Masterltb/pcb/docs/references/pololu-d24v25fx-pinout.jpg

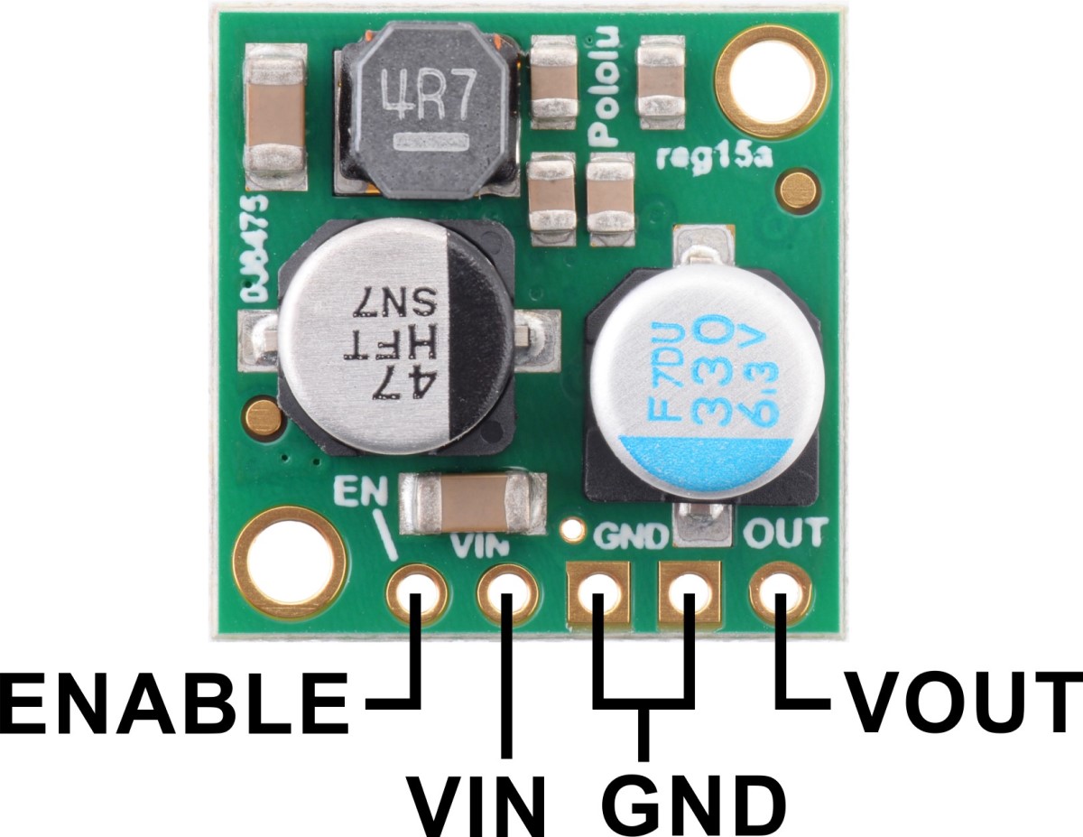
docs/references/pololu-d24v25fx-pinout.jpg
