Masterltb/pcb/FV-CTRL_RevA_Handover/02_Technical_Review/DRC_Report_Mainboard.txt

** Drc report for FV-CTRL_RevA.kicad_pcb **
** Created on 2026-10-18T18:54:26 **
** Report includes: Errors, Warnings, Exclusions **

** Found 539 DRC violations **
[shorting_items]: Items shorting two nets (nets GND and ESP_EN)
    Local override; error
    @(144.2900 mm, 189.5000 mm): Via [GND] on F.Cu - B.Cu
    @(139.0000 mm, 190.0000 mm): Track [ESP_EN] on F.Cu, length 6.5000 mm
[clearance]: Clearance violation ( clearance 0.2000 mm; actual 0.1325 mm)
    Local override; error
    @(137.0000 mm, 172.0000 mm): Via [GND] on F.Cu - B.Cu
    @(141.0000 mm, 172.2000 mm): Track [ESP_EN] on F.Cu, length 3.4000 mm
[shorting_items]: Items shorting two nets (nets GND and +3V3)
    Local override; error
    @(136.0000 mm, 142.5000 mm): Via [GND] on F.Cu - B.Cu
    @(137.2000 mm, 142.4000 mm): Track [+3V3] on F.Cu, length 5.8000 mm
[shorting_items]: Items shorting two nets (nets +12V and IR_RX1)
    Local override; error
    @(114.2000 mm, 140.2000 mm): Track [+12V] on F.Cu, length 3.8000 mm
    @(128.4000 mm, 139.6000 mm): Track [IR_RX1] on F.Cu, length 20.4002 mm
[tracks_crossing]: Tracks crossing
    Local override; error
    @(131.4000 mm, 157.0000 mm): Track [+3V3] on F.Cu, length 11.0000 mm
    @(139.0000 mm, 159.6000 mm): Track [ADC_VP] on F.Cu, length 9.0002 mm
[clearance]: Clearance violation ( clearance 0.2000 mm; actual 0.1250 mm)
    Local override; error
    @(144.2900 mm, 187.5100 mm): Track [GND] on F.Cu, length 1.9900 mm
    @(139.0000 mm, 190.0000 mm): Track [ESP_EN] on F.Cu, length 6.5000 mm
[shorting_items]: Items shorting two nets (nets ESP_EN and GND)
    Local override; error
    @(145.5000 mm, 190.0000 mm): PTH pad 1 [ESP_EN] of SW1
    @(144.2900 mm, 189.5000 mm): Via [GND] on F.Cu - B.Cu
[tracks_crossing]: Tracks crossing
    Local override; error
    @(139.0000 mm, 162.0000 mm): Track [ADC_VN] on B.Cu, length 9.0004 mm
    @(136.2000 mm, 169.4000 mm): Track [EXP_IO13] on B.Cu, length 10.4000 mm
[shorting_items]: Items shorting two nets (nets EXP_IO13 and GND)
    Local override; error
    @(137.4000 mm, 173.0000 mm): Track [EXP_IO13] on B.Cu, length 3.6000 mm
    @(137.0000 mm, 172.0000 mm): Via [GND] on F.Cu - B.Cu
[clearance]: Clearance violation ( clearance 0.2000 mm; actual 0.1850 mm)
    Local override; error
    @(145.6000 mm, 186.4000 mm): Track [EXP_IO13] on F.Cu, length 3.0000 mm
    @(144.2900 mm, 187.5100 mm): Pad 15 [GND] of U2 on F.Cu
[tracks_crossing]: Tracks crossing
    Local override; error
    @(115.0000 mm, 136.0000 mm): Track [+12V] on F.Cu, length 4.2000 mm
    @(128.4000 mm, 139.6000 mm): Track [IR_RX1] on F.Cu, length 20.4002 mm
[clearance]: Clearance violation ( clearance 0.2000 mm; actual 0.1674 mm)
    Local override; error
    @(141.0000 mm, 176.1000 mm): Pad 6 [IR_RX1] of U2 on F.Cu
    @(139.8000 mm, 177.0000 mm): Via [IR_RX2] on F.Cu - B.Cu
[clearance]: Clearance violation ( clearance 0.2000 mm; actual 0.1766 mm)
    Local override; error
    @(141.0000 mm, 179.9100 mm): Pad 9 [SPARE_GPIO33] of U2 on F.Cu
    @(139.8000 mm, 179.0000 mm): Via [LS4] on F.Cu - B.Cu
[clearance]: Clearance violation ( clearance 0.2000 mm; actual 0.1500 mm)
    Local override; error
    @(139.8000 mm, 180.0000 mm): Via [SPARE_GPIO33] on F.Cu - B.Cu
    @(139.8000 mm, 180.8000 mm): Via [LS1] on F.Cu - B.Cu
[tracks_crossing]: Tracks crossing
    Local override; error
    @(161.4000 mm, 170.8000 mm): Track [ESP_IR_TX] on F.Cu, length 13.4000 mm
    @(159.0000 mm, 169.7500 mm): Track [GND] on F.Cu, length 2.5000 mm
[clearance]: Clearance violation ( clearance 0.2000 mm; actual 0.1500 mm)
    Local override; error
    @(139.8000 mm, 180.0000 mm): Via [SPARE_GPIO33] on F.Cu - B.Cu
    @(139.8000 mm, 180.8000 mm): Via [LS1] on F.Cu - B.Cu
[clearance]: Clearance violation ( clearance 0.2000 mm; actual 0.1583 mm)
    Local override; error
    @(141.0000 mm, 179.9100 mm): Pad 9 [SPARE_GPIO33] of U2 on F.Cu
    @(139.8000 mm, 180.8000 mm): Via [LS1] on F.Cu - B.Cu
[clearance]: Clearance violation ( clearance 0.2000 mm; actual 0.1746 mm)
    Local override; error
    @(160.6000 mm, 184.6000 mm): Via [EXP_IO4] on F.Cu - B.Cu
    @(161.4000 mm, 184.8000 mm): Via [ESP_TXD0] on F.Cu - B.Cu
[clearance]: Clearance violation ( clearance 0.2000 mm; actual 0.1746 mm)
    Local override; error
    @(160.6000 mm, 184.6000 mm): Via [EXP_IO4] on F.Cu - B.Cu
    @(161.4000 mm, 184.8000 mm): Via [ESP_TXD0] on F.Cu - B.Cu
[clearance]: Clearance violation ( clearance 0.2000 mm; actual 0.1009 mm)
    Local override; error
    @(137.6000 mm, 172.2000 mm): Track [ESP_EN] on F.Cu, length 4.2000 mm
    @(137.0000 mm, 172.0000 mm): Via [GND] on F.Cu - B.Cu
[tracks_crossing]: Tracks crossing
    Local override; error
    @(137.2000 mm, 142.4000 mm): Track [+3V3] on F.Cu, length 5.8000 mm
    @(136.0000 mm, 140.0000 mm): Track [GND] on F.Cu, length 2.5000 mm
[tracks_crossing]: Tracks crossing
    Local override; error
    @(133.4000 mm, 156.6000 mm): Track [+3V3] on F.Cu, length 13.2000 mm
    @(139.0000 mm, 159.6000 mm): Track [ADC_VP] on F.Cu, length 9.0002 mm
[tracks_crossing]: Tracks crossing
    Local override; error
    @(150.6000 mm, 154.6000 mm): Track [+3V3] on F.Cu, length 15.6000 mm
    @(164.7800 mm, 156.0000 mm): Track [GND] on F.Cu, length 2.5000 mm
[tracks_crossing]: Tracks crossing
    Local override; error
    @(117.4000 mm, 138.6000 mm): Track [+5V] on F.Cu, length 19.2000 mm
    @(128.4000 mm, 139.6000 mm): Track [IR_RX1] on F.Cu, length 20.4002 mm
[shorting_items]: Items shorting two nets (nets +12V and IR_RX1)
    Local override; error
    @(115.0000 mm, 140.2000 mm): Track [+12V] on F.Cu, length 0.8000 mm
    @(128.4000 mm, 139.6000 mm): Track [IR_RX1] on F.Cu, length 20.4002 mm
[shorting_items]: Items shorting two nets (nets GND and ADC_VN)
    Local override; error
    @(138.5000 mm, 169.7500 mm): Via [GND] on F.Cu - B.Cu
    @(139.0000 mm, 174.6000 mm): Track [ADC_VN] on B.Cu, length 12.6000 mm
[shorting_items]: Items shorting two nets (nets GND and +5V)
    Local override; error
    @(132.0000 mm, 141.0000 mm): PTH pad 2 [GND] of C11
    @(131.0000 mm, 140.0000 mm): PTH pad 1 [+5V] of C5
[shorting_items]: Items shorting two nets (nets GND and +5V)
    Local override; error
    @(132.0000 mm, 141.0000 mm): PTH pad 2 [GND] of C11
    @(131.0000 mm, 140.0000 mm): PTH pad 1 [+5V] of C5
[hole_clearance]: Hole clearance violation (board setup constraints hole clearance 0.2500 mm; actual 0.1342 mm)
    Rule: board setup constraints hole; error
    @(145.5000 mm, 190.0000 mm): PTH pad 1 [ESP_EN] of SW1
    @(144.2900 mm, 189.5000 mm): Via [GND] on F.Cu - B.Cu
[hole_clearance]: Hole clearance violation (board setup constraints hole clearance 0.2500 mm; actual 0.1342 mm)
    Rule: board setup constraints hole; error
    @(145.5000 mm, 190.0000 mm): PTH pad 1 [ESP_EN] of SW1
    @(144.2900 mm, 189.5000 mm): Via [GND] on F.Cu - B.Cu
[pth_inside_courtyard]: PTH inside courtyard
    Local override; error
    @(114.7300 mm, 143.9200 mm): PTH pad 1 [+12V] of J4
    @(116.0000 mm, 142.0000 mm): Footprint C6
[courtyards_overlap]: Courtyards overlap
    Rule: board setup constraints courtyard; error
    @(115.0000 mm, 107.0000 mm): Footprint J1
    @(124.0000 mm, 114.0000 mm): Footprint F1
[courtyards_overlap]: Courtyards overlap
    Rule: board setup constraints courtyard; error
    @(147.0000 mm, 156.0000 mm): Footprint J22
    @(150.0000 mm, 178.0000 mm): Footprint U2
[pth_inside_courtyard]: PTH inside courtyard
    Local override; error
    @(147.0000 mm, 156.0000 mm): PTH pad 1 [+5V] of J22
    @(150.0000 mm, 178.0000 mm): Footprint U2
[pth_inside_courtyard]: PTH inside courtyard
    Local override; error
    @(149.5400 mm, 156.0000 mm): PTH pad 2 [+3V3] of J22
    @(150.0000 mm, 178.0000 mm): Footprint U2
[pth_inside_courtyard]: PTH inside courtyard
    Local override; error
    @(152.0800 mm, 156.0000 mm): PTH pad 3 [EXP_IO4] of J22
    @(150.0000 mm, 178.0000 mm): Footprint U2
[pth_inside_courtyard]: PTH inside courtyard
    Local override; error
    @(154.6200 mm, 156.0000 mm): PTH pad 4 [EXP_IO5] of J22
    @(150.0000 mm, 178.0000 mm): Footprint U2
[pth_inside_courtyard]: PTH inside courtyard
    Local override; error
    @(157.1600 mm, 156.0000 mm): PTH pad 5 [EXP_IO13] of J22
    @(150.0000 mm, 178.0000 mm): Footprint U2
[pth_inside_courtyard]: PTH inside courtyard
    Local override; error
    @(159.7000 mm, 156.0000 mm): PTH pad 6 [EXP_IO14] of J22
    @(150.0000 mm, 178.0000 mm): Footprint U2
[pth_inside_courtyard]: PTH inside courtyard
    Local override; error
    @(162.2400 mm, 156.0000 mm): PTH pad 7 [EXP_IO2] of J22
    @(150.0000 mm, 178.0000 mm): Footprint U2
[pth_inside_courtyard]: PTH inside courtyard
    Local override; error
    @(164.7800 mm, 156.0000 mm): PTH pad 8 [GND] of J22
    @(150.0000 mm, 178.0000 mm): Footprint U2
[courtyards_overlap]: Courtyards overlap
    Rule: board setup constraints courtyard; error
    @(166.0000 mm, 190.0000 mm): Footprint R11
    @(171.0000 mm, 189.0000 mm): Footprint R1
[pth_inside_courtyard]: PTH inside courtyard
    Local override; error
    @(171.0000 mm, 189.0000 mm): PTH pad 1 [ESP_S1_TOP_PWM] of R1
    @(166.0000 mm, 190.0000 mm): Footprint R11
[pth_inside_courtyard]: PTH inside courtyard
    Local override; error
    @(173.6200 mm, 190.0000 mm): PTH pad 2 [ESP_IO0] of R11
    @(171.0000 mm, 189.0000 mm): Footprint R1
[courtyards_overlap]: Courtyards overlap
    Rule: board setup constraints courtyard; error
    @(194.0000 mm, 182.0000 mm): Footprint J6
    @(194.0000 mm, 175.0000 mm): Footprint J7
[pth_inside_courtyard]: PTH inside courtyard
    Local override; error
    @(194.0000 mm, 180.0800 mm): PTH pad 3 [S2_TOP_PWM] of J7
    @(194.0000 mm, 182.0000 mm): Footprint J6
[pth_inside_courtyard]: PTH inside courtyard
    Local override; error
    @(194.0000 mm, 182.0000 mm): PTH pad 1 [GND] of J6
    @(194.0000 mm, 175.0000 mm): Footprint J7
[courtyards_overlap]: Courtyards overlap
    Rule: board setup constraints courtyard; error
    @(194.0000 mm, 182.0000 mm): Footprint J6
    @(194.0000 mm, 189.0000 mm): Footprint J5
[pth_inside_courtyard]: PTH inside courtyard
    Local override; error
    @(194.0000 mm, 189.0000 mm): PTH pad 1 [GND] of J5
    @(194.0000 mm, 182.0000 mm): Footprint J6
[pth_inside_courtyard]: PTH inside courtyard
    Local override; error
    @(194.0000 mm, 187.0800 mm): PTH pad 3 [S1_BOT_PWM] of J6
    @(194.0000 mm, 189.0000 mm): Footprint J5
[courtyards_overlap]: Courtyards overlap
    Rule: board setup constraints courtyard; error
    @(194.0000 mm, 168.0000 mm): Footprint J8
    @(194.0000 mm, 175.0000 mm): Footprint J7
[pth_inside_courtyard]: PTH inside courtyard
    Local override; error
    @(194.0000 mm, 175.0000 mm): PTH pad 1 [GND] of J7
    @(194.0000 mm, 168.0000 mm): Footprint J8
[pth_inside_courtyard]: PTH inside courtyard
    Local override; error
    @(194.0000 mm, 173.0800 mm): PTH pad 3 [S2_BOT_PWM] of J8
    @(194.0000 mm, 175.0000 mm): Footprint J7
[courtyards_overlap]: Courtyards overlap
    Rule: board setup constraints courtyard; error
    @(171.0000 mm, 168.0000 mm): Footprint R4
    @(150.0000 mm, 178.0000 mm): Footprint U2
[pth_inside_courtyard]: PTH inside courtyard
    Local override; error
    @(171.0000 mm, 168.0000 mm): PTH pad 1 [ESP_S2_BOT_PWM] of R4
    @(150.0000 mm, 178.0000 mm): Footprint U2
[courtyards_overlap]: Courtyards overlap
    Rule: board setup constraints courtyard; error
    @(186.0000 mm, 148.0000 mm): Footprint F3
    @(186.0000 mm, 156.0000 mm): Footprint C2
[courtyards_overlap]: Courtyards overlap
    Rule: board setup constraints courtyard; error
    @(124.0000 mm, 134.0000 mm): Footprint R23
    @(115.0000 mm, 136.0000 mm): Footprint D1
[pth_inside_courtyard]: PTH inside courtyard
    Local override; error
    @(127.7000 mm, 136.0000 mm): PTH pad 2 [GND] of D1
    @(124.0000 mm, 134.0000 mm): Footprint R23
[pth_inside_courtyard]: PTH inside courtyard
    Local override; error
    @(124.0000 mm, 134.0000 mm): PTH pad 1 [+5V] of R23
    @(115.0000 mm, 136.0000 mm): Footprint D1
[courtyards_overlap]: Courtyards overlap
    Rule: board setup constraints courtyard; error
    @(127.0000 mm, 166.0000 mm): Footprint Q2
    @(130.0000 mm, 157.0000 mm): Footprint J21
[courtyards_overlap]: Courtyards overlap
    Rule: board setup constraints courtyard; error
    @(127.0000 mm, 166.0000 mm): Footprint Q2
    @(150.0000 mm, 178.0000 mm): Footprint U2
[pth_inside_courtyard]: PTH inside courtyard
    Local override; error
    @(127.0000 mm, 166.0000 mm): PTH pad 1 [GND] of Q2
    @(150.0000 mm, 178.0000 mm): Footprint U2
[pth_inside_courtyard]: PTH inside courtyard
    Local override; error
    @(127.0000 mm, 164.7300 mm): PTH pad 2 [NET_Q2_BASE] of Q2
    @(150.0000 mm, 178.0000 mm): Footprint U2
[pth_inside_courtyard]: PTH inside courtyard
    Local override; error
    @(127.0000 mm, 163.4600 mm): PTH pad 3 [IR_TX_RET] of Q2
    @(150.0000 mm, 178.0000 mm): Footprint U2
[courtyards_overlap]: Courtyards overlap
    Rule: board setup constraints courtyard; error
    @(127.0000 mm, 166.0000 mm): Footprint Q2
    @(130.0000 mm, 168.0000 mm): Footprint R10
[courtyards_overlap]: Courtyards overlap
    Rule: board setup constraints courtyard; error
    @(196.0000 mm, 196.0000 mm): Footprint H4
    @(194.0000 mm, 189.0000 mm): Footprint J5
[pth_inside_courtyard]: PTH inside courtyard
    Local override; error
    @(194.0000 mm, 194.0800 mm): PTH pad 3 [S1_TOP_PWM] of J5
    @(196.0000 mm, 196.0000 mm): Footprint H4
[npth_inside_courtyard]: NPTH inside courtyard
    Local override; error
    @(196.0000 mm, 196.0000 mm): NPTH pad of H4
    @(194.0000 mm, 189.0000 mm): Footprint J5
[courtyards_overlap]: Courtyards overlap
    Rule: board setup constraints courtyard; error
    @(108.0000 mm, 195.0000 mm): Footprint TP6
    @(104.0000 mm, 196.0000 mm): Footprint H3
[courtyards_overlap]: Courtyards overlap
    Rule: board setup constraints courtyard; error
    @(130.0000 mm, 157.0000 mm): Footprint J21
    @(127.0000 mm, 158.0000 mm): Footprint R13
[courtyards_overlap]: Courtyards overlap
    Rule: board setup constraints courtyard; error
    @(130.0000 mm, 157.0000 mm): Footprint J21
    @(150.0000 mm, 178.0000 mm): Footprint U2
[pth_inside_courtyard]: PTH inside courtyard
    Local override; error
    @(130.0000 mm, 157.0000 mm): PTH pad 1 [+3V3] of J21
    @(150.0000 mm, 178.0000 mm): Footprint U2
[pth_inside_courtyard]: PTH inside courtyard
    Local override; error
    @(130.0000 mm, 159.5400 mm): PTH pad 2 [ADC_VP] of J21
    @(150.0000 mm, 178.0000 mm): Footprint U2
[pth_inside_courtyard]: PTH inside courtyard
    Local override; error
    @(130.0000 mm, 162.0800 mm): PTH pad 3 [ADC_VN] of J21
    @(150.0000 mm, 178.0000 mm): Footprint U2
[pth_inside_courtyard]: PTH inside courtyard
    Local override; error
    @(130.0000 mm, 164.6200 mm): PTH pad 4 [GND] of J21
    @(150.0000 mm, 178.0000 mm): Footprint U2
[courtyards_overlap]: Courtyards overlap
    Rule: board setup constraints courtyard; error
    @(127.0000 mm, 158.0000 mm): Footprint R13
    @(150.0000 mm, 178.0000 mm): Footprint U2
[pth_inside_courtyard]: PTH inside courtyard
    Local override; error
    @(127.0000 mm, 158.0000 mm): PTH pad 1 [ESP_IR_TX] of R13
    @(150.0000 mm, 178.0000 mm): Footprint U2
[pth_inside_courtyard]: PTH inside courtyard
    Local override; error
    @(127.0000 mm, 150.3800 mm): PTH pad 2 [NET_Q2_BASE] of R13
    @(150.0000 mm, 178.0000 mm): Footprint U2
[courtyards_overlap]: Courtyards overlap
    Rule: board setup constraints courtyard; error
    @(114.0000 mm, 195.0000 mm): Footprint J15
    @(122.0000 mm, 195.0000 mm): Footprint J16
[courtyards_overlap]: Courtyards overlap
    Rule: board setup constraints courtyard; error
    @(138.0000 mm, 148.0000 mm): Footprint U3
    @(150.0000 mm, 178.0000 mm): Footprint U2
[courtyards_overlap]: Courtyards overlap
    Rule: board setup constraints courtyard; error
    @(146.0000 mm, 142.0000 mm): Footprint R24
    @(154.0000 mm, 140.0000 mm): Footprint TP2
[courtyards_overlap]: Courtyards overlap
    Rule: board setup constraints courtyard; error
    @(139.0000 mm, 190.0000 mm): Footprint SW1
    @(129.0000 mm, 195.0000 mm): Footprint J3
[courtyards_overlap]: Courtyards overlap
    Rule: board setup constraints courtyard; error
    @(139.0000 mm, 190.0000 mm): Footprint SW1
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
    @(131.0000 mm, 140.0000 mm): Footprint C5
[pth_inside_courtyard]: PTH inside courtyard
    Local override; error
    @(131.0000 mm, 140.0000 mm): PTH pad 1 [+5V] of C5
    @(130.0000 mm, 141.0000 mm): Footprint C11
[courtyards_overlap]: Courtyards overlap
    Rule: board setup constraints courtyard; error
    @(154.0000 mm, 146.0000 mm): Footprint R21
    @(149.0000 mm, 148.0000 mm): Footprint C13
[courtyards_overlap]: Courtyards overlap
    Rule: board setup constraints courtyard; error
    @(164.0000 mm, 152.0000 mm): Footprint D4
    @(166.0000 mm, 150.0000 mm): Footprint TP7
[courtyards_overlap]: Courtyards overlap
    Rule: board setup constraints courtyard; error
    @(146.0000 mm, 146.0000 mm): Footprint D6
    @(149.0000 mm, 148.0000 mm): Footprint C13
[pth_inside_courtyard]: PTH inside courtyard
    Local override; error
    @(149.0000 mm, 148.0000 mm): PTH pad 1 [+3V3] of C13
    @(146.0000 mm, 146.0000 mm): Footprint D6
[courtyards_overlap]: Courtyards overlap
    Rule: board setup constraints courtyard; error
    @(146.0000 mm, 146.0000 mm): Footprint D6
    @(144.0000 mm, 148.0000 mm): Footprint C12
[pth_inside_courtyard]: PTH inside courtyard
    Local override; error
    @(146.0000 mm, 148.0000 mm): PTH pad 2 [GND] of C12
    @(146.0000 mm, 146.0000 mm): Footprint D6
[pth_inside_courtyard]: PTH inside courtyard
    Local override; error
    @(146.0000 mm, 146.0000 mm): PTH pad 1 [NET_D6_ANODE] of D6
    @(144.0000 mm, 148.0000 mm): Footprint C12
[courtyards_overlap]: Courtyards overlap
    Rule: board setup constraints courtyard; error
    @(144.0000 mm, 148.0000 mm): Footprint C12
    @(146.0000 mm, 150.0000 mm): Footprint TP5
[solder_mask_bridge]: Front solder mask aperture bridges items with different nets
    Rule: board setup solder mask min width; error
    @(144.2900 mm, 189.5000 mm): Via [GND] on F.Cu - B.Cu
    @(145.5000 mm, 190.0000 mm): PTH pad 1 [ESP_EN] of SW1
[solder_mask_bridge]: Rear solder mask aperture bridges items with different nets
    Rule: board setup solder mask min width; error
    @(144.2900 mm, 189.5000 mm): Via [GND] on F.Cu - B.Cu
    @(145.5000 mm, 190.0000 mm): PTH pad 1 [ESP_EN] of SW1
[solder_mask_bridge]: Front solder mask aperture bridges items with different nets
    Rule: board setup solder mask min width; error
    @(132.0000 mm, 141.0000 mm): PTH pad 2 [GND] of C11
    @(131.0000 mm, 140.0000 mm): PTH pad 1 [+5V] of C5
[solder_mask_bridge]: Rear solder mask aperture bridges items with different nets
    Rule: board setup solder mask min width; error
    @(132.0000 mm, 141.0000 mm): PTH pad 2 [GND] of C11
    @(131.0000 mm, 140.0000 mm): PTH pad 1 [+5V] of C5
[silk_edge_clearance]: Silkscreen clipped by board edge
    Rule: board setup constraints silk; warning
    @(100.0000 mm, 100.0000 mm): Segment on Edge.Cuts
    @(104.0000 mm, 99.8500 mm): Reference field of H1
[silk_edge_clearance]: Silkscreen clipped by board edge
    Rule: board setup constraints silk; warning
    @(100.0000 mm, 100.0000 mm): Segment on Edge.Cuts
    @(196.0000 mm, 99.8500 mm): Reference field of H2
[silk_edge_clearance]: Silkscreen clipped by board edge
    Rule: board setup constraints silk; warning
    @(100.0000 mm, 100.0000 mm): Segment on Edge.Cuts
    @(166.0000 mm, 100.5000 mm): Reference field of J2
[holes_co_located]: Drilled holes co-located
    Local override; warning
    @(119.6000 mm, 162.6000 mm): Via [+3V3] on F.Cu - B.Cu
    @(119.6000 mm, 162.6000 mm): Via [+3V3] on F.Cu - B.Cu
[hole_to_hole]: Drilled hole too close to other hole (board setup constraints min 0.2500 mm; actual 0.0972 mm)
    Rule: board setup constraints; warning
    @(136.4000 mm, 154.6000 mm): Via [+3V3] on F.Cu - B.Cu
    @(136.6000 mm, 155.0000 mm): Via [+3V3] on F.Cu - B.Cu
[silk_overlap]: Silkscreen clearance
    Rule: board setup constraints silk; warning
    @(136.1200 mm, 141.3700 mm): Segment of C5 on F.Silkscreen
    @(133.3600 mm, 139.9020 mm): Segment of C11 on F.Silkscreen
[silk_overlap]: Silkscreen clearance
    Rule: board setup constraints silk; warning
    @(136.1200 mm, 141.3700 mm): Segment of C5 on F.Silkscreen
    @(133.4000 mm, 139.9890 mm): Segment of C11 on F.Silkscreen
[silk_overlap]: Silkscreen clearance
    Rule: board setup constraints silk; warning
    @(136.1200 mm, 141.3700 mm): Segment of C5 on F.Silkscreen
    @(133.4400 mm, 140.0860 mm): Segment of C11 on F.Silkscreen
[silk_overlap]: Silkscreen clearance
    Rule: board setup constraints silk; warning
    @(136.1200 mm, 141.3700 mm): Segment of C5 on F.Silkscreen
    @(133.4800 mm, 140.1950 mm): Segment of C11 on F.Silkscreen
[silk_overlap]: Silkscreen clearance
    Rule: board setup constraints silk; warning
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
[silk_over_copper]: Silkscreen clipped by solder mask
    Local override; warning
    @(188.5000 mm, 156.0000 mm): Circle of C2 on F.Silkscreen
    @(191.1000 mm, 149.2000 mm): PTH pad 2 [+6V_B] of F3
[silk_over_copper]: Silkscreen clipped by solder mask
    Local override; warning
    @(191.1400 mm, 150.2430 mm): Segment of C2 on F.Silkscreen
    @(191.1000 mm, 149.2000 mm): PTH pad 2 [+6V_B] of F3
[silk_over_copper]: Silkscreen clipped by solder mask
    Local override; warning
    @(191.1800 mm, 150.2610 mm): Segment of C2 on F.Silkscreen
    @(191.1000 mm, 149.2000 mm): PTH pad 2 [+6V_B] of F3
[silk_over_copper]: Silkscreen clipped by solder mask
    Local override; warning
    @(166.5400 mm, 188.6300 mm): Segment of R11 on F.Silkscreen
    @(171.0000 mm, 189.0000 mm): PTH pad 1 [ESP_S1_TOP_PWM] of R1
[silk_over_copper]: Silkscreen clipped by solder mask
    Local override; warning
    @(171.5400 mm, 190.3700 mm): Segment of R1 on F.Silkscreen
    @(173.6200 mm, 190.0000 mm): PTH pad 2 [ESP_IO0] of R11
[silk_over_copper]: Silkscreen clipped by solder mask
    Local override; warning
    @(155.6200 mm, 195.0000 mm): Reference field of J20
    @(154.5000 mm, 194.5000 mm): PTH pad 2 [GND] of SW2
[silk_over_copper]: Silkscreen clipped by solder mask
    Local override; warning
    @(192.6200 mm, 180.6200 mm): Segment of J6 on F.Silkscreen
    @(194.0000 mm, 180.0800 mm): PTH pad 3 [S2_TOP_PWM] of J7
[silk_over_copper]: Silkscreen clipped by solder mask
    Local override; warning
    @(194.0000 mm, 186.6200 mm): Reference field of J5
    @(194.0000 mm, 187.0800 mm): PTH pad 3 [S1_BOT_PWM] of J6
[silk_over_copper]: Silkscreen clipped by solder mask
    Local override; warning
    @(192.6200 mm, 188.4600 mm): Segment of J6 on F.Silkscreen
    @(194.0000 mm, 189.0000 mm): PTH pad 1 [GND] of J5
[silk_over_copper]: Silkscreen clipped by solder mask
    Local override; warning
    @(192.6200 mm, 195.4600 mm): Segment of J5 on F.Silkscreen
    @(196.0000 mm, 196.0000 mm): NPTH pad of H4
[silk_over_copper]: Silkscreen clipped by solder mask
    Local override; warning
    @(195.3800 mm, 190.2700 mm): Segment of J5 on F.Silkscreen
    @(196.0000 mm, 196.0000 mm): NPTH pad of H4
[silk_over_copper]: Silkscreen clipped by solder mask
    Local override; warning
    @(192.6200 mm, 187.6200 mm): Segment of J5 on F.Silkscreen
    @(194.0000 mm, 187.0800 mm): PTH pad 3 [S1_BOT_PWM] of J6
[silk_over_copper]: Silkscreen clipped by solder mask
    Local override; warning
    @(165.2700 mm, 149.0400 mm): Reference field of D4
    @(166.0000 mm, 150.0000 mm): Pad 1 [GND] of TP7 on F.Cu
[silk_over_copper]: Silkscreen clipped by solder mask
    Local override; warning
    @(165.2700 mm, 152.0000 mm): Arc of D4 on F.Silkscreen
    @(166.0000 mm, 150.0000 mm): Pad 1 [GND] of TP7 on F.Cu
[silk_over_copper]: Silkscreen clipped by solder mask
    Local override; warning
    @(166.0000 mm, 150.0000 mm): Circle of TP7 on F.Silkscreen
    @(166.5400 mm, 152.0000 mm): PTH pad 2 [GND] of D4
[silk_over_copper]: Silkscreen clipped by solder mask
    Local override; warning
    @(165.2700 mm, 152.0000 mm): Arc of D4 on F.Silkscreen
    @(166.0000 mm, 150.0000 mm): Pad 1 [GND] of TP7 on F.Cu
[silk_over_copper]: Silkscreen clipped by solder mask
    Local override; warning
    @(151.2500 mm, 188.0000 mm): Reference field of SW2
    @(150.6400 mm, 187.5100 mm): Pad 20 [<no net>] of U2 on F.Cu
[silk_over_copper]: Silkscreen clipped by solder mask
    Local override; warning
    @(151.2500 mm, 188.0000 mm): Reference field of SW2
    @(151.9100 mm, 187.5100 mm): Pad 21 [<no net>] of U2 on F.Cu
[silk_over_copper]: Silkscreen clipped by solder mask
    Local override; warning
    @(145.7600 mm, 149.0400 mm): Segment of C12 on F.Silkscreen
    @(146.0000 mm, 150.0000 mm): Pad 1 [+3V3] of TP5 on F.Cu
[silk_over_copper]: Silkscreen clipped by solder mask
    Local override; warning
    @(145.8000 mm, 149.0400 mm): Segment of C12 on F.Silkscreen
    @(146.0000 mm, 150.0000 mm): Pad 1 [+3V3] of TP5 on F.Cu
[silk_over_copper]: Silkscreen clipped by solder mask
    Local override; warning
    @(146.0000 mm, 150.0000 mm): Circle of TP5 on F.Silkscreen
    @(146.0000 mm, 148.0000 mm): PTH pad 2 [GND] of C12
[silk_over_copper]: Silkscreen clipped by solder mask
    Local override; warning
    @(147.2700 mm, 146.0000 mm): Arc of D6 on F.Silkscreen
    @(149.0000 mm, 148.0000 mm): PTH pad 1 [+3V3] of C13
[silk_over_copper]: Silkscreen clipped by solder mask
    Local override; warning
    @(147.2700 mm, 146.0000 mm): Arc of D6 on F.Silkscreen
    @(146.0000 mm, 148.0000 mm): PTH pad 2 [GND] of C12
[silk_over_copper]: Silkscreen clipped by solder mask
    Local override; warning
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
    @(146.0000 mm, 146.0000 mm): PTH pad 1 [NET_D6_ANODE] of D6
[silk_over_copper]: Silkscreen clipped by solder mask
    Local override; warning
    @(146.4400 mm, 145.8510 mm): Segment of C12 on F.Silkscreen
    @(146.0000 mm, 146.0000 mm): PTH pad 1 [NET_D6_ANODE] of D6

** Found 4 unconnected pads **
[unconnected_items]: Missing connection between items
    Local override; error
    @(100.5000 mm, 100.5000 mm): Zone [GND] on F.Cu, priority 0
    @(100.5000 mm, 100.5000 mm): Zone [GND] on B.Cu, priority 0
[unconnected_items]: Missing connection between items
    Local override; error
    @(100.5000 mm, 100.5000 mm): Zone [GND] on B.Cu, priority 0
    @(100.5000 mm, 100.5000 mm): Zone [GND] on F.Cu, priority 0
[unconnected_items]: Missing connection between items
    Local override; error
    @(159.0000 mm, 169.7500 mm): Track [GND] on F.Cu, length 2.5000 mm
    @(150.8450 mm, 175.5650 mm): Pad 39 [GND] of U2 on F.Cu
[unconnected_items]: Missing connection between items
    Local override; error
    @(166.5400 mm, 152.0000 mm): PTH pad 2 [GND] of D4
    @(100.5000 mm, 100.5000 mm): Zone [GND] on F.Cu, priority 0

** Found 0 Footprint errors **

** Ignored checks **
    - Footprint has no courtyard defined
    - Track endpoint not centered on via
    - Tuning profile track geometries
    - Footprint doesn't match symbol's footprint filters
    - Footprint component type doesn't match footprint pads

** End of Report **
