Masterltb/pcb/FV-CTRL_RevA_Handover/02_Technical_Review/DRC_Report_Satellite_IR.txt

** Drc report for FV-IR-RX_RevA.kicad_pcb **
** Created on 2026-10-18T13:38:04 **
** Report includes: Errors, Warnings, Exclusions **

** Found 0 DRC violations **

** Found 0 unconnected pads **

** Found 0 Footprint errors **

** Ignored checks **
    - Footprint has no courtyard defined
    - Track endpoint not centered on via
    - Tuning profile track geometries
    - Footprint doesn't match symbol's footprint filters
    - Footprint component type doesn't match footprint pads

** End of Report **
