Masterltb/pcb/FV-CTRL_RevA_Handover/02_Technical_Review/ERC_Report_Mainboard.txt

ERC report (2026-10-18T18:56:08, Encoding UTF8)
Report includes: Errors, Warnings

***** Sheet /

 ** ERC messages: 0  Errors 0  Warnings 0

 ** Ignored checks:
    - Global label only appears once in the schematic
    - Four connection points are joined together
    - SPICE model issue
    - Assigned footprint doesn't match footprint filters
