Masterltb/pcb/docs/project/rev-notes.md

# RevA2 physical qualification log

No physical boards tested as of 2026-10-20.

Record: serial, BOM/PCB revision, supply, harness lengths, ambient temperature, rail voltages and ripple, load currents, component temperatures, IR bowl tests, cycle count, injected fault and recovery result. Attach measurements and corrective actions.
