Masterltb/pcb/releases/archive/README.md

# Gói lịch sử — không phải bản phát hành RevB

Các Gerber, ZIP và handover trong khu archive thuộc RevA/RevA2. Chúng được di chuyển nguyên trạng để bảo toàn lịch sử, chưa được phê duyệt lại. Không dùng để đặt PCB RevB.
