Masterltb/pcb/hardware/archive/reva/README.md

# RevA lịch sử

Nguồn trong thư mục này được giữ để tra cứu và bảo toàn công việc cũ. Không dùng thay cho RevB. Một số file có sửa đổi cục bộ chưa commit từ trước đợt sắp xếp; các thay đổi đó được giữ nguyên nội dung, chưa được kiểm định hoặc đưa vào commit tái cấu trúc.

Project hiện hành: `../../revb/FV-CTRL_RevB.kicad_pro`. Đọc README ở gốc repository trước khi chọn file chế tạo.
