Masterltb/pcb/docs/reva2/RevA2-bottom.png

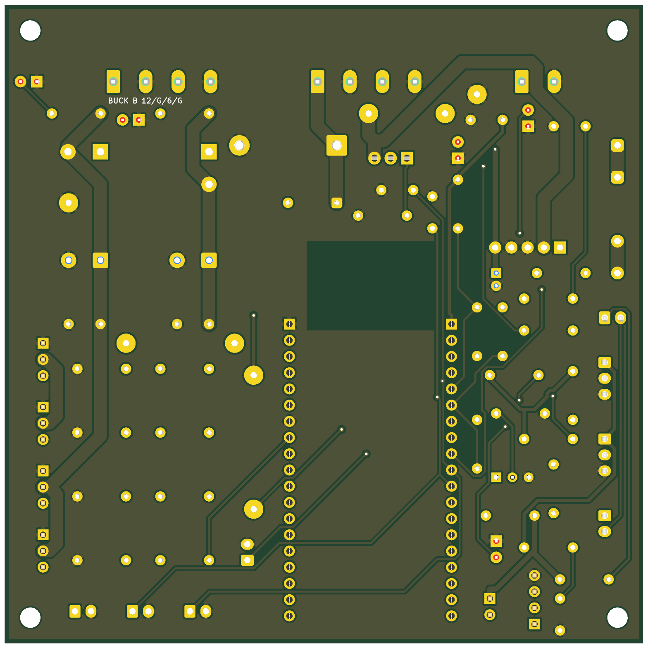
docs/reva2/RevA2-bottom.png
