Masterltb/pcb/docs/reva2/RevA2-top.png

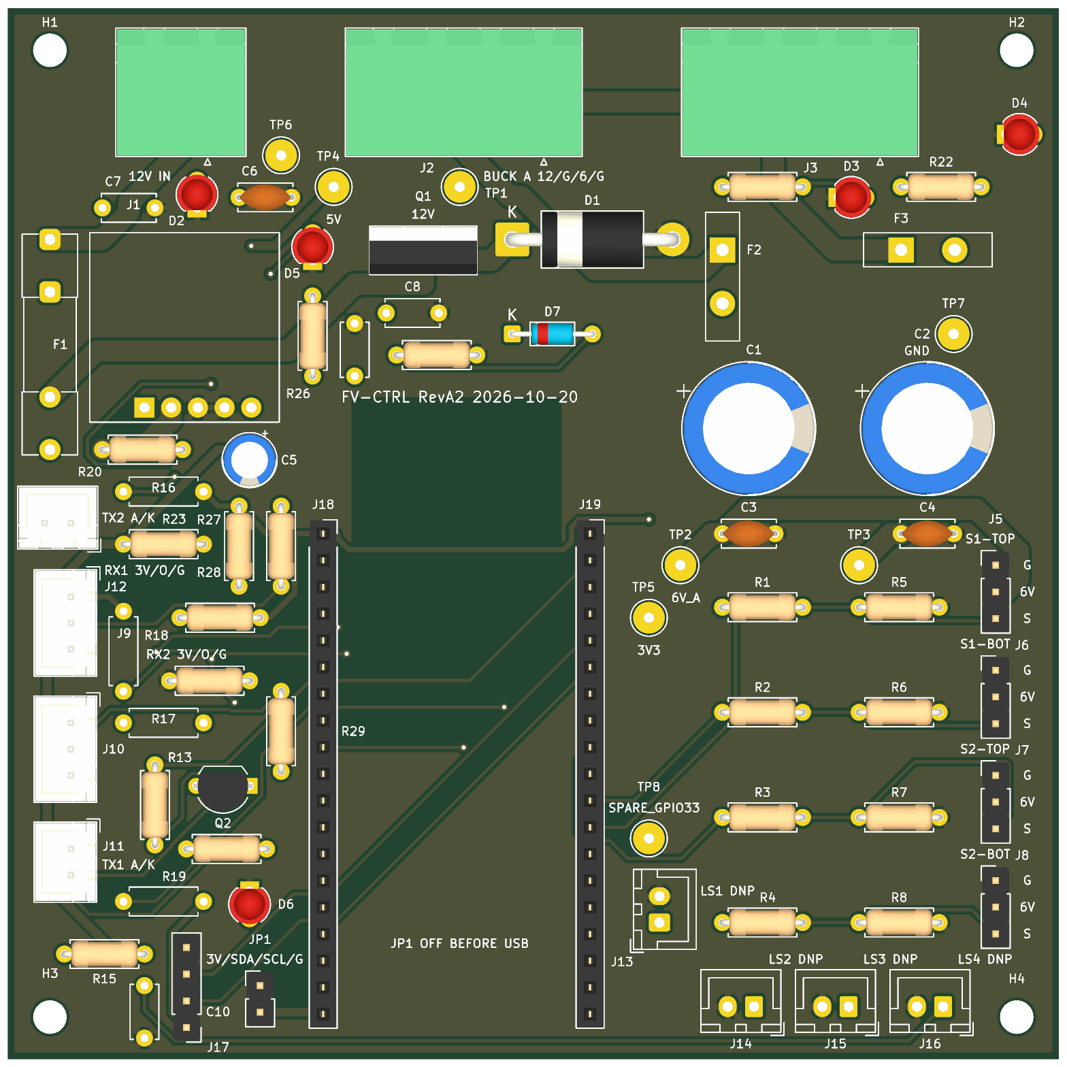
docs/reva2/RevA2-top.png
