Masterltb/pcb/docs/revb/schematic/FV-CTRL_RevB-1. Power.png

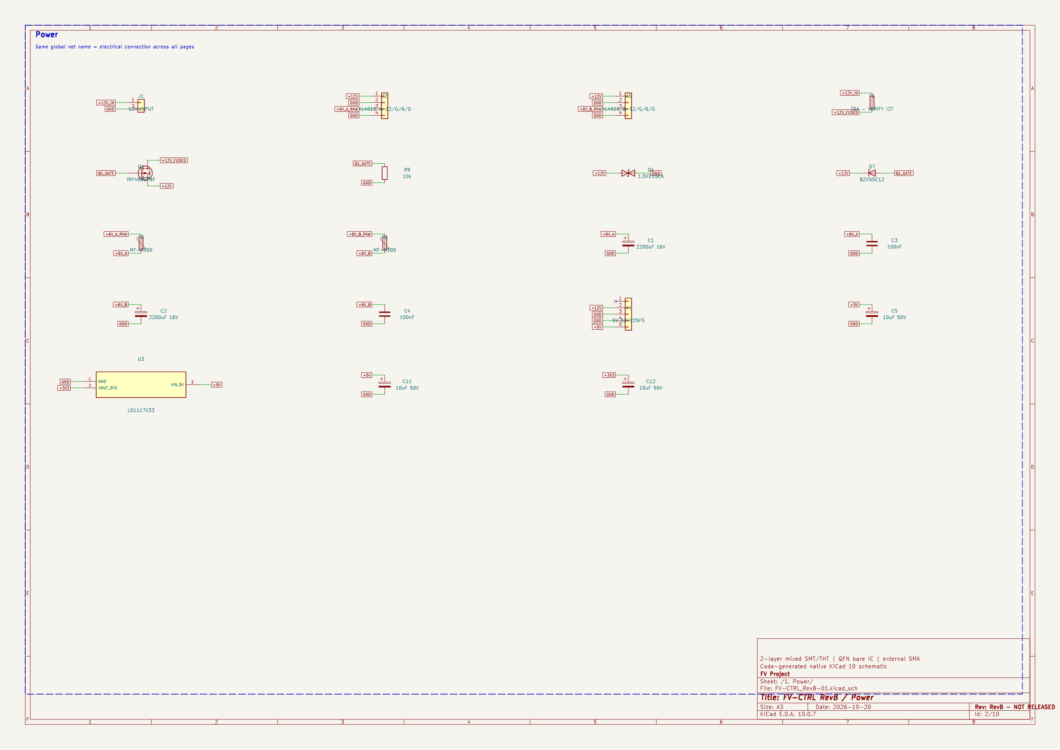
docs/revb/schematic/FV-CTRL_RevB-1. Power.png
