Masterltb/pcb/docs/revb/schematic/FV-CTRL_RevB-2. ESP32 core.png

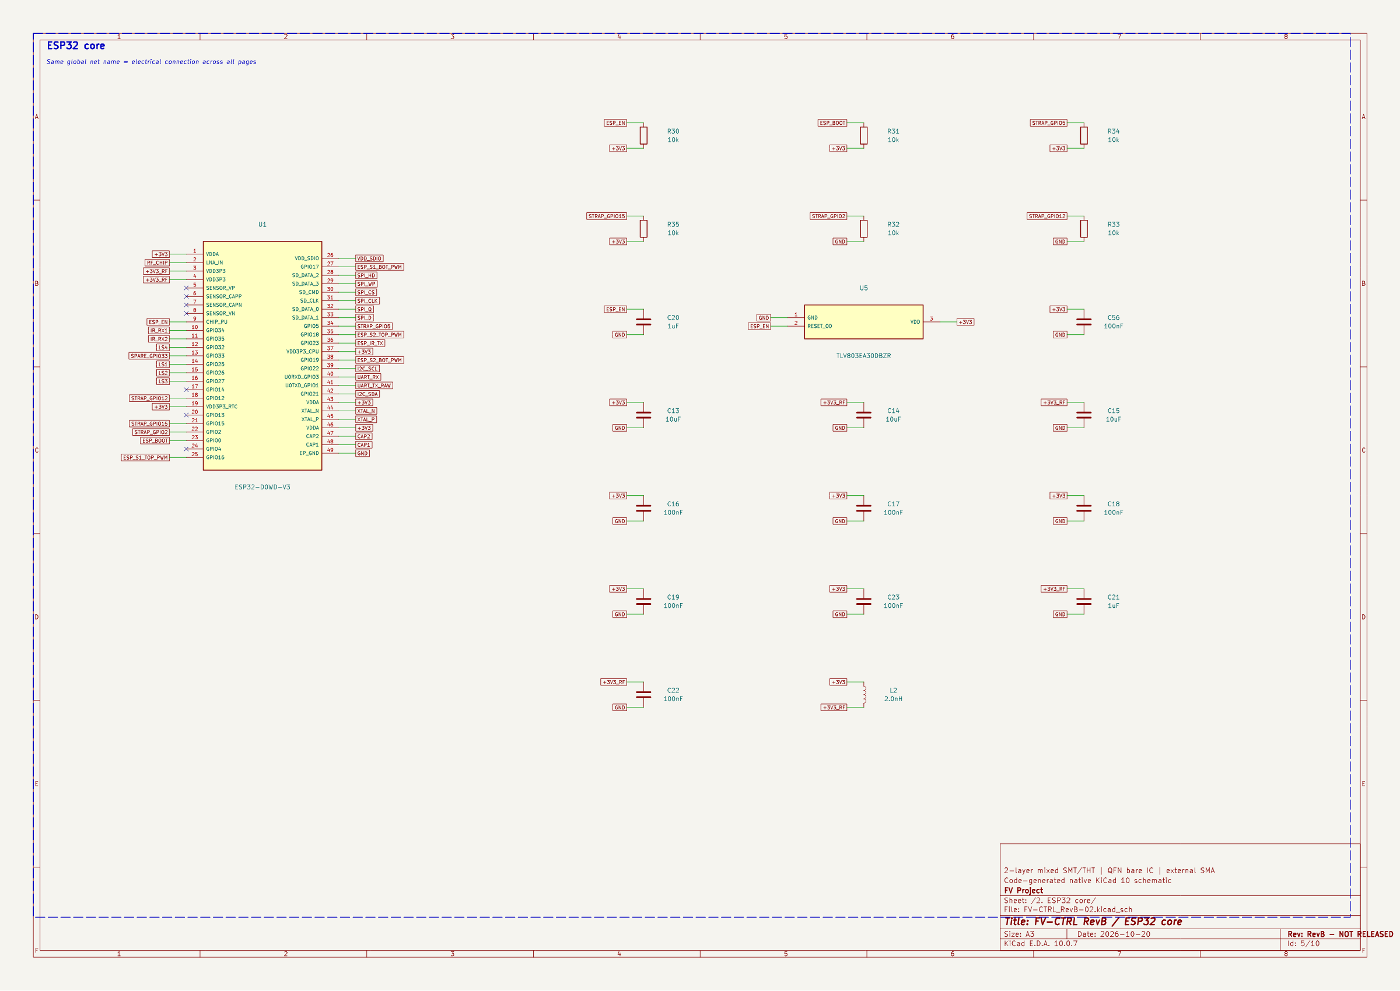
docs/revb/schematic/FV-CTRL_RevB-2. ESP32 core.png
