Masterltb/pcb/docs/revb/schematic/FV-CTRL_RevB-3. Clock _ RF.png

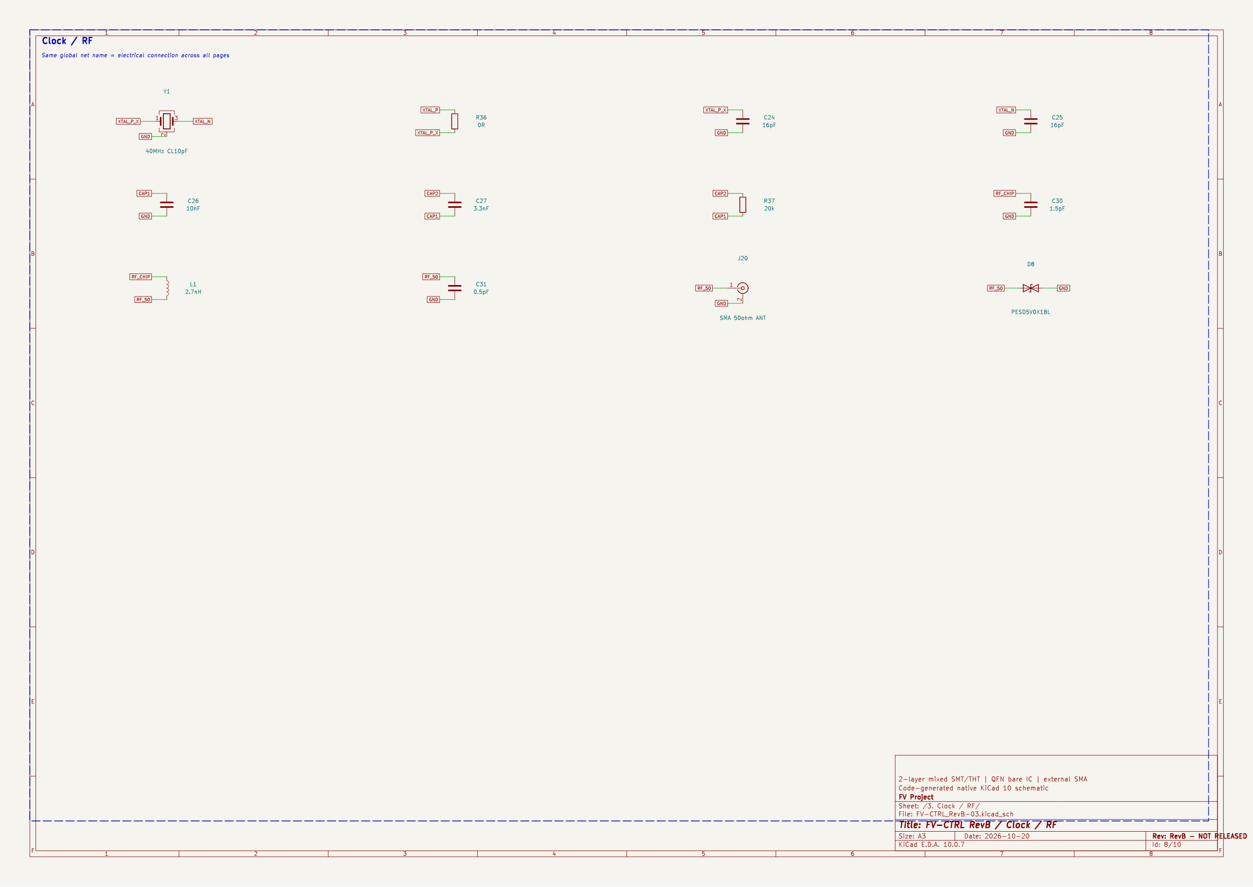
docs/revb/schematic/FV-CTRL_RevB-3. Clock _ RF.png
