Masterltb/pcb/docs/revb/schematic/FV-CTRL_RevB-6. IR.png

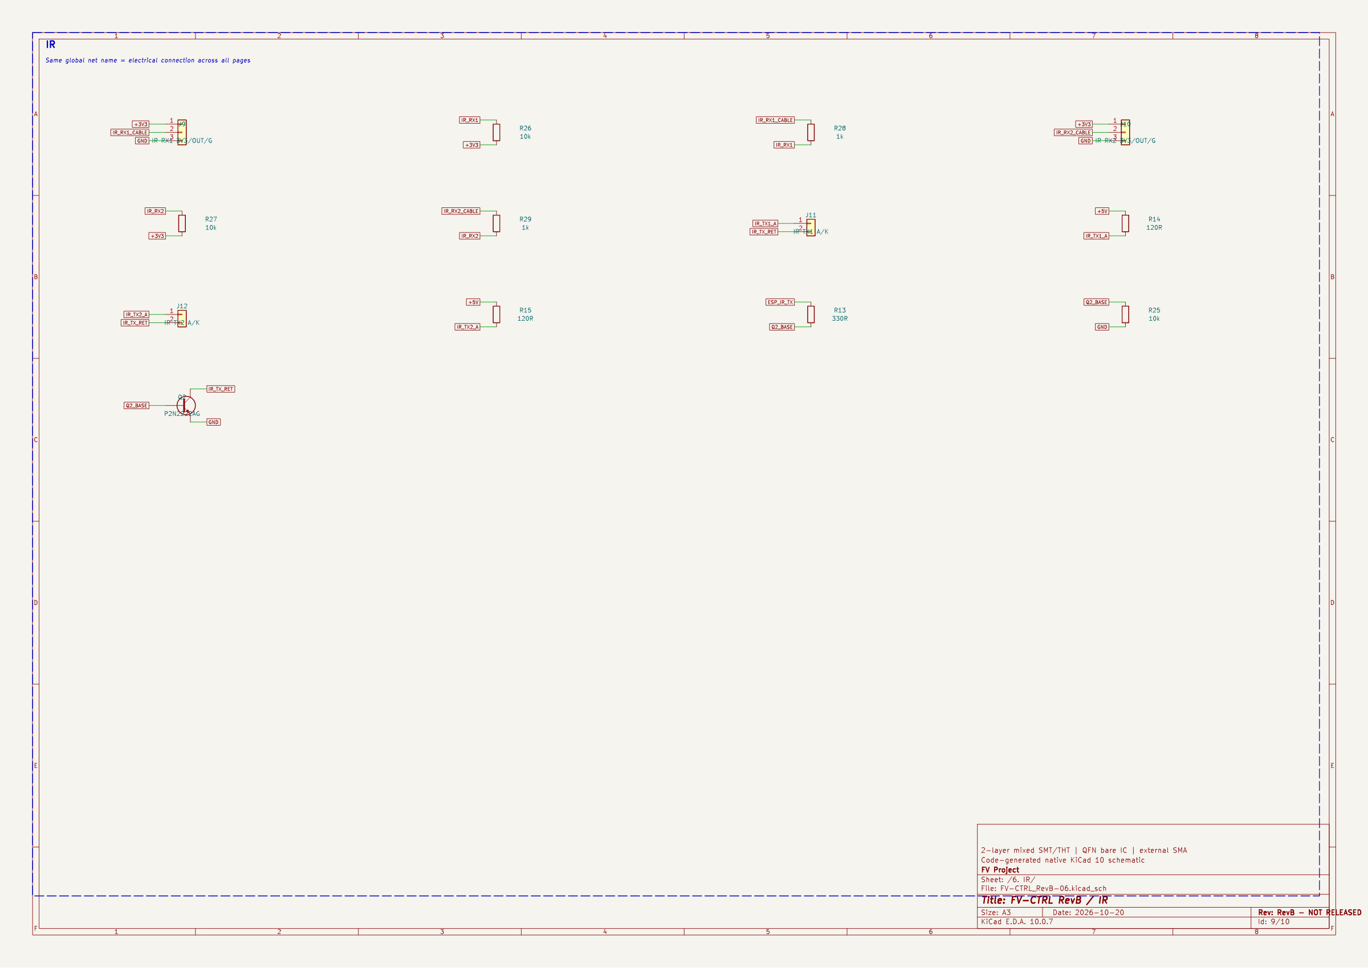
docs/revb/schematic/FV-CTRL_RevB-6. IR.png
