Masterltb/pcb/docs/revb/schematic/FV-CTRL_RevB-8. Diagnostics.png

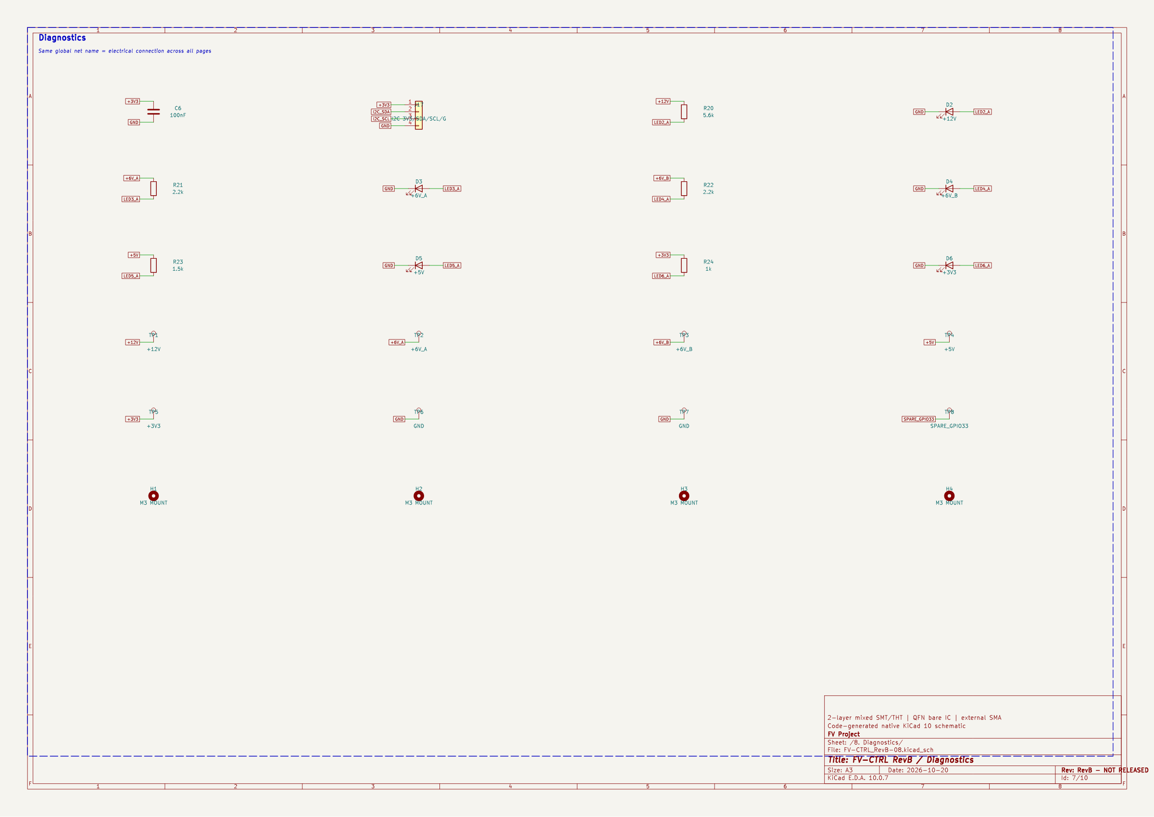
docs/revb/schematic/FV-CTRL_RevB-8. Diagnostics.png
