Masterltb/pcb/docs/revb/schematic/FV-CTRL_RevB-9. USB _ programming.png

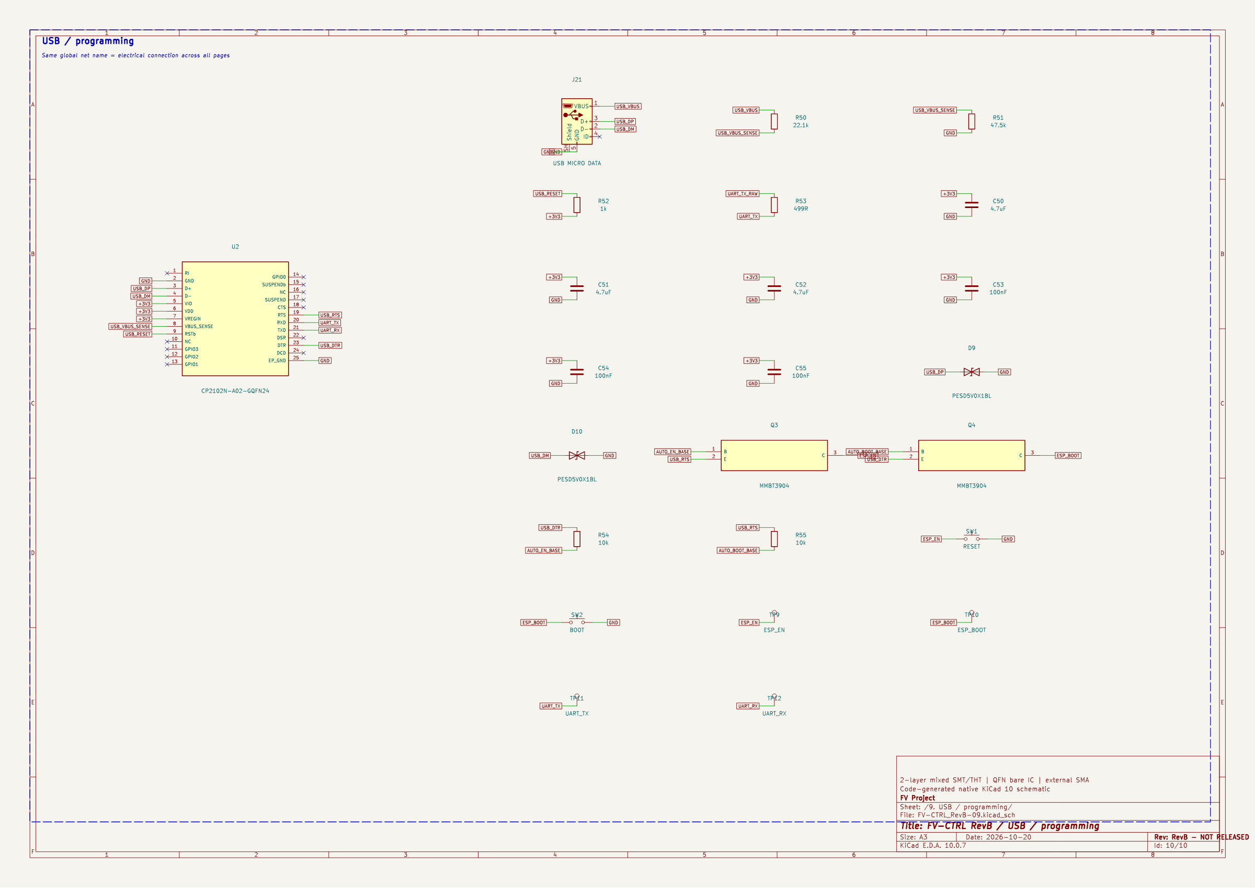
docs/revb/schematic/FV-CTRL_RevB-9. USB _ programming.png
