Masterltb/pcb/docs/revb/schematic/FV-CTRL_RevB.png

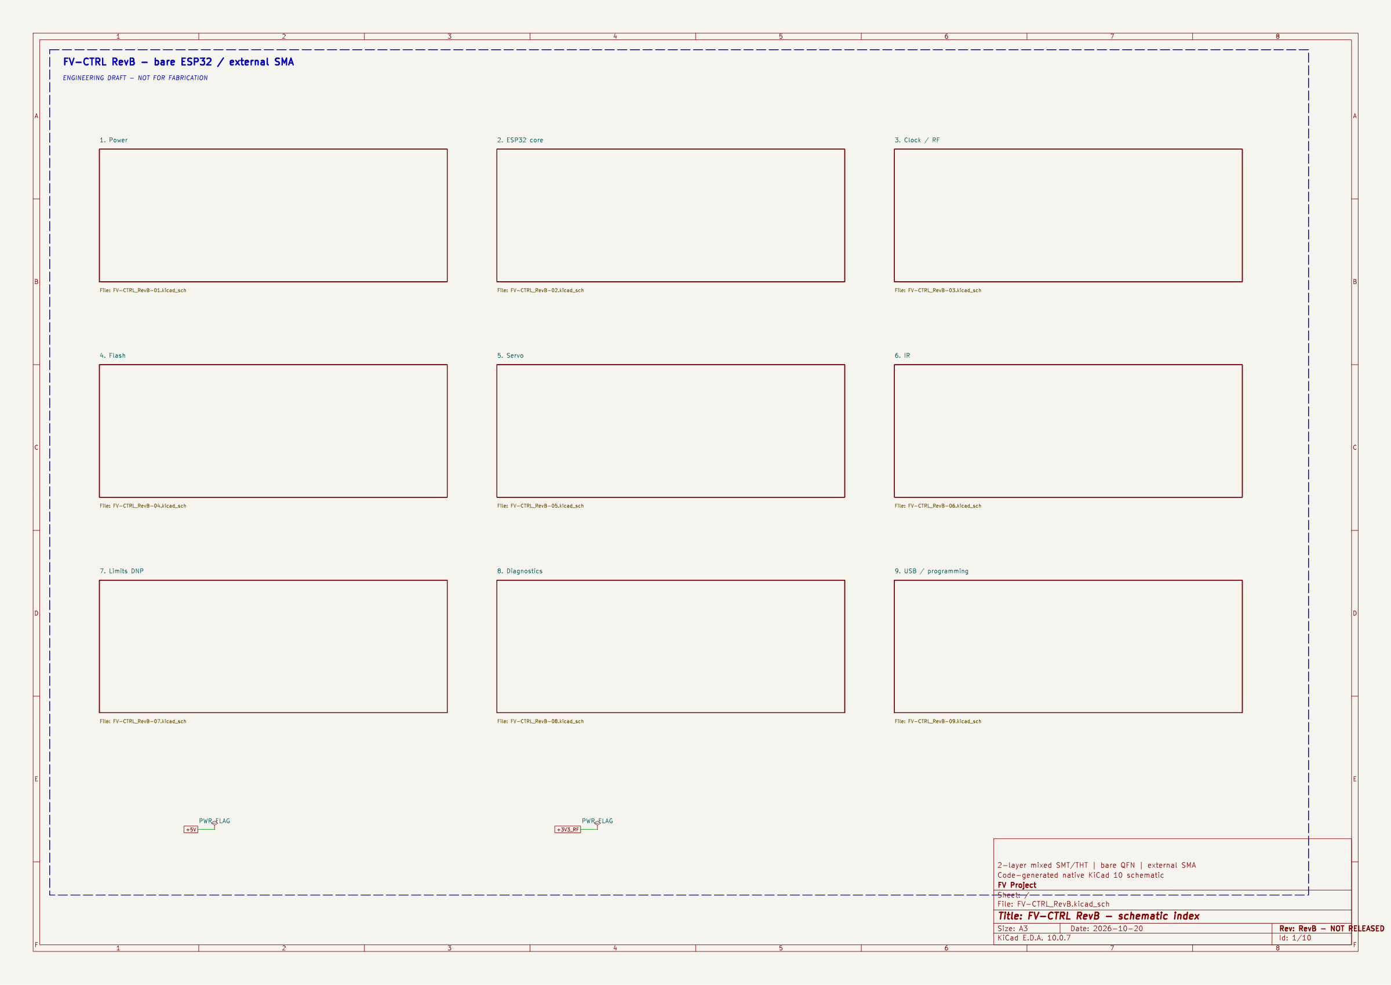
docs/revb/schematic/FV-CTRL_RevB.png
