Masterltb/pcb/docs/reva2/FV-CTRL_RevA2-bom.csv

Ref | Value | Primary MPN | Alternative / qualification | Footprint | Population | Source / purchase | Status
J1 | 12V INPUT | 1757242 + mating 1757019 | 1923869 HC variant (candidate; verify mating coding/drawing) | Connector_Phoenix_MSTB:PhoenixContact_MSTBA_2,5_2-G-5,08_1x02_P5.08mm_Horizontal | FIT | https://www.phoenixcontact.com/en-us/products/pcb-header-mstba-25-2-g-508-1757242 | Selected; incoming inspection and first article required
J2 | XL4015 A: 12/G/6/G | 1757268 + mating 1757035 | 1923885 HC variant (candidate; verify same footprint/mate) | Connector_Phoenix_MSTB:PhoenixContact_MSTBA_2,5_4-G-5,08_1x04_P5.08mm_Horizontal | FIT | https://www.phoenixcontact.com/en-us/products/pcb-header-mstba-25-4-g-508-1757268 | Selected; incoming inspection and first article required
J3 | XL4015 B: 12/G/6/G | 1757268 + mating 1757035 | 1923885 HC variant (candidate; verify same footprint/mate) | Connector_Phoenix_MSTB:PhoenixContact_MSTBA_2,5_4-G-5,08_1x04_P5.08mm_Horizontal | FIT | https://www.phoenixcontact.com/en-us/products/pcb-header-mstba-25-4-g-508-1757268 | Selected; incoming inspection and first article required
F1 | T5A - VERIFY I2T | SCHURTER 0001.2511 + 2x Littelfuse 01110001L | 0477005.MXP cartridge; compare I2t/inrush and verify holder separately | Fuse:Fuseholder_Clip-5x20mm_Littelfuse_111_Inline_P20.00x5.00mm_D1.05mm_Horizontal | FIT | https://www.schurter.com/en/part/0001.2511 | 5A time-lag DC-rated choice; coordination with PSU/harness must be tested
Q1 | IRF4905PBF | IRF4905PBF | SiHF4905-GE3 (candidate; verify G/D/S, SOA and thermal) | fv_reva2:PMOS_GDS | FIT | https://www.infineon.com/part/IRF4905 | Selected; incoming inspection and first article required
R9 | 10k | CFR-25JR-52-10K | MFR-25FBF52-10K (candidate; confirm body/lead dimensions) | Resistor_THT:R_Axial_DIN0207_L6.3mm_D2.5mm_P7.62mm_Horizontal | FIT | https://yageogroup.com/content/datasheet/asset/file/YAGEO-CFR_DATASHEET | Selected; incoming inspection and first article required
D1 | 1.5KE15CA | Littelfuse 1.5KE15CA | Vishay 1.5KE15CA-E3/54 (candidate; verify lead/package dimensions) | Diode_THT:D_DO-201AD_P15.24mm_Horizontal | FIT | https://www.littelfuse.com/~/media/electronics/datasheets/tvs_diodes/littelfuse_tvs_diode_1_5ke_datasheet.pdf.pdf | Selected; incoming inspection and first article required
D7 | BZX55C12 | BZX55C12 | BZX55C12-TR packaging variant; verify order suffix | Diode_THT:D_DO-35_SOD27_P7.62mm_Horizontal | FIT | https://www.vishay.com/docs/85604/bzx55.pdf | Selected; incoming inspection and first article required
F2 | MF-R300 | MF-R300 | RUEF300 (candidate; verify pitch, trip curve, temperature derating) | fv_reva2:MF_R300 | FIT | https://bourns.com/docs/product-datasheets/mf-r.pdf | Selected; hot-enclosure hold current and stall coordination untested
F3 | MF-R300 | MF-R300 | RUEF300 (candidate; verify pitch, trip curve, temperature derating) | fv_reva2:MF_R300 | FIT | https://bourns.com/docs/product-datasheets/mf-r.pdf | Selected; hot-enclosure hold current and stall coordination untested
C1 | 2200uF 16V | EEUFR1C222 | UPW1C222MHD (candidate; verify height, impedance and ripple) | Capacitor_THT:CP_Radial_D12.5mm_P5.00mm | FIT | https://industrial.panasonic.com/kr/products/pt/aluminum-cap-lead/models/EEUFR1C222 | Selected; incoming inspection and first article required
C3 | 100nF | K104K15X7RF53H5 | K104K10X7RF53H5 (same 100nF/50V/X7R/5mm; verify envelope) | Capacitor_THT:C_Disc_D5.0mm_W2.5mm_P5.00mm | FIT | https://www.vishay.com/doc/?45171= | Selected; incoming inspection and first article required
C2 | 2200uF 16V | EEUFR1C222 | UPW1C222MHD (candidate; verify height, impedance and ripple) | Capacitor_THT:CP_Radial_D12.5mm_P5.00mm | FIT | https://industrial.panasonic.com/kr/products/pt/aluminum-cap-lead/models/EEUFR1C222 | Selected; incoming inspection and first article required
C4 | 100nF | K104K15X7RF53H5 | K104K10X7RF53H5 (same 100nF/50V/X7R/5mm; verify envelope) | Capacitor_THT:C_Disc_D5.0mm_W2.5mm_P5.00mm | FIT | https://www.vishay.com/doc/?45171= | Selected; incoming inspection and first article required
J4 | 5V D24V25F5 | Pololu 2850 D24V25F5 + 1x05 female socket | D24V50F5 (electrically pin-compatible; larger body requires layout review) | fv_reva2:Pololu_D24V25F5 | FIT | https://www.pololu.com/product/2850 | Selected; incoming inspection and first article required
JP1 | REMOVE BEFORE USB | M20-9990246 + M7567-05 shunt | TSW-102-07-G-S (candidate; verify lead length/body/current) | Connector_PinHeader_2.54mm:PinHeader_1x02_P2.54mm_Vertical | FIT | https://www.harwin.com/products/M20-9990346 | Selected; incoming inspection and first article required
J18 | DEVKITC V4 LEFT | SSQ-119-03-G-S | SSQ-119-03-T-S (same geometry, tin plating) | Connector_PinSocket_2.54mm:PinSocket_1x19_P2.54mm_Vertical | FIT | https://www.samtec.com/products/ssq-119-03-g-s | Selected; incoming inspection and first article required
J19 | DEVKITC V4 RIGHT | SSQ-119-03-G-S | SSQ-119-03-T-S (same geometry, tin plating) | Connector_PinSocket_2.54mm:PinSocket_1x19_P2.54mm_Vertical | FIT | https://www.samtec.com/products/ssq-119-03-g-s | Selected; incoming inspection and first article required
C5 | 10uF 50V | EEUFR1H100 | 50YXJ10M5X11 (candidate; confirm availability/dimensions) | Capacitor_THT:CP_Radial_D5.0mm_P2.00mm | FIT | https://industrial.panasonic.com/kr/products/pt/aluminum-cap-lead/models/EEUFR1H100 | Selected; incoming inspection and first article required
C6 | 100nF | K104K15X7RF53H5 | K104K10X7RF53H5 (same 100nF/50V/X7R/5mm; verify envelope) | Capacitor_THT:C_Disc_D5.0mm_W2.5mm_P5.00mm | FIT | https://www.vishay.com/doc/?45171= | Selected; incoming inspection and first article required
J5 | S1_TOP | M20-9990346 | TSW-103-07-G-S (candidate; verify lead length/body/current) | Connector_PinHeader_2.54mm:PinHeader_1x03_P2.54mm_Vertical | FIT | https://www.harwin.com/products/M20-9990346 | Selected; incoming inspection and first article required
R1 | 330R | CFR-25JR-52-330R | MFR-25FBF52-330R (candidate; confirm body/lead dimensions) | Resistor_THT:R_Axial_DIN0207_L6.3mm_D2.5mm_P7.62mm_Horizontal | FIT | https://yageogroup.com/content/datasheet/asset/file/YAGEO-CFR_DATASHEET | Selected; incoming inspection and first article required
R5 | 10k | CFR-25JR-52-10K | MFR-25FBF52-10K (candidate; confirm body/lead dimensions) | Resistor_THT:R_Axial_DIN0207_L6.3mm_D2.5mm_P7.62mm_Horizontal | FIT | https://yageogroup.com/content/datasheet/asset/file/YAGEO-CFR_DATASHEET | Selected; incoming inspection and first article required
J6 | S1_BOT | M20-9990346 | TSW-103-07-G-S (candidate; verify lead length/body/current) | Connector_PinHeader_2.54mm:PinHeader_1x03_P2.54mm_Vertical | FIT | https://www.harwin.com/products/M20-9990346 | Selected; incoming inspection and first article required
R2 | 330R | CFR-25JR-52-330R | MFR-25FBF52-330R (candidate; confirm body/lead dimensions) | Resistor_THT:R_Axial_DIN0207_L6.3mm_D2.5mm_P7.62mm_Horizontal | FIT | https://yageogroup.com/content/datasheet/asset/file/YAGEO-CFR_DATASHEET | Selected; incoming inspection and first article required
R6 | 10k | CFR-25JR-52-10K | MFR-25FBF52-10K (candidate; confirm body/lead dimensions) | Resistor_THT:R_Axial_DIN0207_L6.3mm_D2.5mm_P7.62mm_Horizontal | FIT | https://yageogroup.com/content/datasheet/asset/file/YAGEO-CFR_DATASHEET | Selected; incoming inspection and first article required
J7 | S2_TOP | M20-9990346 | TSW-103-07-G-S (candidate; verify lead length/body/current) | Connector_PinHeader_2.54mm:PinHeader_1x03_P2.54mm_Vertical | FIT | https://www.harwin.com/products/M20-9990346 | Selected; incoming inspection and first article required
R3 | 330R | CFR-25JR-52-330R | MFR-25FBF52-330R (candidate; confirm body/lead dimensions) | Resistor_THT:R_Axial_DIN0207_L6.3mm_D2.5mm_P7.62mm_Horizontal | FIT | https://yageogroup.com/content/datasheet/asset/file/YAGEO-CFR_DATASHEET | Selected; incoming inspection and first article required
R7 | 10k | CFR-25JR-52-10K | MFR-25FBF52-10K (candidate; confirm body/lead dimensions) | Resistor_THT:R_Axial_DIN0207_L6.3mm_D2.5mm_P7.62mm_Horizontal | FIT | https://yageogroup.com/content/datasheet/asset/file/YAGEO-CFR_DATASHEET | Selected; incoming inspection and first article required
J8 | S2_BOT | M20-9990346 | TSW-103-07-G-S (candidate; verify lead length/body/current) | Connector_PinHeader_2.54mm:PinHeader_1x03_P2.54mm_Vertical | FIT | https://www.harwin.com/products/M20-9990346 | Selected; incoming inspection and first article required
R4 | 330R | CFR-25JR-52-330R | MFR-25FBF52-330R (candidate; confirm body/lead dimensions) | Resistor_THT:R_Axial_DIN0207_L6.3mm_D2.5mm_P7.62mm_Horizontal | FIT | https://yageogroup.com/content/datasheet/asset/file/YAGEO-CFR_DATASHEET | Selected; incoming inspection and first article required
R8 | 10k | CFR-25JR-52-10K | MFR-25FBF52-10K (candidate; confirm body/lead dimensions) | Resistor_THT:R_Axial_DIN0207_L6.3mm_D2.5mm_P7.62mm_Horizontal | FIT | https://yageogroup.com/content/datasheet/asset/file/YAGEO-CFR_DATASHEET | Selected; incoming inspection and first article required
J9 | IR RX1 3V3/OUT/G | B3B-XH-A + XHP-3 + SXH-001T-P0.6 | B3B-XH-A(LF)(SN) ordering variant; check exact housing/terminal | Connector_JST:JST_XH_B3B-XH-A_1x03_P2.50mm_Vertical | FIT | https://www.jst-mfg.com/product/pdf/eng/eXH.pdf | Selected; incoming inspection and first article required
R26 | 10k | CFR-25JR-52-10K | MFR-25FBF52-10K (candidate; confirm body/lead dimensions) | Resistor_THT:R_Axial_DIN0207_L6.3mm_D2.5mm_P7.62mm_Horizontal | FIT | https://yageogroup.com/content/datasheet/asset/file/YAGEO-CFR_DATASHEET | Selected; incoming inspection and first article required
R28 | 1k | CFR-25JR-52-1K | MFR-25FBF52-1K (candidate; confirm body/lead dimensions) | Resistor_THT:R_Axial_DIN0207_L6.3mm_D2.5mm_P7.62mm_Horizontal | FIT | https://yageogroup.com/content/datasheet/asset/file/YAGEO-CFR_DATASHEET | Selected; incoming inspection and first article required
J10 | IR RX2 3V3/OUT/G | B3B-XH-A + XHP-3 + SXH-001T-P0.6 | B3B-XH-A(LF)(SN) ordering variant; check exact housing/terminal | Connector_JST:JST_XH_B3B-XH-A_1x03_P2.50mm_Vertical | FIT | https://www.jst-mfg.com/product/pdf/eng/eXH.pdf | Selected; incoming inspection and first article required
R27 | 10k | CFR-25JR-52-10K | MFR-25FBF52-10K (candidate; confirm body/lead dimensions) | Resistor_THT:R_Axial_DIN0207_L6.3mm_D2.5mm_P7.62mm_Horizontal | FIT | https://yageogroup.com/content/datasheet/asset/file/YAGEO-CFR_DATASHEET | Selected; incoming inspection and first article required
R29 | 1k | CFR-25JR-52-1K | MFR-25FBF52-1K (candidate; confirm body/lead dimensions) | Resistor_THT:R_Axial_DIN0207_L6.3mm_D2.5mm_P7.62mm_Horizontal | FIT | https://yageogroup.com/content/datasheet/asset/file/YAGEO-CFR_DATASHEET | Selected; incoming inspection and first article required
J11 | IR TX1 A/K | B2B-XH-A + XHP-2 + SXH-001T-P0.6 | B2B-XH-A(LF)(SN) ordering variant; check exact housing/terminal | Connector_JST:JST_XH_B2B-XH-A_1x02_P2.50mm_Vertical | FIT | https://www.jst-mfg.com/product/pdf/eng/eXH.pdf | Selected; incoming inspection and first article required
R14 | 120R | CFR-25JR-52-120R | MFR-25FBF52-120R (candidate; confirm body/lead dimensions) | Resistor_THT:R_Axial_DIN0207_L6.3mm_D2.5mm_P7.62mm_Horizontal | FIT | https://yageogroup.com/content/datasheet/asset/file/YAGEO-CFR_DATASHEET | Selected; incoming inspection and first article required
J12 | IR TX2 A/K | B2B-XH-A + XHP-2 + SXH-001T-P0.6 | B2B-XH-A(LF)(SN) ordering variant; check exact housing/terminal | Connector_JST:JST_XH_B2B-XH-A_1x02_P2.50mm_Vertical | FIT | https://www.jst-mfg.com/product/pdf/eng/eXH.pdf | Selected; incoming inspection and first article required
R15 | 120R | CFR-25JR-52-120R | MFR-25FBF52-120R (candidate; confirm body/lead dimensions) | Resistor_THT:R_Axial_DIN0207_L6.3mm_D2.5mm_P7.62mm_Horizontal | FIT | https://yageogroup.com/content/datasheet/asset/file/YAGEO-CFR_DATASHEET | Selected; incoming inspection and first article required
R13 | 330R | CFR-25JR-52-330R | MFR-25FBF52-330R (candidate; confirm body/lead dimensions) | Resistor_THT:R_Axial_DIN0207_L6.3mm_D2.5mm_P7.62mm_Horizontal | FIT | https://yageogroup.com/content/datasheet/asset/file/YAGEO-CFR_DATASHEET | Selected; incoming inspection and first article required
R25 | 10k | CFR-25JR-52-10K | MFR-25FBF52-10K (candidate; confirm body/lead dimensions) | Resistor_THT:R_Axial_DIN0207_L6.3mm_D2.5mm_P7.62mm_Horizontal | FIT | https://yageogroup.com/content/datasheet/asset/file/YAGEO-CFR_DATASHEET | Selected; incoming inspection and first article required
Q2 | P2N2222AG | P2N2222AG | P2N2222ARL1G (same device, formed/taped leads; check lead forming) | fv_reva2:NPN_CBE | FIT | https://www.onsemi.com/pdf/datasheet/p2n2222a-d.pdf | Selected; incoming inspection and first article required
J13 | LS1 DNP | B2B-XH-A + XHP-2 + SXH-001T-P0.6 | B2B-XH-A(LF)(SN) ordering variant; check exact housing/terminal | Connector_JST:JST_XH_B2B-XH-A_1x02_P2.50mm_Vertical | DNP | https://www.jst-mfg.com/product/pdf/eng/eXH.pdf | Selected; incoming inspection and first article required
R16 | 10k | CFR-25JR-52-10K | MFR-25FBF52-10K (candidate; confirm body/lead dimensions) | Resistor_THT:R_Axial_DIN0207_L6.3mm_D2.5mm_P7.62mm_Horizontal | DNP | https://yageogroup.com/content/datasheet/asset/file/YAGEO-CFR_DATASHEET | Selected; incoming inspection and first article required
C7 | 100nF | K104K15X7RF53H5 | K104K10X7RF53H5 (same 100nF/50V/X7R/5mm; verify envelope) | Capacitor_THT:C_Disc_D5.0mm_W2.5mm_P5.00mm | DNP | https://www.vishay.com/doc/?45171= | Selected; incoming inspection and first article required
J14 | LS2 DNP | B2B-XH-A + XHP-2 + SXH-001T-P0.6 | B2B-XH-A(LF)(SN) ordering variant; check exact housing/terminal | Connector_JST:JST_XH_B2B-XH-A_1x02_P2.50mm_Vertical | DNP | https://www.jst-mfg.com/product/pdf/eng/eXH.pdf | Selected; incoming inspection and first article required
R17 | 10k | CFR-25JR-52-10K | MFR-25FBF52-10K (candidate; confirm body/lead dimensions) | Resistor_THT:R_Axial_DIN0207_L6.3mm_D2.5mm_P7.62mm_Horizontal | DNP | https://yageogroup.com/content/datasheet/asset/file/YAGEO-CFR_DATASHEET | Selected; incoming inspection and first article required
C8 | 100nF | K104K15X7RF53H5 | K104K10X7RF53H5 (same 100nF/50V/X7R/5mm; verify envelope) | Capacitor_THT:C_Disc_D5.0mm_W2.5mm_P5.00mm | DNP | https://www.vishay.com/doc/?45171= | Selected; incoming inspection and first article required
J15 | LS3 DNP | B2B-XH-A + XHP-2 + SXH-001T-P0.6 | B2B-XH-A(LF)(SN) ordering variant; check exact housing/terminal | Connector_JST:JST_XH_B2B-XH-A_1x02_P2.50mm_Vertical | DNP | https://www.jst-mfg.com/product/pdf/eng/eXH.pdf | Selected; incoming inspection and first article required
R18 | 10k | CFR-25JR-52-10K | MFR-25FBF52-10K (candidate; confirm body/lead dimensions) | Resistor_THT:R_Axial_DIN0207_L6.3mm_D2.5mm_P7.62mm_Horizontal | DNP | https://yageogroup.com/content/datasheet/asset/file/YAGEO-CFR_DATASHEET | Selected; incoming inspection and first article required
C9 | 100nF | K104K15X7RF53H5 | K104K10X7RF53H5 (same 100nF/50V/X7R/5mm; verify envelope) | Capacitor_THT:C_Disc_D5.0mm_W2.5mm_P5.00mm | DNP | https://www.vishay.com/doc/?45171= | Selected; incoming inspection and first article required
J16 | LS4 DNP | B2B-XH-A + XHP-2 + SXH-001T-P0.6 | B2B-XH-A(LF)(SN) ordering variant; check exact housing/terminal | Connector_JST:JST_XH_B2B-XH-A_1x02_P2.50mm_Vertical | DNP | https://www.jst-mfg.com/product/pdf/eng/eXH.pdf | Selected; incoming inspection and first article required
R19 | 10k | CFR-25JR-52-10K | MFR-25FBF52-10K (candidate; confirm body/lead dimensions) | Resistor_THT:R_Axial_DIN0207_L6.3mm_D2.5mm_P7.62mm_Horizontal | DNP | https://yageogroup.com/content/datasheet/asset/file/YAGEO-CFR_DATASHEET | Selected; incoming inspection and first article required
C10 | 100nF | K104K15X7RF53H5 | K104K10X7RF53H5 (same 100nF/50V/X7R/5mm; verify envelope) | Capacitor_THT:C_Disc_D5.0mm_W2.5mm_P5.00mm | DNP | https://www.vishay.com/doc/?45171= | Selected; incoming inspection and first article required
J17 | I2C 3V3/SDA/SCL/G | M20-9990446 | TSW-104-07-G-S (candidate; verify lead length/body/current) | Connector_PinHeader_2.54mm:PinHeader_1x04_P2.54mm_Vertical | FIT | https://www.harwin.com/products/M20-9990346 | Selected; incoming inspection and first article required
R20 | 5.6k | CFR-25JR-52-5K6 | MFR-25FBF52-5K6 (candidate; confirm body/lead dimensions) | Resistor_THT:R_Axial_DIN0207_L6.3mm_D2.5mm_P7.62mm_Horizontal | FIT | https://yageogroup.com/content/datasheet/asset/file/YAGEO-CFR_DATASHEET | Selected; incoming inspection and first article required
D2 | +12V | WP710A10GD | WP710A10GT (clear lens variant; verify visibility) | LED_THT:LED_D3.0mm | FIT | https://www.kingbrightusa.com/images/catalog/spec/wp710a10gd.pdf | Selected; incoming inspection and first article required
R21 | 2.2k | CFR-25JR-52-2K2 | MFR-25FBF52-2K2 (candidate; confirm body/lead dimensions) | Resistor_THT:R_Axial_DIN0207_L6.3mm_D2.5mm_P7.62mm_Horizontal | FIT | https://yageogroup.com/content/datasheet/asset/file/YAGEO-CFR_DATASHEET | Selected; incoming inspection and first article required
D3 | +6V_A | WP710A10GD | WP710A10GT (clear lens variant; verify visibility) | LED_THT:LED_D3.0mm | FIT | https://www.kingbrightusa.com/images/catalog/spec/wp710a10gd.pdf | Selected; incoming inspection and first article required
R22 | 2.2k | CFR-25JR-52-2K2 | MFR-25FBF52-2K2 (candidate; confirm body/lead dimensions) | Resistor_THT:R_Axial_DIN0207_L6.3mm_D2.5mm_P7.62mm_Horizontal | FIT | https://yageogroup.com/content/datasheet/asset/file/YAGEO-CFR_DATASHEET | Selected; incoming inspection and first article required
D4 | +6V_B | WP710A10GD | WP710A10GT (clear lens variant; verify visibility) | LED_THT:LED_D3.0mm | FIT | https://www.kingbrightusa.com/images/catalog/spec/wp710a10gd.pdf | Selected; incoming inspection and first article required
R23 | 1.5k | CFR-25JR-52-1K5 | MFR-25FBF52-1K5 (candidate; confirm body/lead dimensions) | Resistor_THT:R_Axial_DIN0207_L6.3mm_D2.5mm_P7.62mm_Horizontal | FIT | https://yageogroup.com/content/datasheet/asset/file/YAGEO-CFR_DATASHEET | Selected; incoming inspection and first article required
D5 | +5V | WP710A10GD | WP710A10GT (clear lens variant; verify visibility) | LED_THT:LED_D3.0mm | FIT | https://www.kingbrightusa.com/images/catalog/spec/wp710a10gd.pdf | Selected; incoming inspection and first article required
R24 | 1k | CFR-25JR-52-1K | MFR-25FBF52-1K (candidate; confirm body/lead dimensions) | Resistor_THT:R_Axial_DIN0207_L6.3mm_D2.5mm_P7.62mm_Horizontal | FIT | https://yageogroup.com/content/datasheet/asset/file/YAGEO-CFR_DATASHEET | Selected; incoming inspection and first article required
D6 | +3V3 | WP710A10GD | WP710A10GT (clear lens variant; verify visibility) | LED_THT:LED_D3.0mm | FIT | https://www.kingbrightusa.com/images/catalog/spec/wp710a10gd.pdf | Selected; incoming inspection and first article required
TP1 | +12V | 5000 | 5260 | fv_reva2:Keystone_5000_Carrier_D3 | FIT | https://www.keyelco.com/category.cfm/Test-Points-color-keyed-Thru-Hole-Mount/Miniature-Style/id/747 | Selected; incoming inspection and first article required
TP2 | +6V_A | 5000 | 5260 | fv_reva2:Keystone_5000_Carrier_D3 | FIT | https://www.keyelco.com/category.cfm/Test-Points-color-keyed-Thru-Hole-Mount/Miniature-Style/id/747 | Selected; incoming inspection and first article required
TP3 | +6V_B | 5000 | 5260 | fv_reva2:Keystone_5000_Carrier_D3 | FIT | https://www.keyelco.com/category.cfm/Test-Points-color-keyed-Thru-Hole-Mount/Miniature-Style/id/747 | Selected; incoming inspection and first article required
TP4 | +5V | 5000 | 5260 | fv_reva2:Keystone_5000_Carrier_D3 | FIT | https://www.keyelco.com/category.cfm/Test-Points-color-keyed-Thru-Hole-Mount/Miniature-Style/id/747 | Selected; incoming inspection and first article required
TP5 | +3V3 | 5000 | 5260 | fv_reva2:Keystone_5000_Carrier_D3 | FIT | https://www.keyelco.com/category.cfm/Test-Points-color-keyed-Thru-Hole-Mount/Miniature-Style/id/747 | Selected; incoming inspection and first article required
TP6 | GND | 5001 | 5261 | fv_reva2:Keystone_5000_Carrier_D3 | FIT | https://www.keyelco.com/category.cfm/Test-Points-color-keyed-Thru-Hole-Mount/Miniature-Style/id/747 | Selected; incoming inspection and first article required
TP7 | GND | 5001 | 5261 | fv_reva2:Keystone_5000_Carrier_D3 | FIT | https://www.keyelco.com/category.cfm/Test-Points-color-keyed-Thru-Hole-Mount/Miniature-Style/id/747 | Selected; incoming inspection and first article required
TP8 | SPARE_GPIO33 | 5000 | 5260 | fv_reva2:Keystone_5000_Carrier_D3 | FIT | https://www.keyelco.com/category.cfm/Test-Points-color-keyed-Thru-Hole-Mount/Miniature-Style/id/747 | Selected; incoming inspection and first article required
H1 | M3 MOUNT | M3 nylon spacer/screw set, enclosure dependent | M3 metal hardware with insulating washers, verify copper keepout | MountingHole:MountingHole_3.2mm_M3 | FIT | PROJECT.md section 12 | Mechanical procurement pending enclosure
H2 | M3 MOUNT | M3 nylon spacer/screw set, enclosure dependent | M3 metal hardware with insulating washers, verify copper keepout | MountingHole:MountingHole_3.2mm_M3 | FIT | PROJECT.md section 12 | Mechanical procurement pending enclosure
H3 | M3 MOUNT | M3 nylon spacer/screw set, enclosure dependent | M3 metal hardware with insulating washers, verify copper keepout | MountingHole:MountingHole_3.2mm_M3 | FIT | PROJECT.md section 12 | Mechanical procurement pending enclosure
H4 | M3 MOUNT | M3 nylon spacer/screw set, enclosure dependent | M3 metal hardware with insulating washers, verify copper keepout | MountingHole:MountingHole_3.2mm_M3 | FIT | PROJECT.md section 12 | Mechanical procurement pending enclosure
