Masterltb/pcb/cad/FreshVend_Machine_Assembly.step

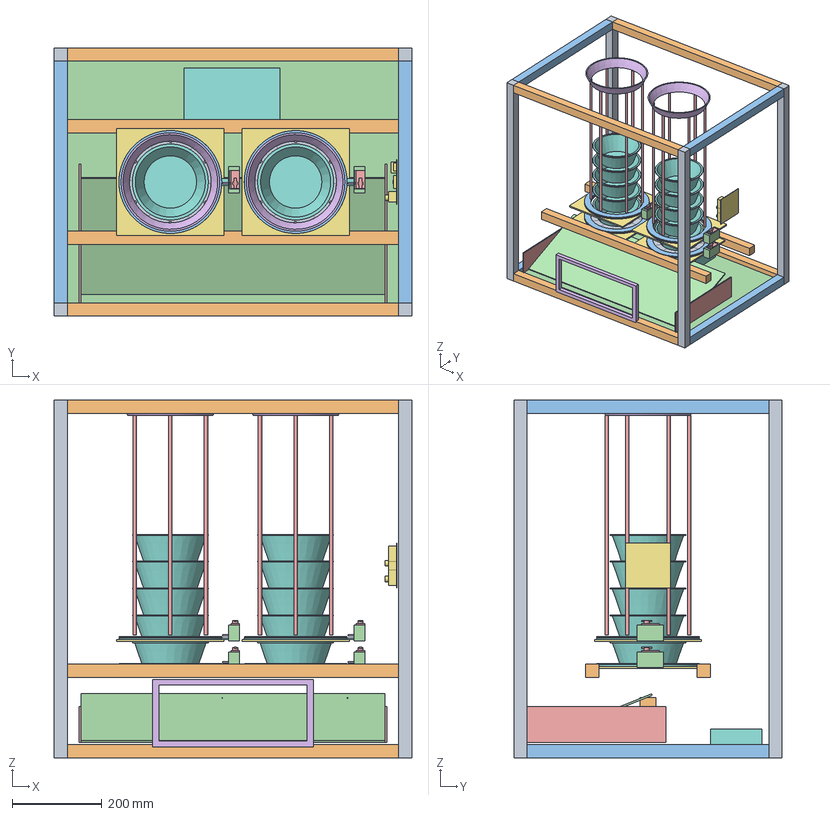
[picture p11: CAD file, 2026-10-18]
cad/FreshVend_Machine_Assembly.step
800.0 x 600.0 x 800.0 mm
