Masterltb/pcb/cad/stl/Top_Restock_Funnel.stl

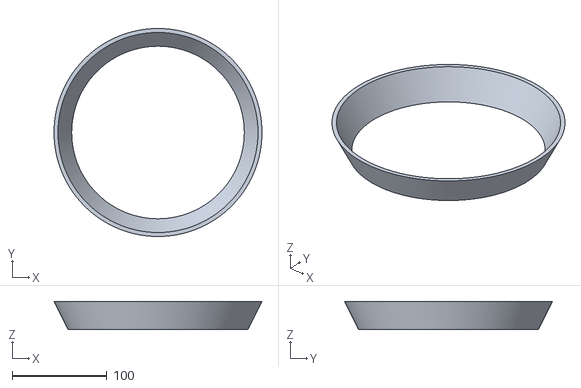
[picture p12: CAD file, 2026-10-18]
cad/stl/Top_Restock_Funnel.stl
220.0 x 220.0 x 30.0
