Masterltb/pcb/docs/FV-CTRL_RevA_3D.step

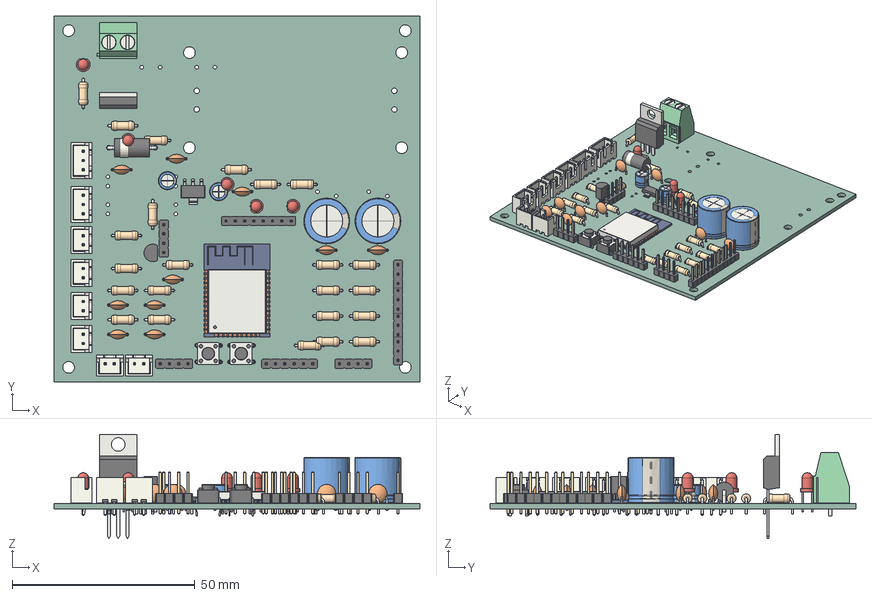
[picture p13: CAD file, 2026-10-18]
docs/FV-CTRL_RevA_3D.step
100.0 x 100.0 x 28.5 mm
PinHeader_1x04_P254mm_Vertical x 3
R_Axial_DIN0207_L63mm_D25mm_P762mm_Horizontal x 23
LED_D3.0mm x 5
CP_Radial_D50mm_P200mm x 2
SW_PUSH_6mm_h5mm x 2
JST_B3B_XH_A x 2
C_Disc_D50mm_W25mm_P500mm x 10
JST_B2B_XH_A x 6
ESP32-WROOM-32
PinHeader_1x03_P254mm_Vertical x 4
CP_Radial_D125mm_P500mm x 2
TerminalBlock_Phoenix_MKDS-1,5-2-5.08_1x02_P5.08mm_Horizontal
PinHeader_1x06_P254mm_Vertical
D_DO-201_P12.70mm_Horizontal
PinHeader_1x08_P254mm_Vertical
SOT-223
TO-92_Inline_Narrow
TO-220-3_Vertical
FV-CTRL_RevA_PCB
