Masterltb/pcb/cad/stl/Iris_Stator_Base.stl

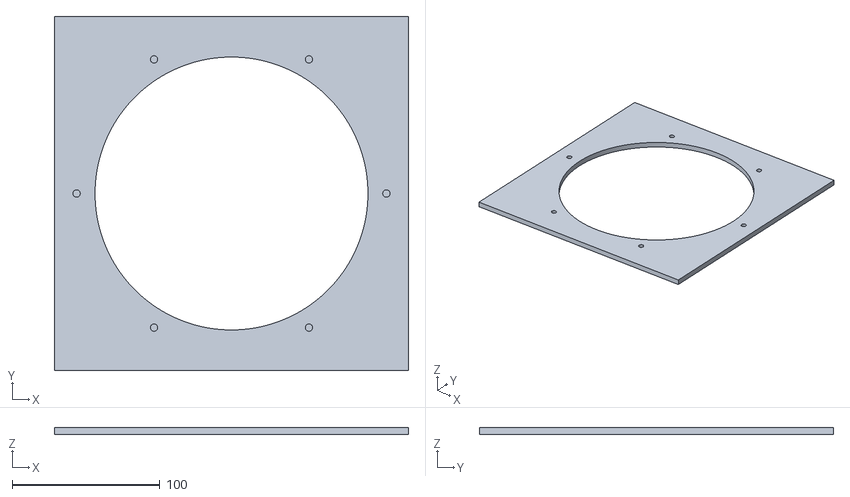
[picture p14: CAD file, 2026-10-18]
cad/stl/Iris_Stator_Base.stl
240.0 x 240.0 x 5.00
