Masterltb/pcb/docs/FV-IR-RX_RevA_3D.step

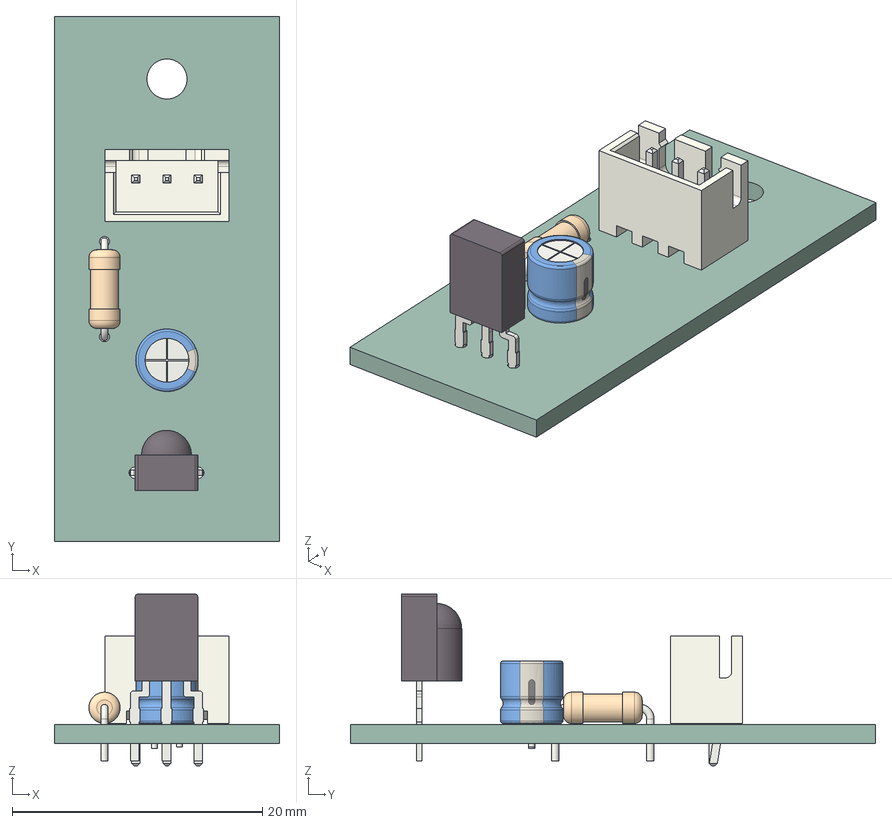
[picture p15: CAD file, 2026-10-18]
docs/FV-IR-RX_RevA_3D.step
18.0 x 42.0 x 13.8 mm
CP_Radial_D50mm_P200mm
R_Axial_DIN0207_L63mm_D25mm_P762mm_Horizontal
Vishay_MINICAST-3pin
JST_B3B_XH_A
FV-IR-RX_RevA_PCB
