Masterltb/pcb/cad/stl/Iris_Blades_x6_Closed.stl

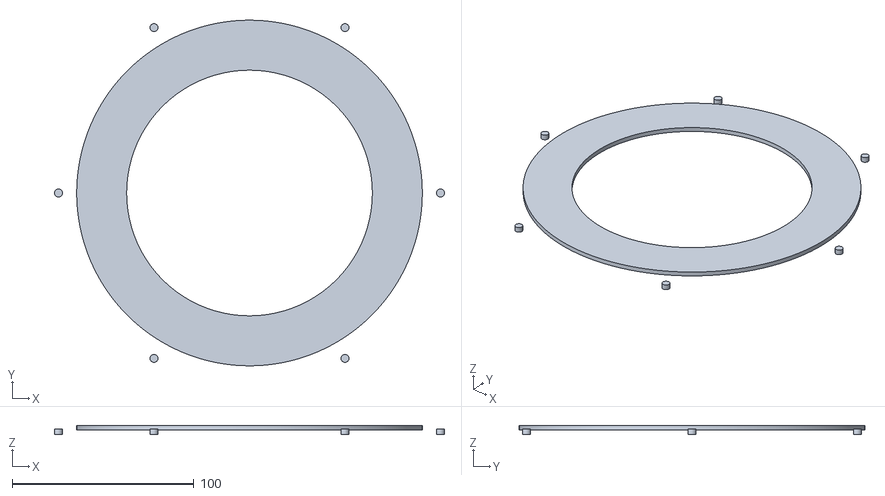
[picture p16: CAD file, 2026-10-18]
cad/stl/Iris_Blades_x6_Closed.stl
214.4 x 190.0 x 5.00
