Masterltb/pcb/cad/stl/Servo_MG996R_Bracket.stl

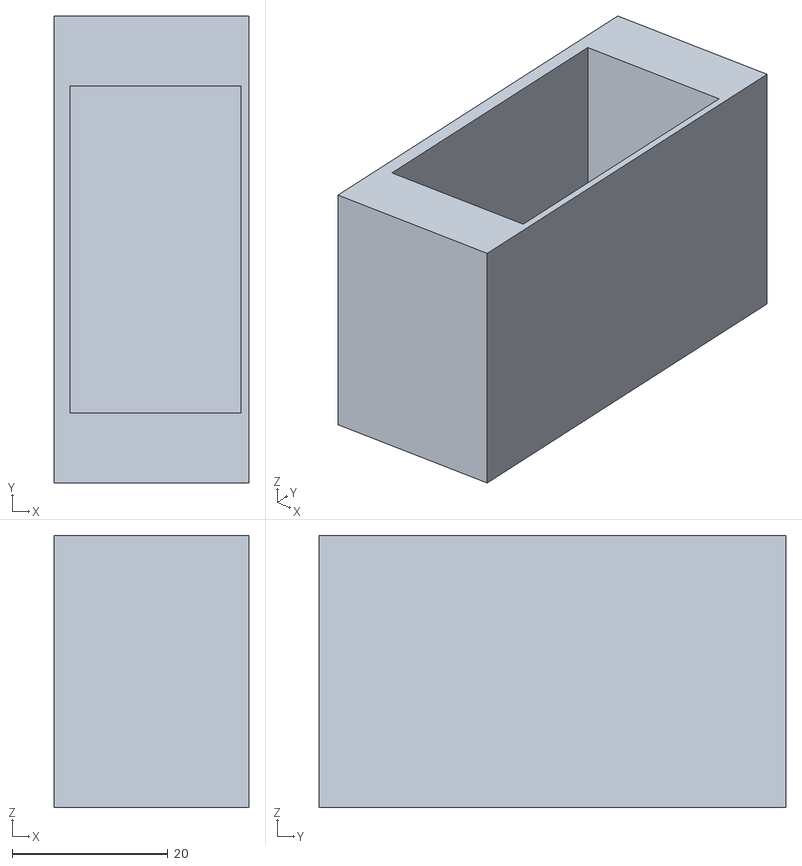
[picture p17: CAD file, 2026-10-18]
cad/stl/Servo_MG996R_Bracket.stl
25.0 x 60.0 x 35.0
