Masterltb/pcb/cad/stl/Iris_Retaining_Cover.stl

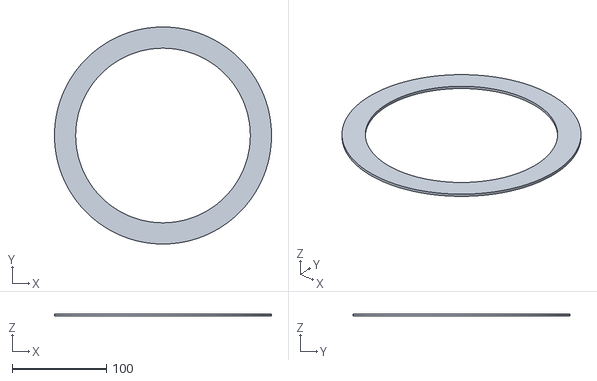
[picture p18: CAD file, 2026-10-18]
cad/stl/Iris_Retaining_Cover.stl
230.0 x 230.0 x 2.50
