Masterltb/pcb/cad/stl/Iris_Drive_Rotor_Ring.stl

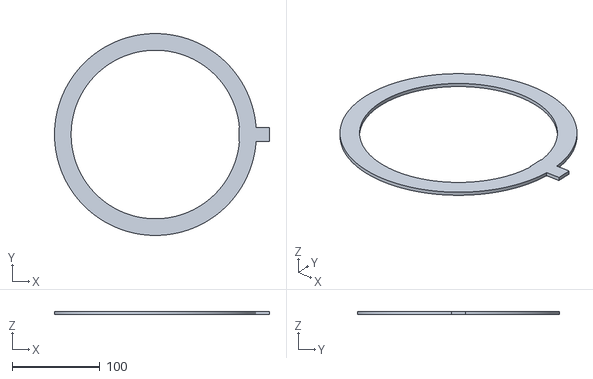
[picture p19: CAD file, 2026-10-18]
cad/stl/Iris_Drive_Rotor_Ring.stl
245.0 x 230.0 x 3.50
