Masterltb/pcb/cad/stl/Fruit_Bowl_170mm.stl

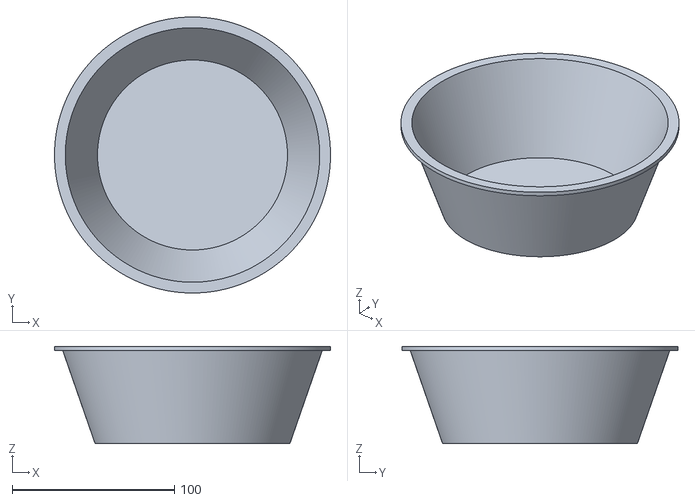
[picture p20: CAD file, 2026-10-18]
cad/stl/Fruit_Bowl_170mm.stl
170.0 x 170.0 x 60.0
