Masterltb/pcb/(list of files, cad)

Other CAD files:
cad/FreshVend_Machine_3D.FCStd
