Masterltb/pcb/docs/revb/assembly/RevB-back-assembly.png

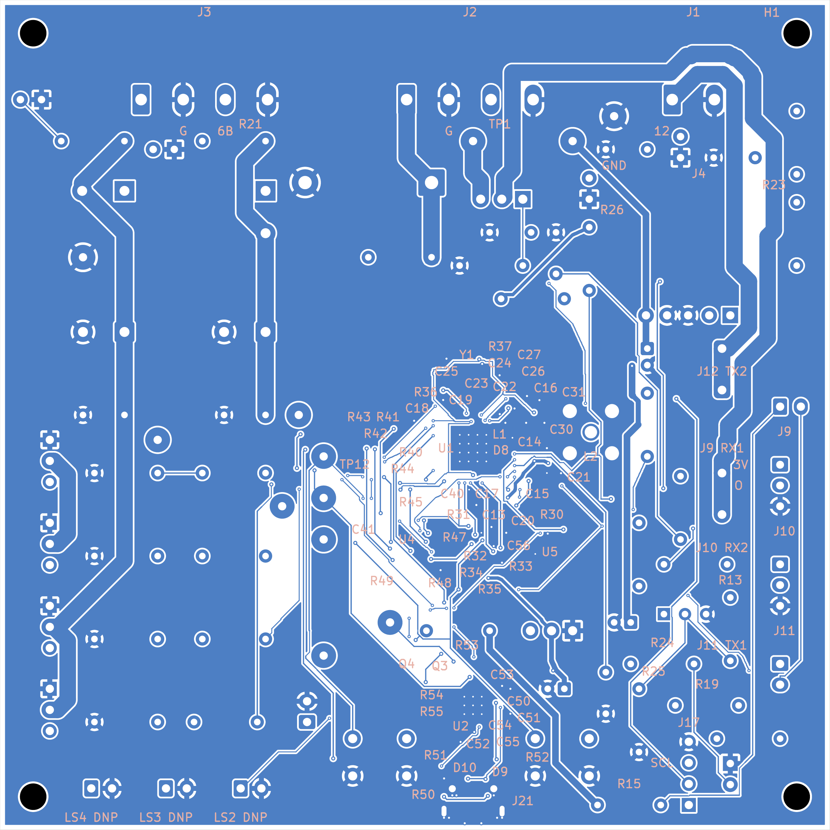
docs/revb/assembly/RevB-back-assembly.png
