Masterltb/pcb/docs/revb/assembly/RevB-bottom.png

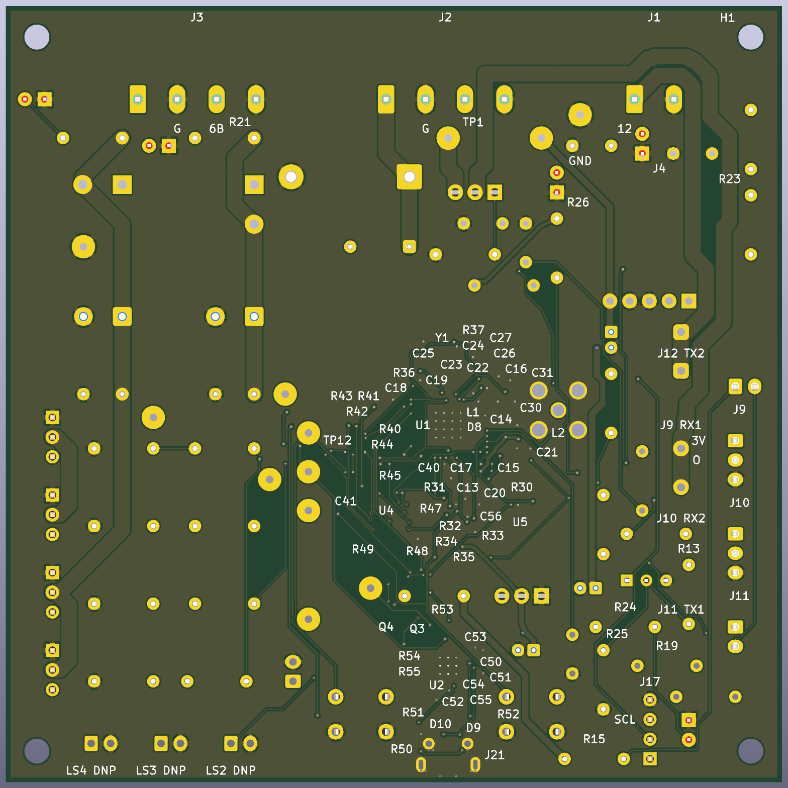
docs/revb/assembly/RevB-bottom.png
