Masterltb/pcb/docs/revb/assembly/RevB-front-assembly.png

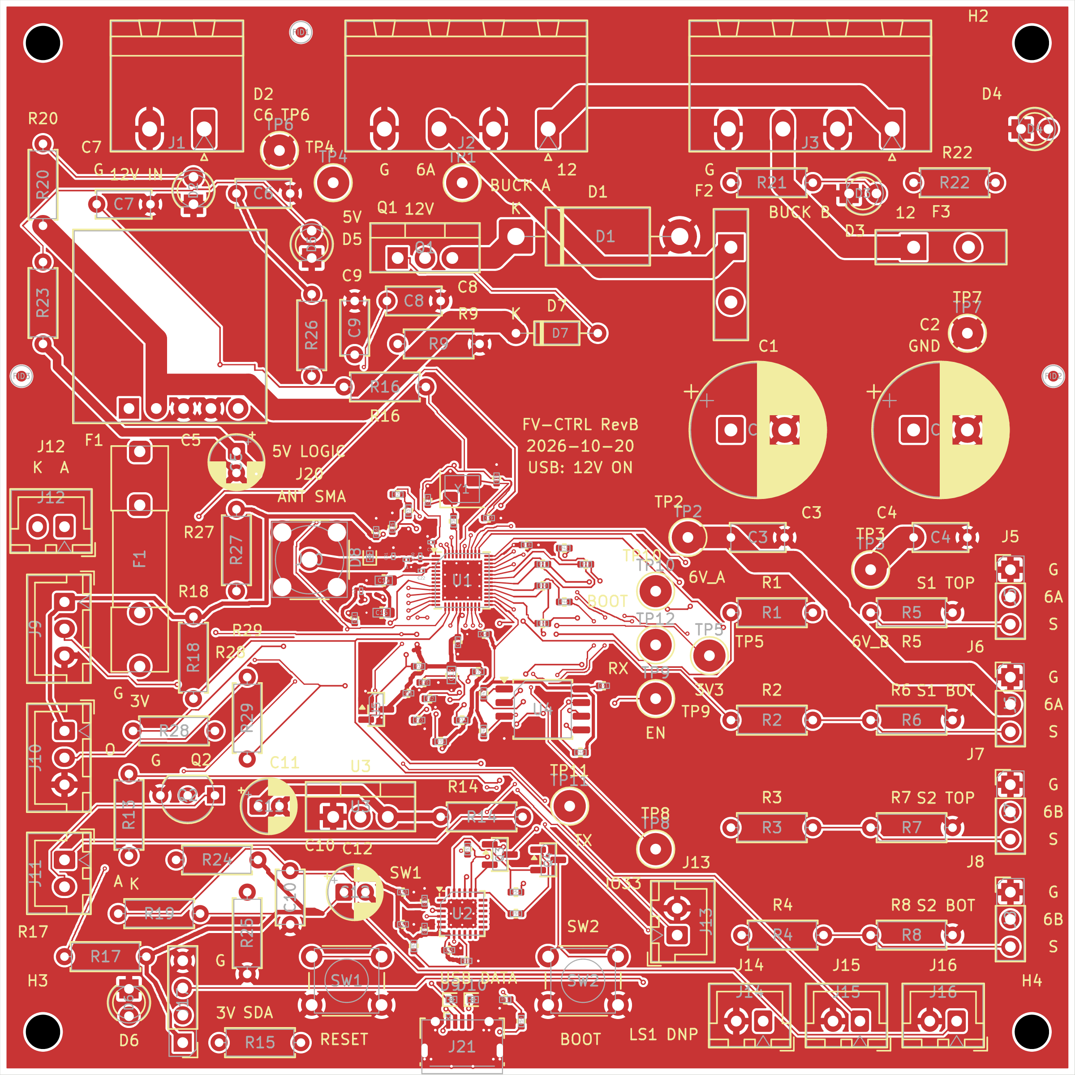
docs/revb/assembly/RevB-front-assembly.png
