Masterltb/pcb/docs/revb/assembly/RevB-top.png

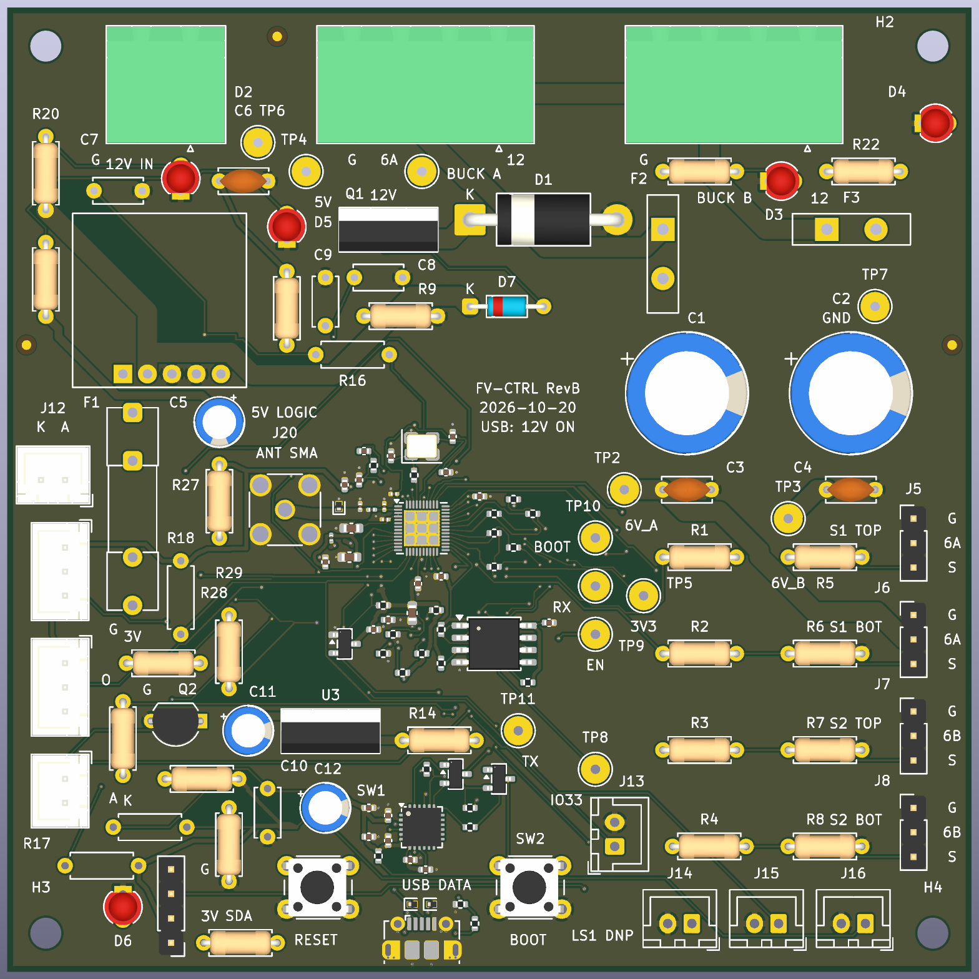
docs/revb/assembly/RevB-top.png
