Masterltb/pcb/pcb-agent-harness/contract/risk-register.csv

id | title | category | likelihood | impact | mitigation | owner | closure_evidence | status
RISK-001 | REPLACE unverified physical behavior | technical | medium | high | prototype test | owner |  | open
