Masterltb/pcb/docs/FV-CTRL_RevA_Schematic.pdf

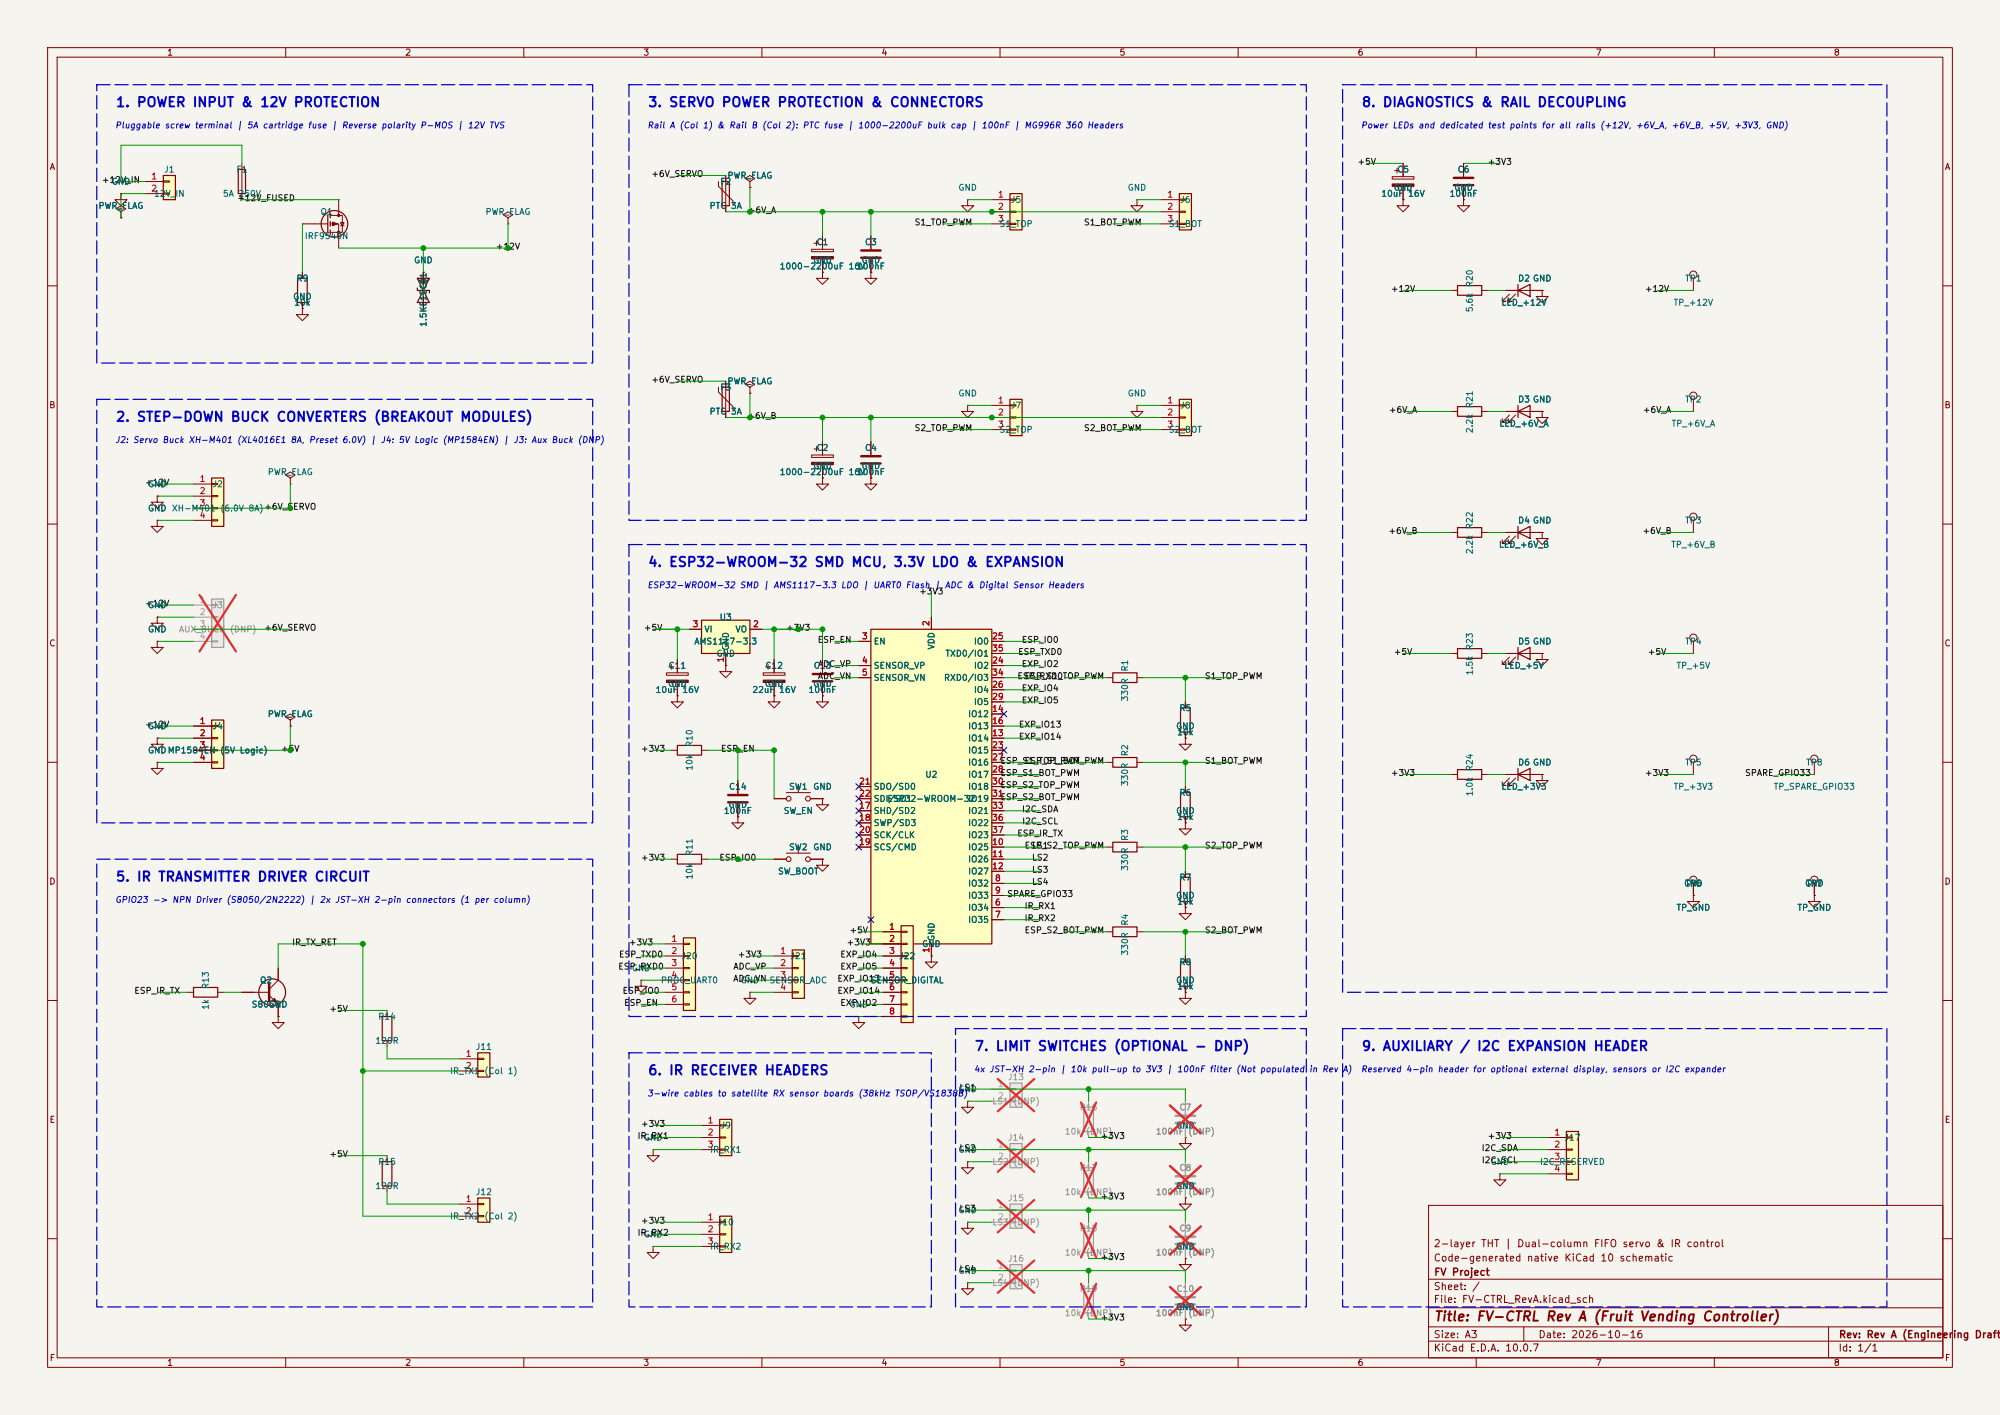
[picture p25: page 1]

Rail A (Col 1) & Rail B (Col 2): PTC fuse | 1000-2200uF bulk cap | 100nF | MG996R 360 Headers 7. LIMIT SWITCHES (OPTIONAL - DNP)

Power LEDs and dedicated test points for all rails (+12V, +6V_A, +6V_B, +5V, +3V3, GND)

2. STEP-DOWN BUCK CONVERTERS (BREAKOUT MODULES)

J2: Servo Buck XH-M401 (XL4016E1 8A, Preset 6.0V) | J4: 5V Logic (MP1584EN) | J3: Aux Buck (DNP)

4. ESP32-WROOM-32 SMD MCU, 3.3V LDO & EXPANSION

2-layer THT | Dual-column FIFO servo & IR control R11 10k

5. IR TRANSMITTER DRIVER CIRCUIT

6. Reserved 4-pin header for optional external display, sensors or I2C expander IR RECEIVER HEADERS

Code-generated native KiCad 10 schematic
FV Project
Sheet: /
File: FV-CTRL_RevA.kicad_sch
Title: FV-CTRL Rev A (Fruit Vending Controller)

F Date: 2026-10-16

KiCad E.D.A. 10.0.7 | Id: 1/1
