Masterltb/pcb/docs/FV-IR-RX_RevA_Schematic.pdf

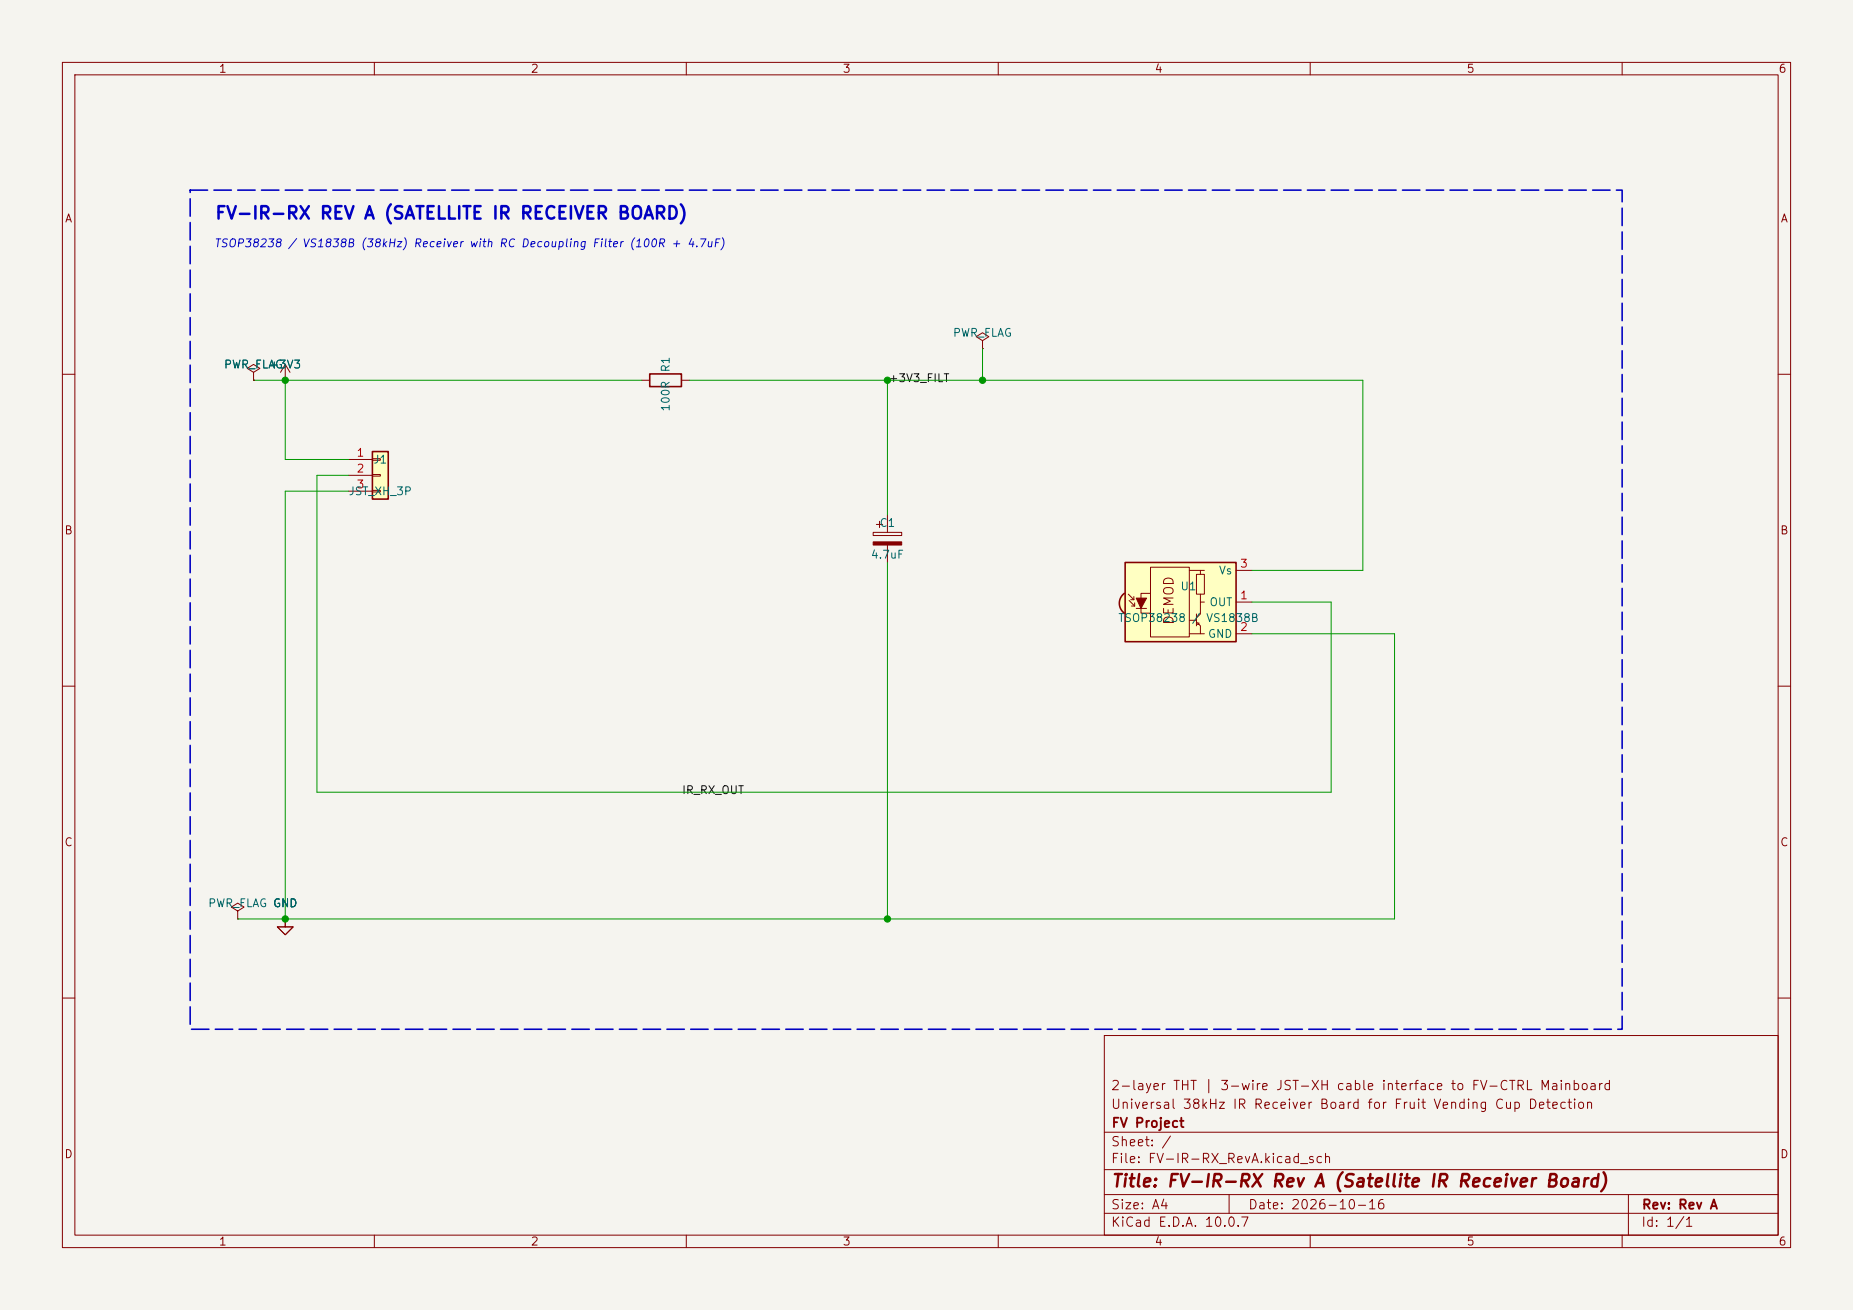
[picture p26: page 1]

FV-IR-RX REV A (SATELLITE IR RECEIVER BOARD)

TSOP38238 / VS1838B (38kHz) Receiver with RC Decoupling Filter (100R + 4.7uF)

2-layer THT | 3-wire JST-XH cable interface to FV-CTRL Mainboard
Universal 38kHz IR Receiver Board for Fruit Vending Cup Detection
FV Project
Sheet: /
File: FV-IR-RX_RevA.kicad_sch
Title: FV-IR-RX Rev A (Satellite IR Receiver Board)

Size: A4 | Rev: Rev A
KiCad E.D.A. 10.0.7 | Id: 1/1
