Masterltb/pcb/docs/FV-CTRL_RevA-schematic.pdf

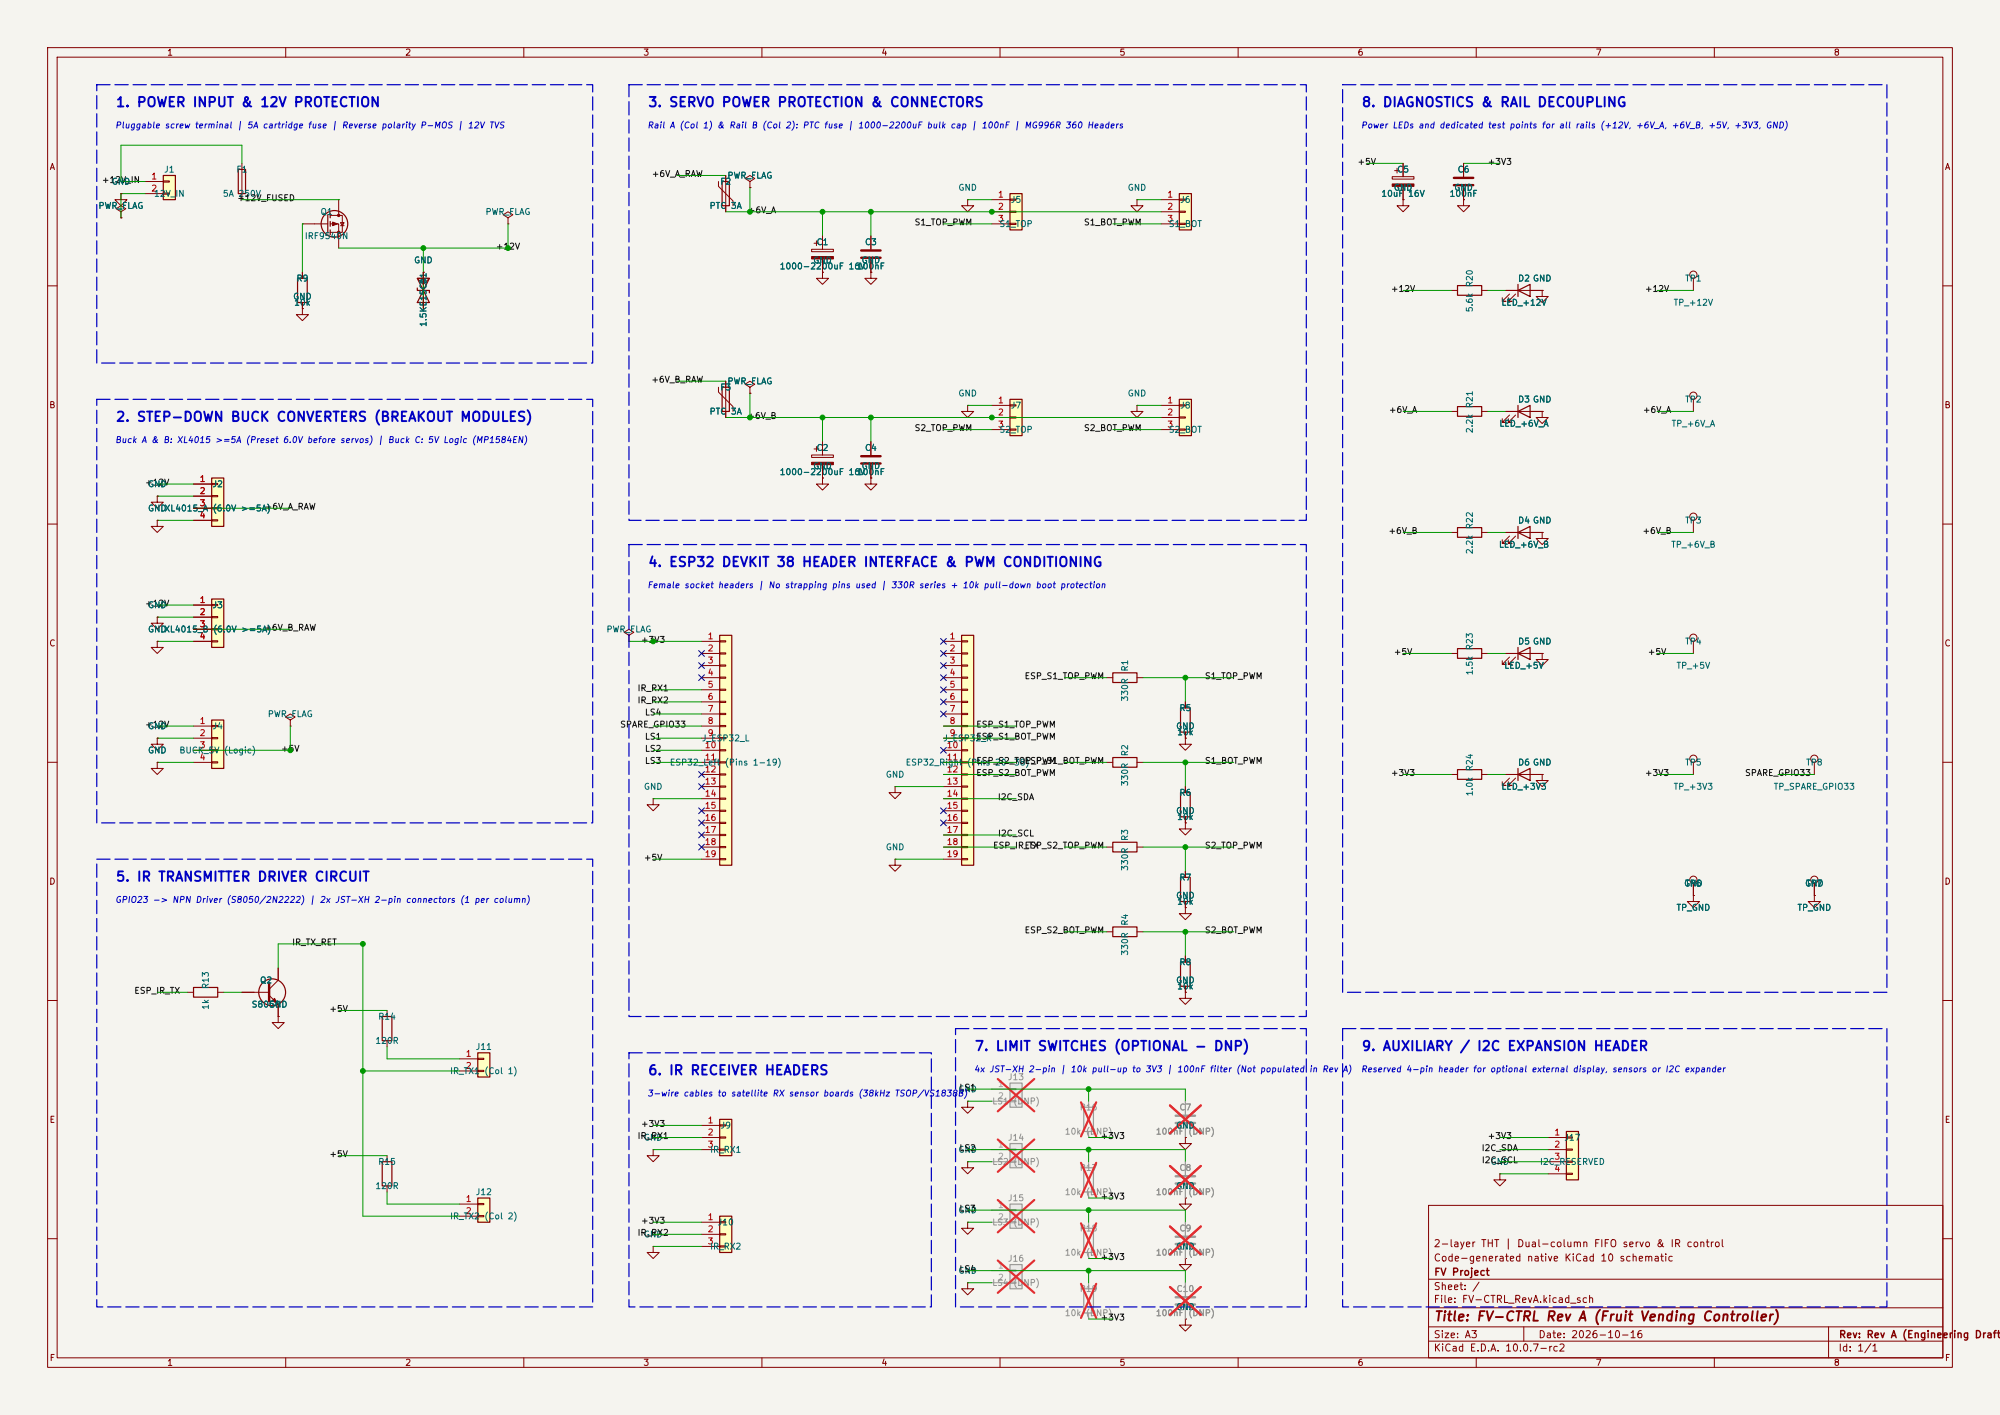
[picture p27: page 1]

Rail A (Col 1) & Rail B (Col 2): PTC fuse | 1000-2200uF bulk cap | 100nF | MG996R 360 Headers 2. STEP-DOWN BUCK CONVERTERS (BREAKOUT MODULES)
Pluggable screw terminal | 5A cartridge fuse | Reverse polarity P-MOS | 12V TVS

Power LEDs and dedicated test points for all rails (+12V, +6V_A, +6V_B, +5V, +3V3, GND)

Buck A & B: XL4015 >=5A (Preset 6.0V before servos) | Buck C: 5V Logic (MP1584EN)

4. ESP32 DEVKIT 38 HEADER INTERFACE & PWM CONDITIONING

Female socket headers | No strapping pins used | 330R series + 10k pull-down boot protection

5. IR TRANSMITTER DRIVER CIRCUIT

GPIO23 -> NPN Driver (S8050/2N2222) | 2x JST-XH 2-pin connectors (1 per column)

7. LIMIT SWITCHES (OPTIONAL - DNP)
10k (DNP) R16

6. IR RECEIVER HEADERS
Reserved 4-pin header for optional external display, sensors or I2C expander 3-wire cables to satellite RX sensor boards (38kHz TSOP/VS1838B)

2-layer THT | Dual-column FIFO servo & IR control
Code-generated native KiCad 10 schematic
FV Project
Sheet: /
File: FV-CTRL_RevA.kicad_sch
Title: FV-CTRL Rev A (Fruit Vending Controller)

F Date: 2026-10-16

KiCad E.D.A. 10.0.7-rc2 | Id: 1/1
