Masterltb/pcb/hardware/revb/FV-CTRL_RevB.kicad_pcb

## KiCad design hardware/revb/FV-CTRL_RevB.kicad_pcb (2026-10-20)

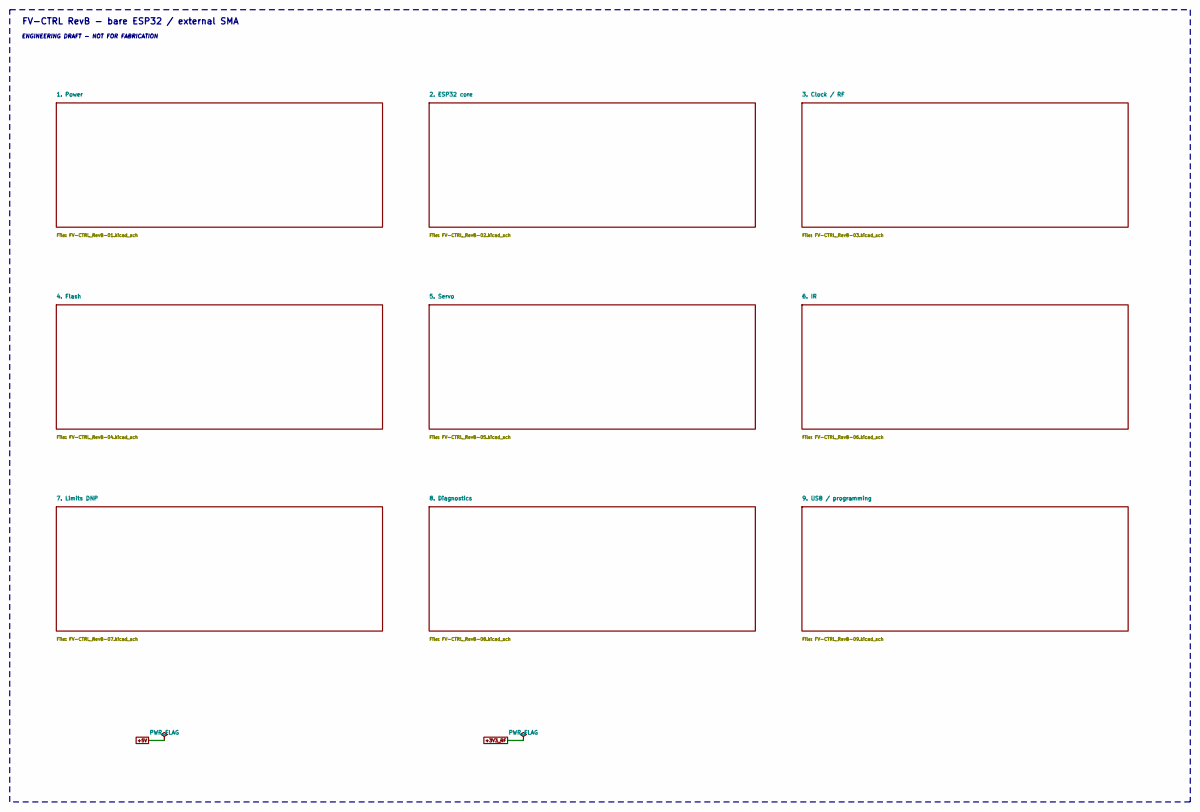
[picture p28: schematic FV-CTRL_RevB.kicad_sch, FV-CTRL RevB - schematic index]

Notes on the sheet:
FV-CTRL RevB - bare ESP32 / external SMA
ENGINEERING DRAFT - NOT FOR FABRICATION

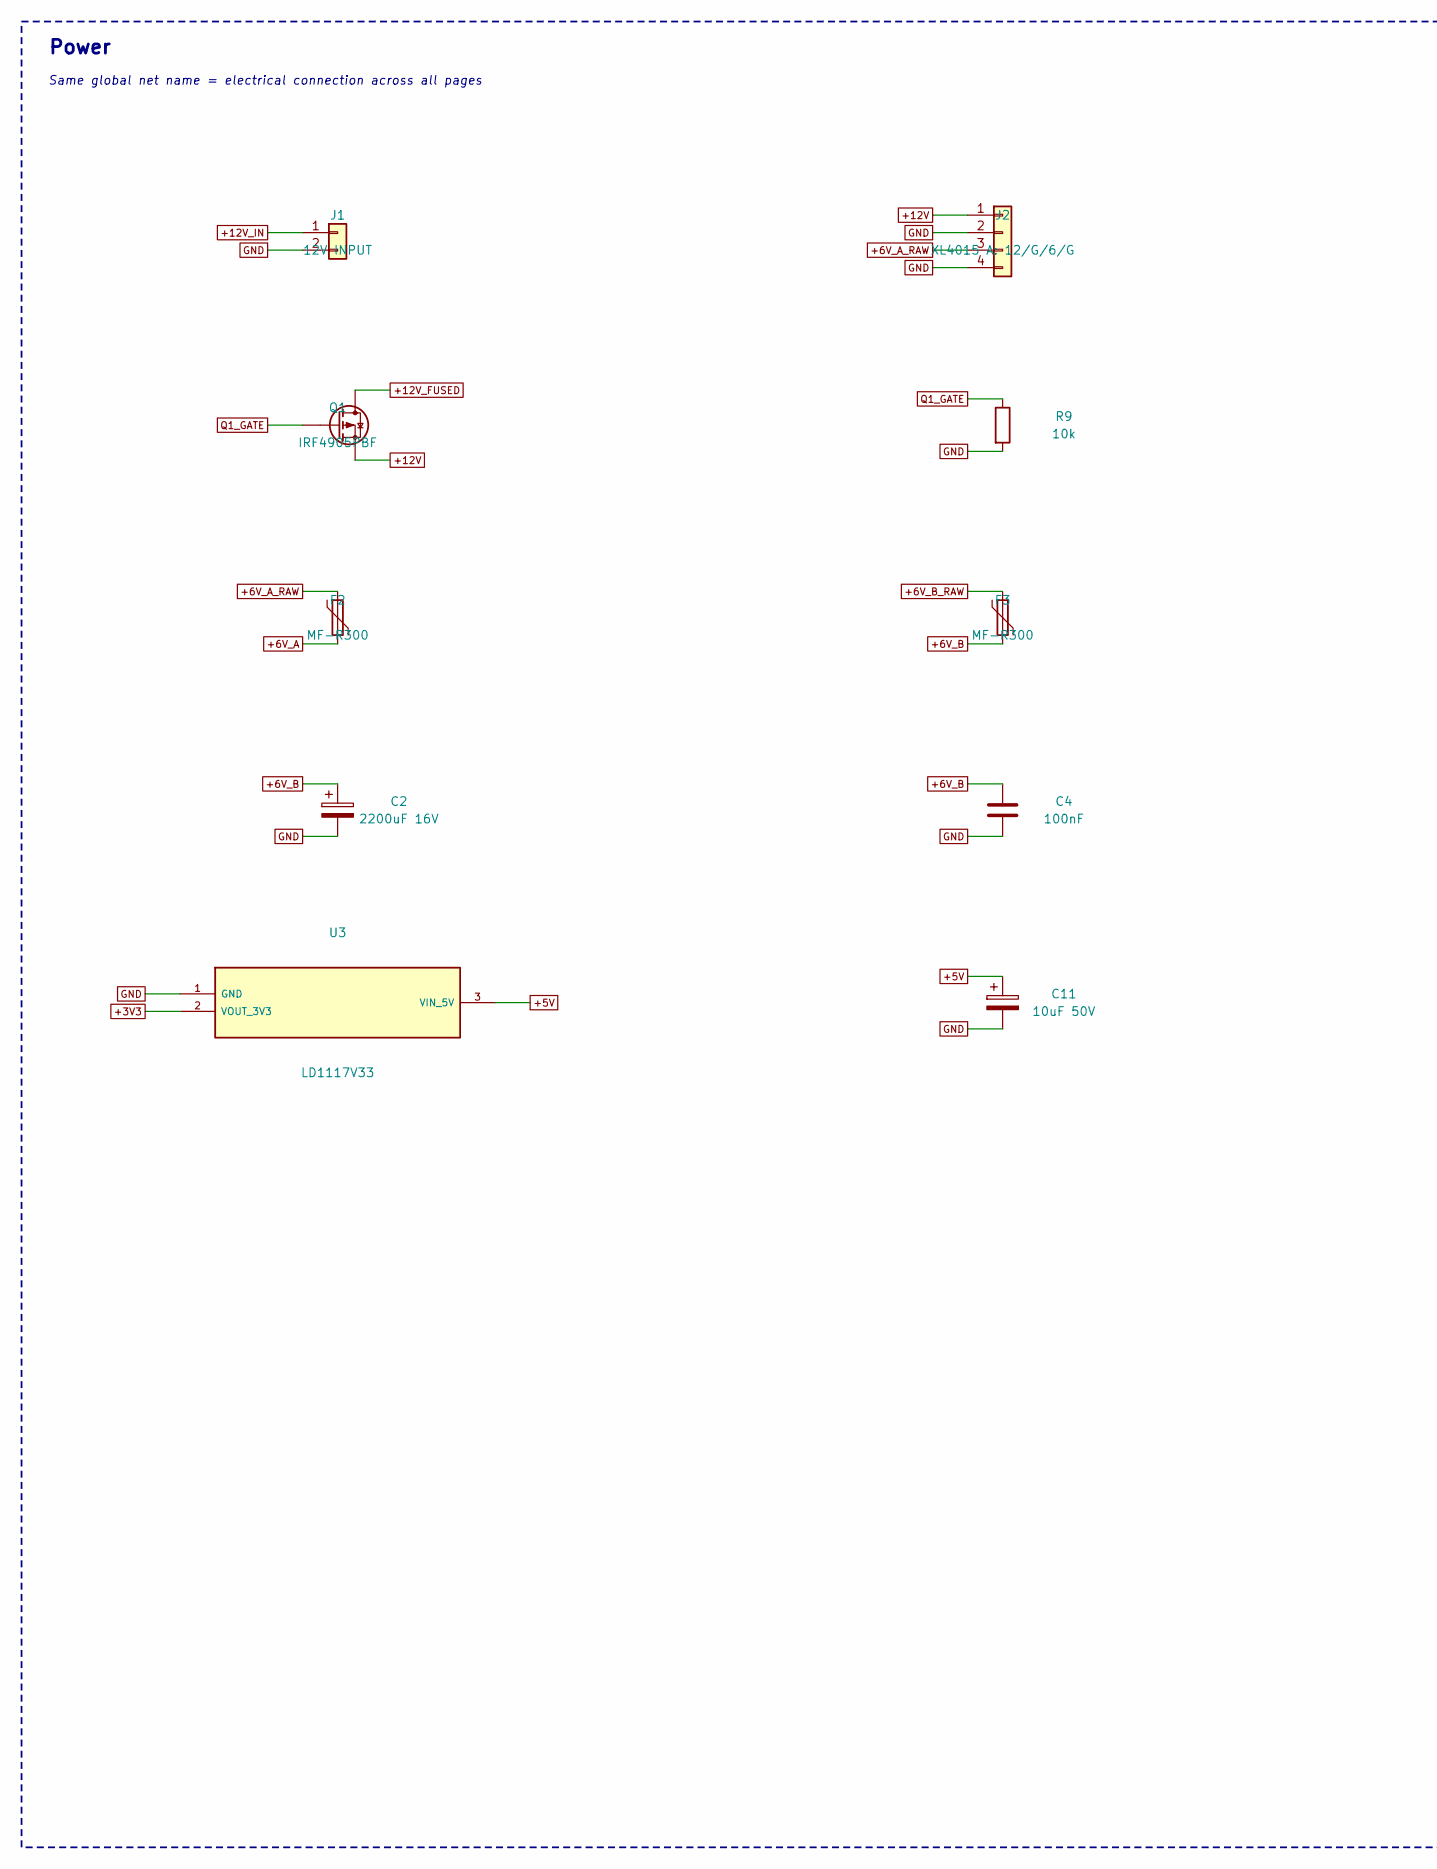
[picture p29: schematic FV-CTRL_RevB-01.kicad_sch, FV-CTRL RevB / Power, part in row 1, column 1]

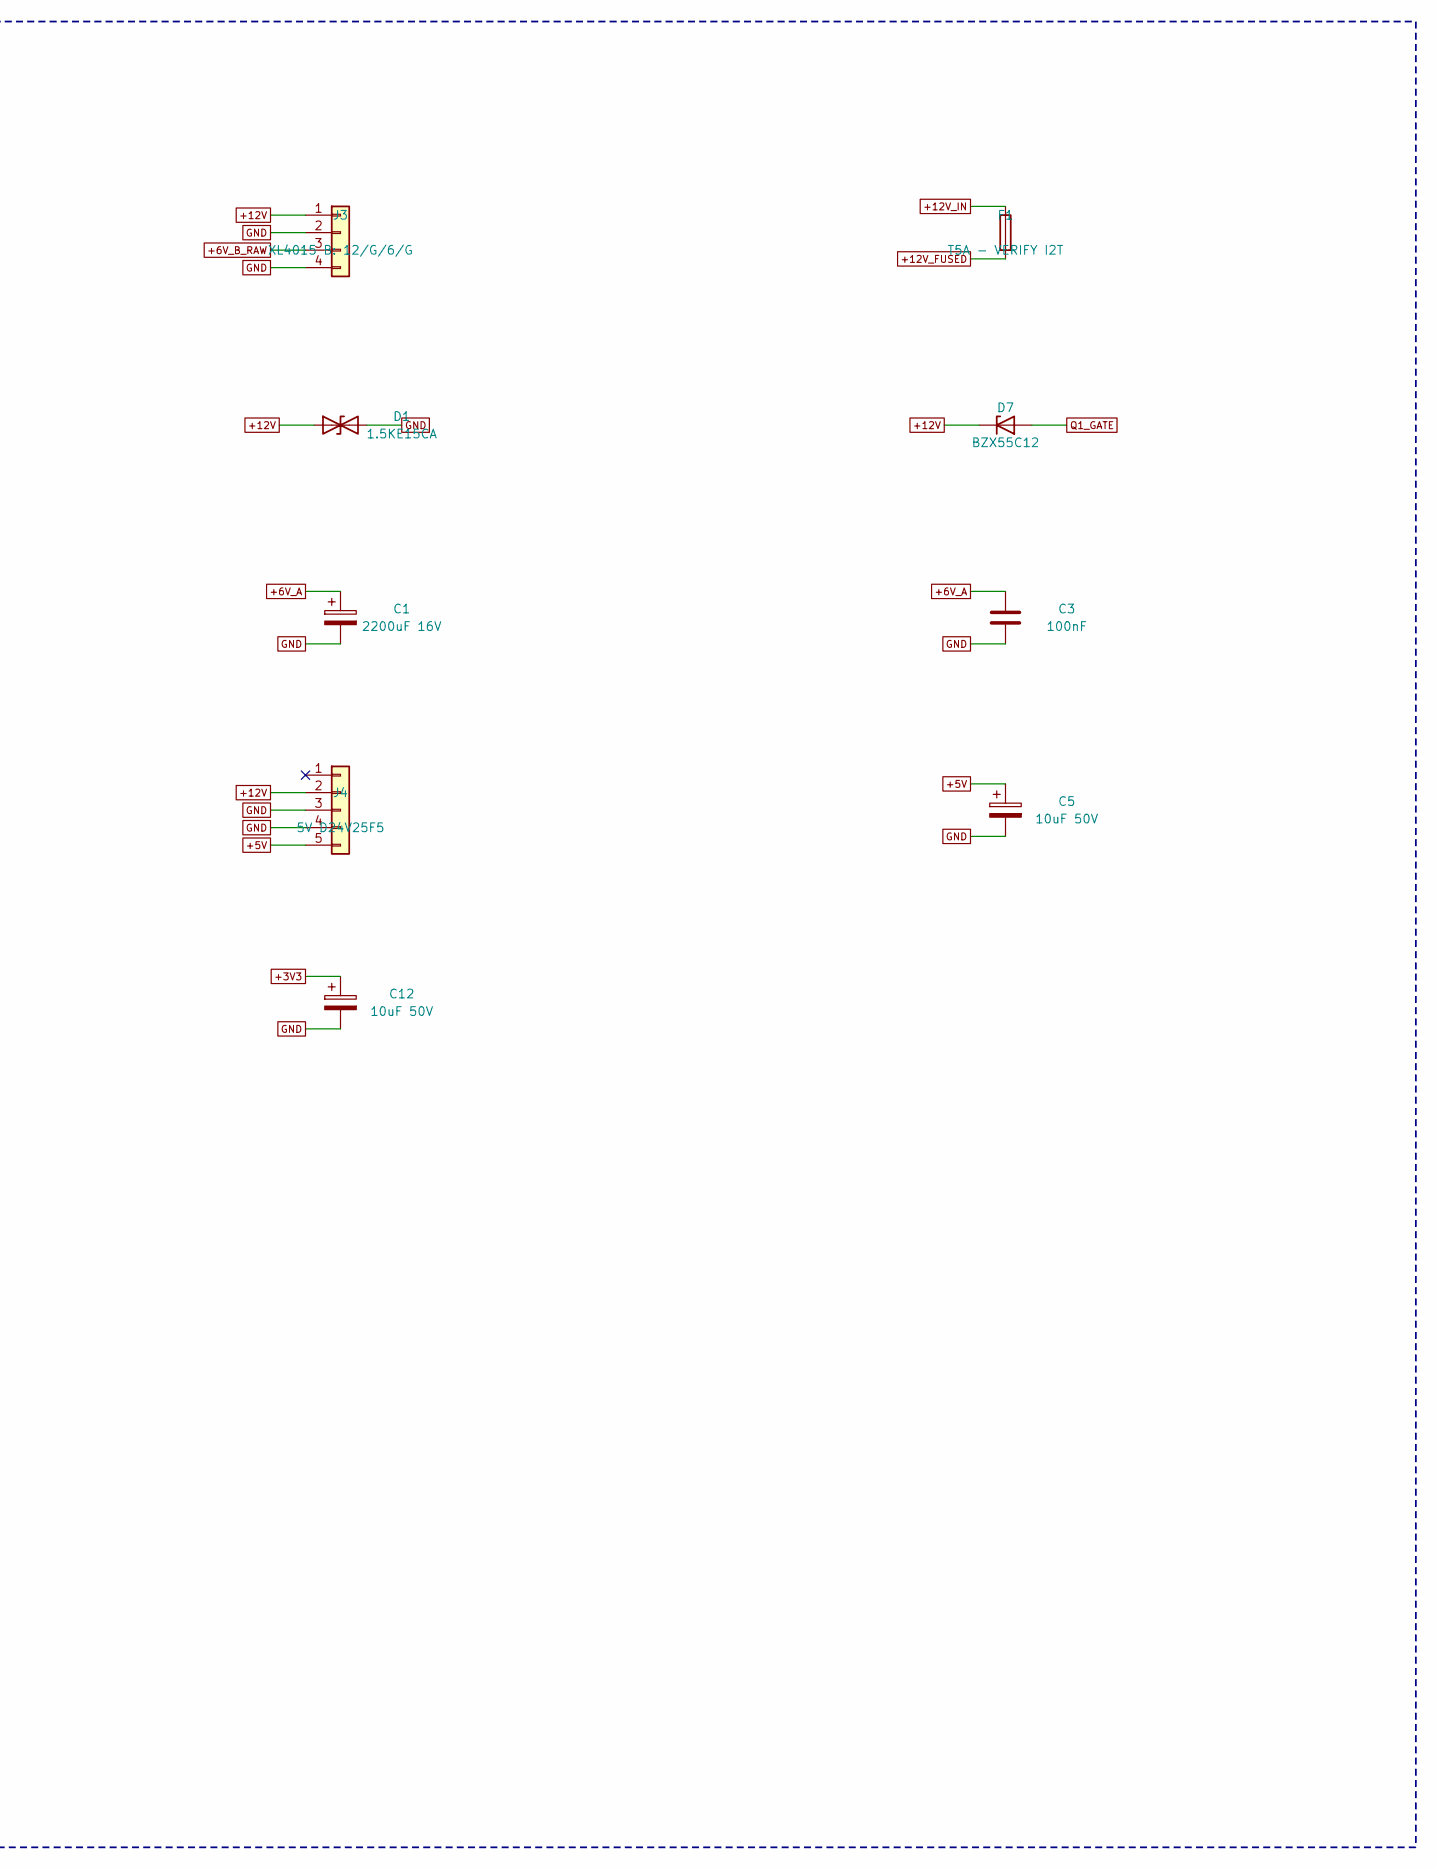
[picture p30: schematic FV-CTRL_RevB-01.kicad_sch, FV-CTRL RevB / Power, part in row 1, column 2]

Parts:
C1, C2: 2200uF 16V; CP_Radial_D12.5mm_P5.00mm
C3, C4: 100nF; C_Disc_D5.0mm_W2.5mm_P5.00mm
C5, C11, C12: 10uF 50V; CP_Radial_D5.0mm_P2.00mm
D1: 1.5KE15CA; D_DO-201AD_P15.24mm_Horizontal
D7: BZX55C12; D_DO-35_SOD27_P7.62mm_Horizontal
F1: T5A - VERIFY I2T; Fuseholder_Clip-5x20mm_Littelfuse_111_Inline_P20.00x5.00mm_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
F2, F3: MF-R300; MF_R300
J1: 12V INPUT; PhoenixContact_MSTBA_2,5_2-G-5,08_1x02_P5.08mm_Horizontal
J2: XL4015 A: 12/G/6/G; PhoenixContact_MSTBA_2,5_4-G-5,08_1x04_P5.08mm_Horizontal
J3: XL4015 B: 12/G/6/G; PhoenixContact_MSTBA_2,5_4-G-5,08_1x04_P5.08mm_Horizontal
J4: 5V D24V25F5; Pololu_D24V25F5
Q1: IRF4905PBF; PMOS_GDS
R9: 10k; R_Axial_DIN0207_L6.3mm_D2.5mm_P7.62mm_Horizontal
U3: LD1117V33; TO-220-3_Vertical

Connections:
+3V3: C12.1, U3.2 (VOUT_3V3); also elsewhere on the board
+5V: C5.1, C11.1, J4.5, U3.3 (VIN_5V); also elsewhere on the board
+6V_A: C1.1, C3.1, F2.2; also elsewhere on the board
+6V_A_RAW: F2.1, J2.3
+6V_B: C2.1, C4.1, F3.2; also elsewhere on the board
+6V_B_RAW: F3.1, J3.3
+12V: D1.1 (A1), D7.1 (K), J2.1, J3.1, J4.2, Q1.S; also elsewhere on the board
+12V_FUSED: F1.2, Q1.D
+12V_IN: F1.1, J1.1
GND: C1.2, C2.2, C3.2, C4.2, C5.2, C11.2, C12.2, D1.2 (A2), J1.2, J2.2, J2.4, J3.2, J3.4, J4.3, J4.4, R9.2, U3.1 (GND); also elsewhere on the board
Q1_GATE: D7.2 (A), Q1.G, R9.1

Notes on the sheet:
Power
Same global net name = electrical connection across all pages

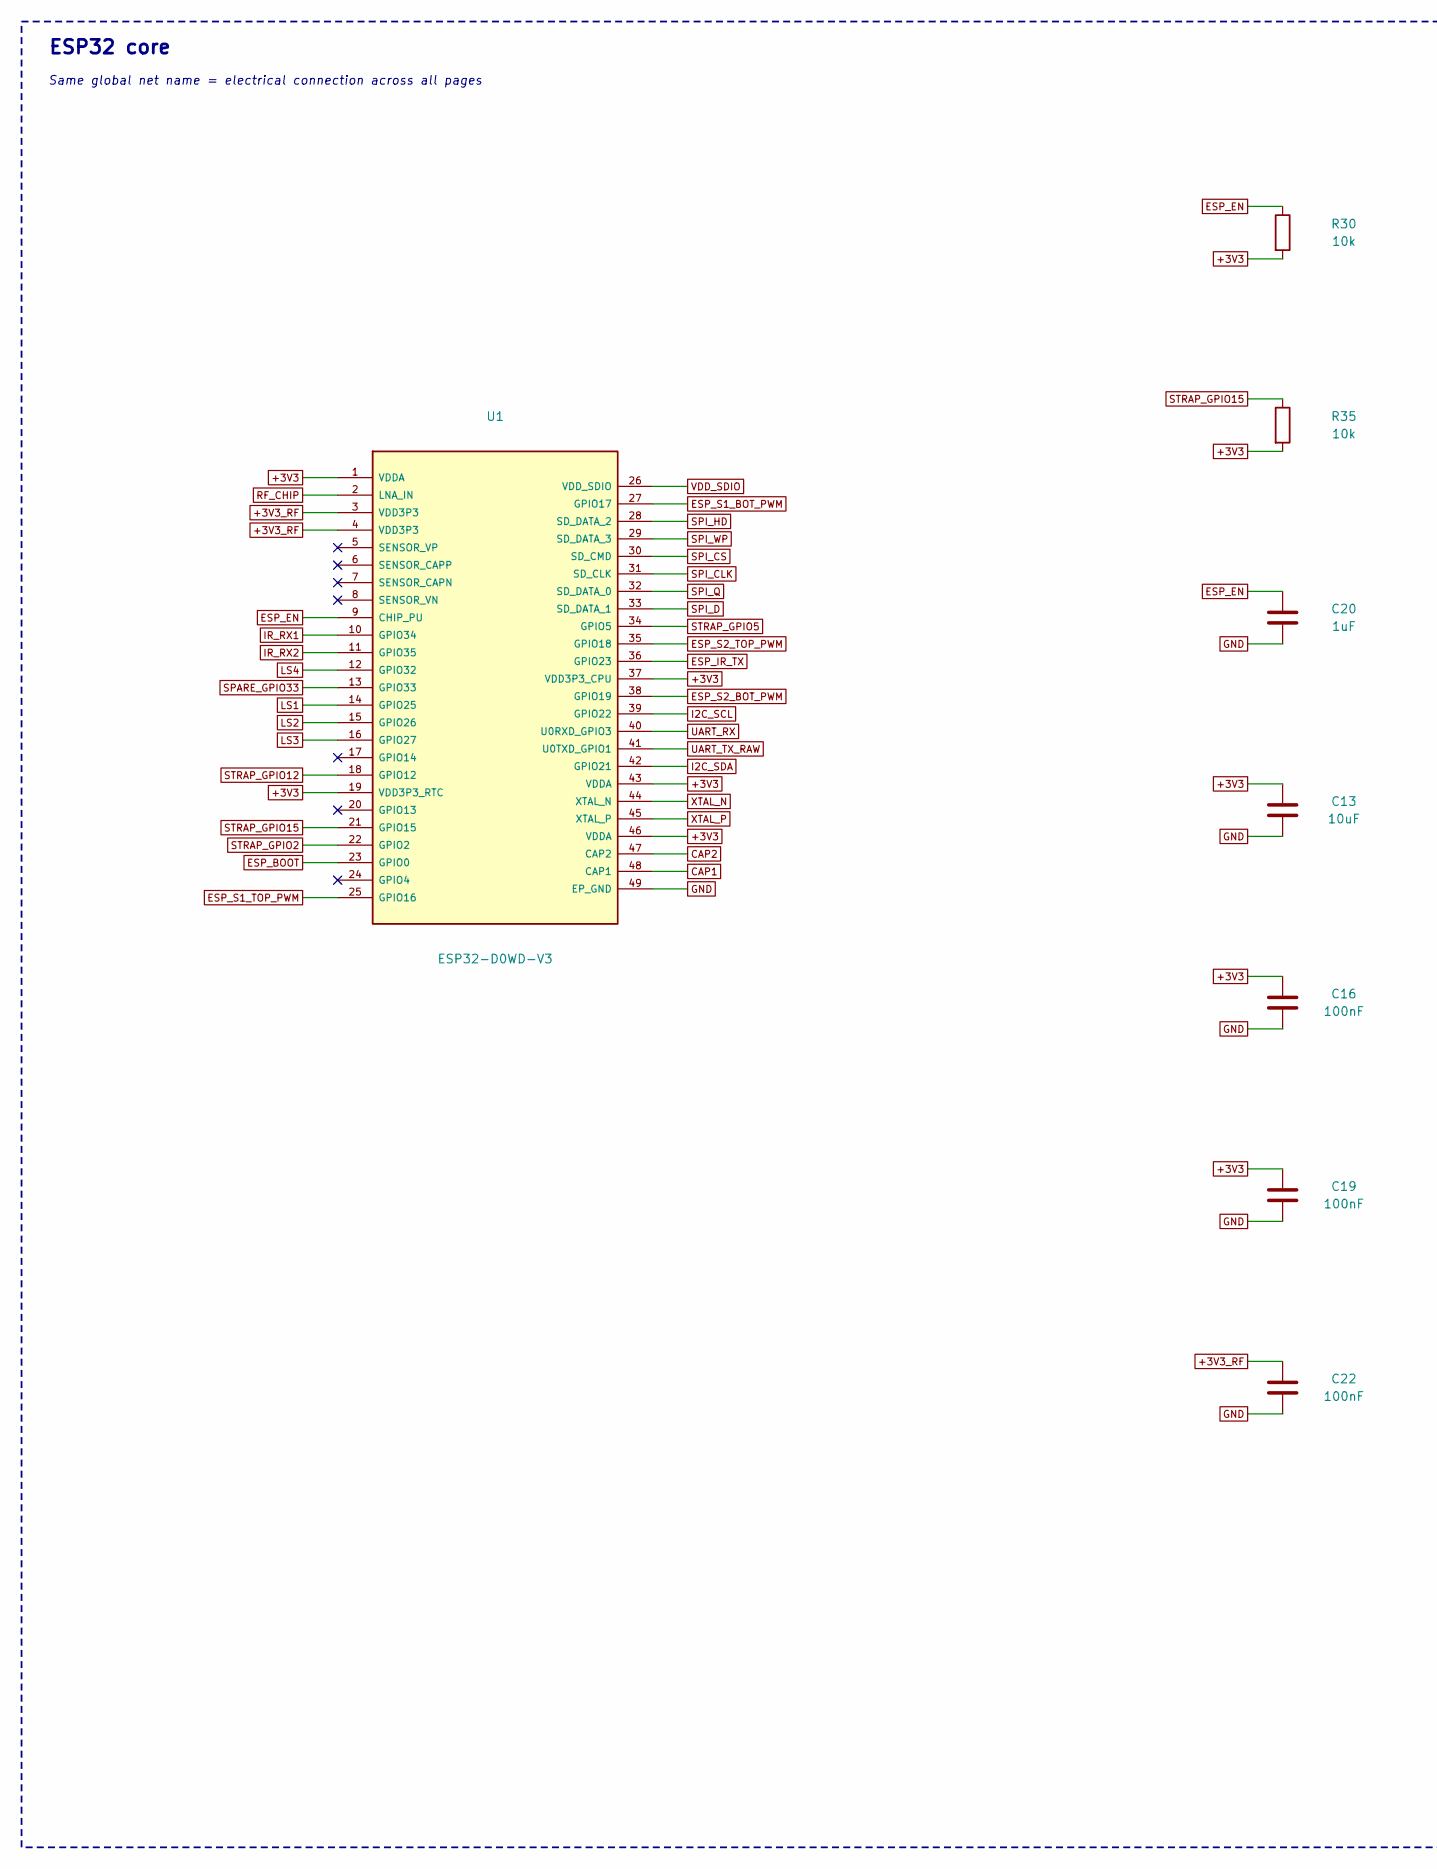
[picture p31: schematic FV-CTRL_RevB-02.kicad_sch, FV-CTRL RevB / ESP32 core, part in row 1, column 1]

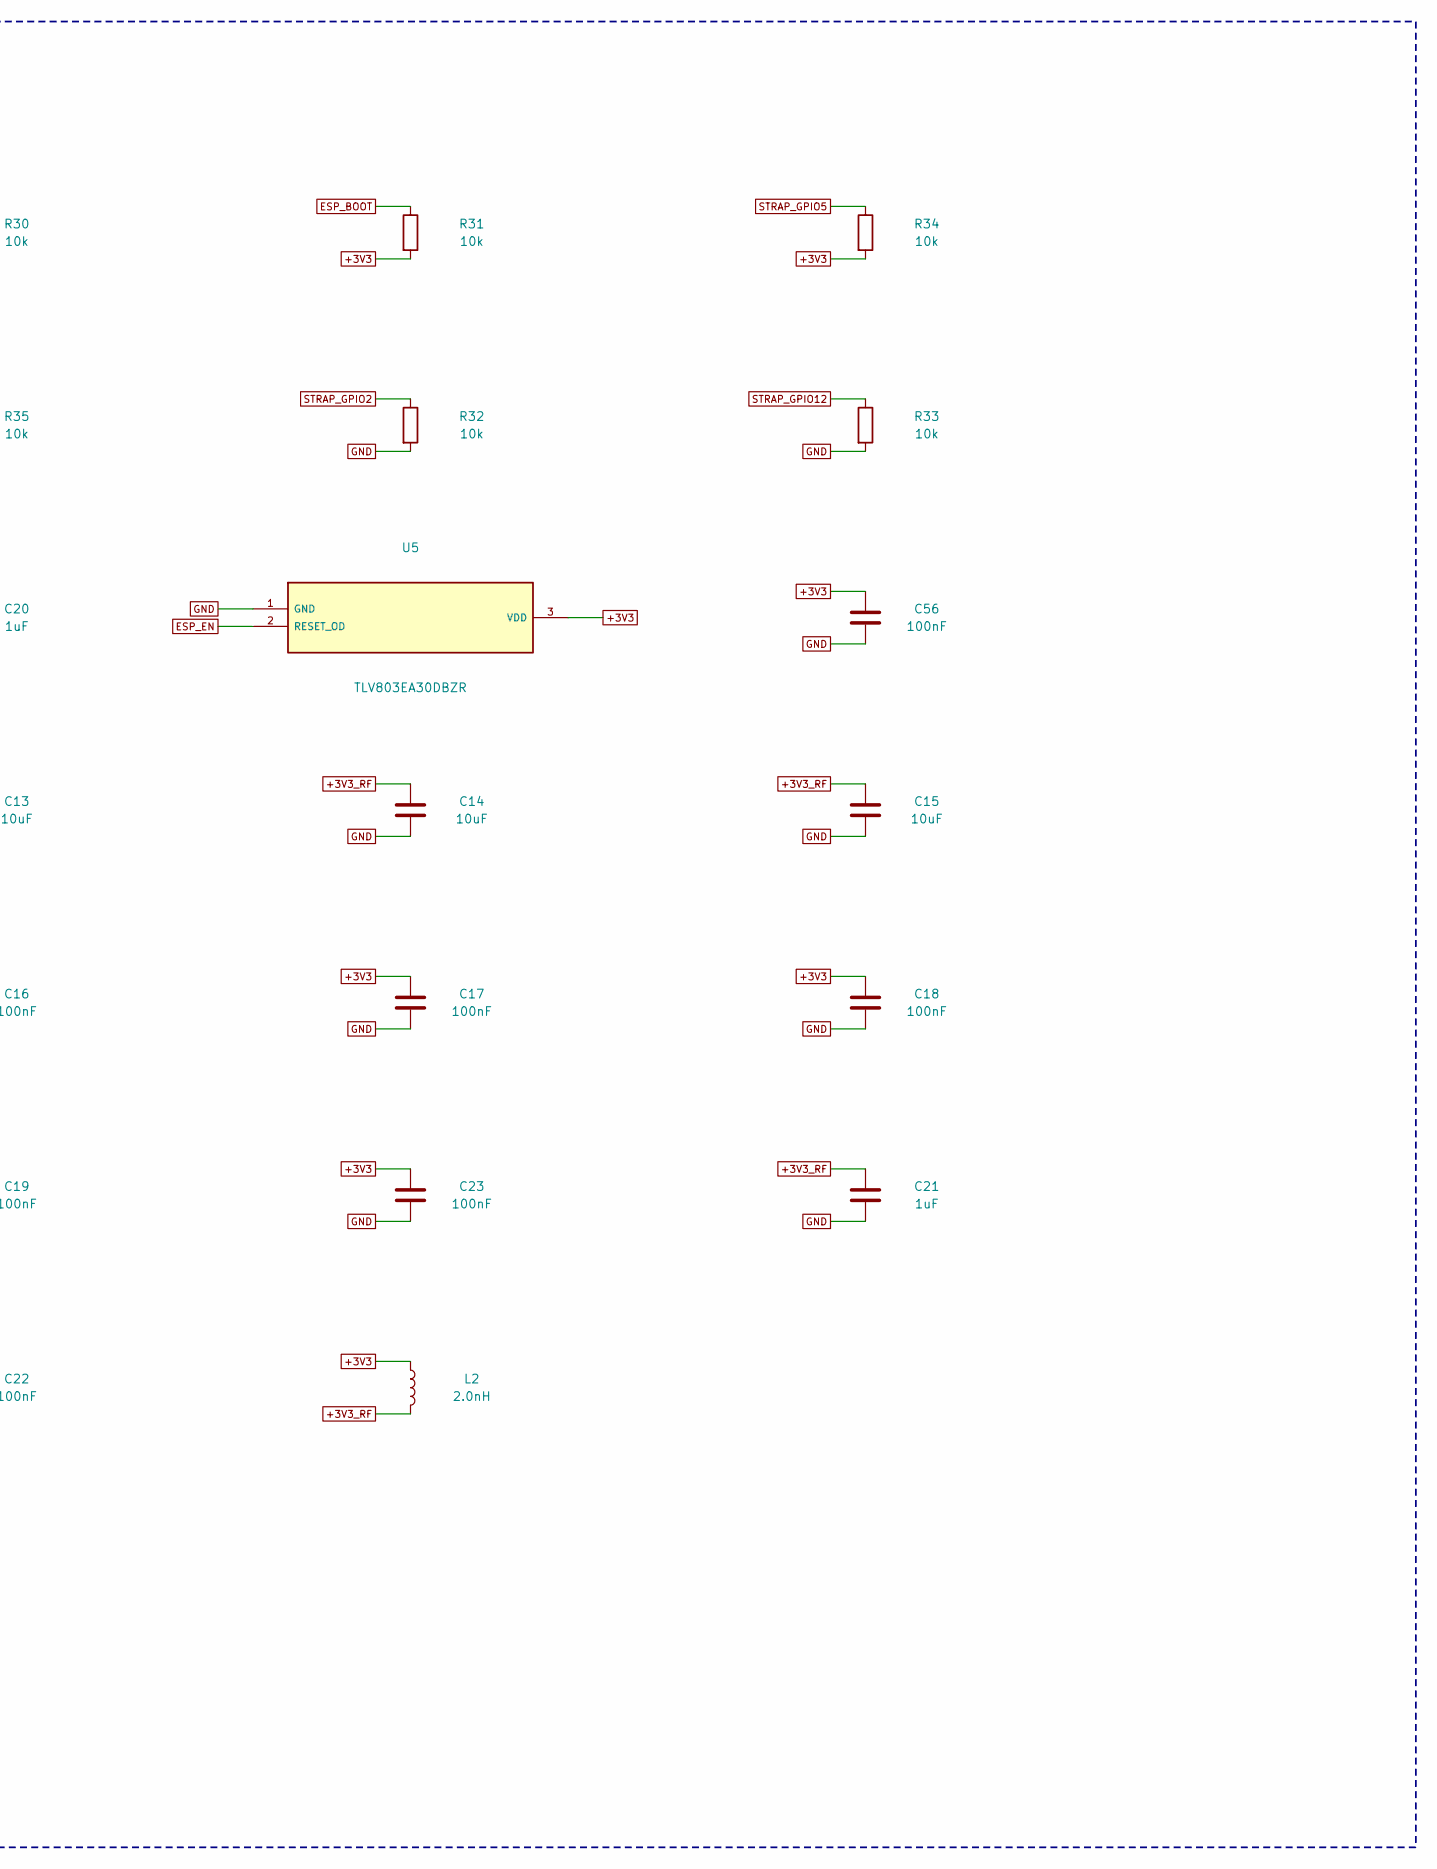
[picture p32: schematic FV-CTRL_RevB-02.kicad_sch, FV-CTRL RevB / ESP32 core, part in row 1, column 2]

Parts:
C13, C14, C15: 10uF; C_0603_1608Metric
C16, C17, C18, C19, C56: 100nF; C_0402_1005Metric
C20, C21: 1uF; C_0402_1005Metric
C22, C23: 100nF; C_0201_0603Metric
L2: 2.0nH; L_0201_0603Metric
R30, R31, R32, R33, R34, R35: 10k; R_0402_1005Metric
U1: ESP32-D0WD-V3; QFN-48-1EP_5x5mm_P0.35mm_EP3.7x3.7mm_ThermalVias
U5: TLV803EA30DBZR; SOT-23

Connections:
+3V3: C13.1, C16.1, C17.1, C18.1, C19.1, C23.1, C56.1, L2.1, R30.2, R31.2, R34.2, R35.2, U1.1 (VDDA), U1.19 (VDD3P3_RTC), U1.37 (VDD3P3_CPU), U1.43 (VDDA), U1.46 (VDDA), U5.3 (VDD); also elsewhere on the board
+3V3_RF: C14.1, C15.1, C21.1, C22.1, L2.2, U1.3 (VDD3P3), U1.4 (VDD3P3)
CAP1: U1.48 (CAP1); also elsewhere on the board
CAP2: U1.47 (CAP2); also elsewhere on the board
ESP_BOOT: R31.1, U1.23 (GPIO0); also elsewhere on the board
ESP_EN: C20.1, R30.1, U1.9 (CHIP_PU), U5.2 (RESET_OD); also elsewhere on the board
ESP_IR_TX: U1.36 (GPIO23); also elsewhere on the board
ESP_S1_BOT_PWM: U1.27 (GPIO17); also elsewhere on the board
ESP_S1_TOP_PWM: U1.25 (GPIO16); also elsewhere on the board
ESP_S2_BOT_PWM: U1.38 (GPIO19); also elsewhere on the board
ESP_S2_TOP_PWM: U1.35 (GPIO18); also elsewhere on the board
GND: C13.2, C14.2, C15.2, C16.2, C17.2, C18.2, C19.2, C20.2, C21.2, C22.2, C23.2, C56.2, R32.2, R33.2, U1.49 (EP_GND), U5.1 (GND); also elsewhere on the board
I2C_SCL: U1.39 (GPIO22); also elsewhere on the board
I2C_SDA: U1.42 (GPIO21); also elsewhere on the board
IR_RX1: U1.10 (GPIO34); also elsewhere on the board
IR_RX2: U1.11 (GPIO35); also elsewhere on the board
LS1: U1.14 (GPIO25); also elsewhere on the board
LS2: U1.15 (GPIO26); also elsewhere on the board
LS3: U1.16 (GPIO27); also elsewhere on the board
LS4: U1.12 (GPIO32); also elsewhere on the board
RF_CHIP: U1.2 (LNA_IN); also elsewhere on the board
SPARE_GPIO33: U1.13 (GPIO33); also elsewhere on the board
SPI_CLK: U1.31 (SD_CLK); also elsewhere on the board
SPI_CS: U1.30 (SD_CMD); also elsewhere on the board
SPI_D: U1.33 (SD_DATA_1); also elsewhere on the board
SPI_HD: U1.28 (SD_DATA_2); also elsewhere on the board
SPI_Q: U1.32 (SD_DATA_0); also elsewhere on the board
SPI_WP: U1.29 (SD_DATA_3); also elsewhere on the board
STRAP_GPIO2: R32.1, U1.22 (GPIO2)
STRAP_GPIO5: R34.1, U1.34 (GPIO5)
STRAP_GPIO12: R33.1, U1.18 (GPIO12)
STRAP_GPIO15: R35.1, U1.21 (GPIO15)
UART_RX: U1.40 (U0RXD_GPIO3); also elsewhere on the board
UART_TX_RAW: U1.41 (U0TXD_GPIO1); also elsewhere on the board
VDD_SDIO: U1.26 (VDD_SDIO); also elsewhere on the board
XTAL_N: U1.44 (XTAL_N); also elsewhere on the board
XTAL_P: U1.45 (XTAL_P); also elsewhere on the board

Notes on the sheet:
ESP32 core
Same global net name = electrical connection across all pages

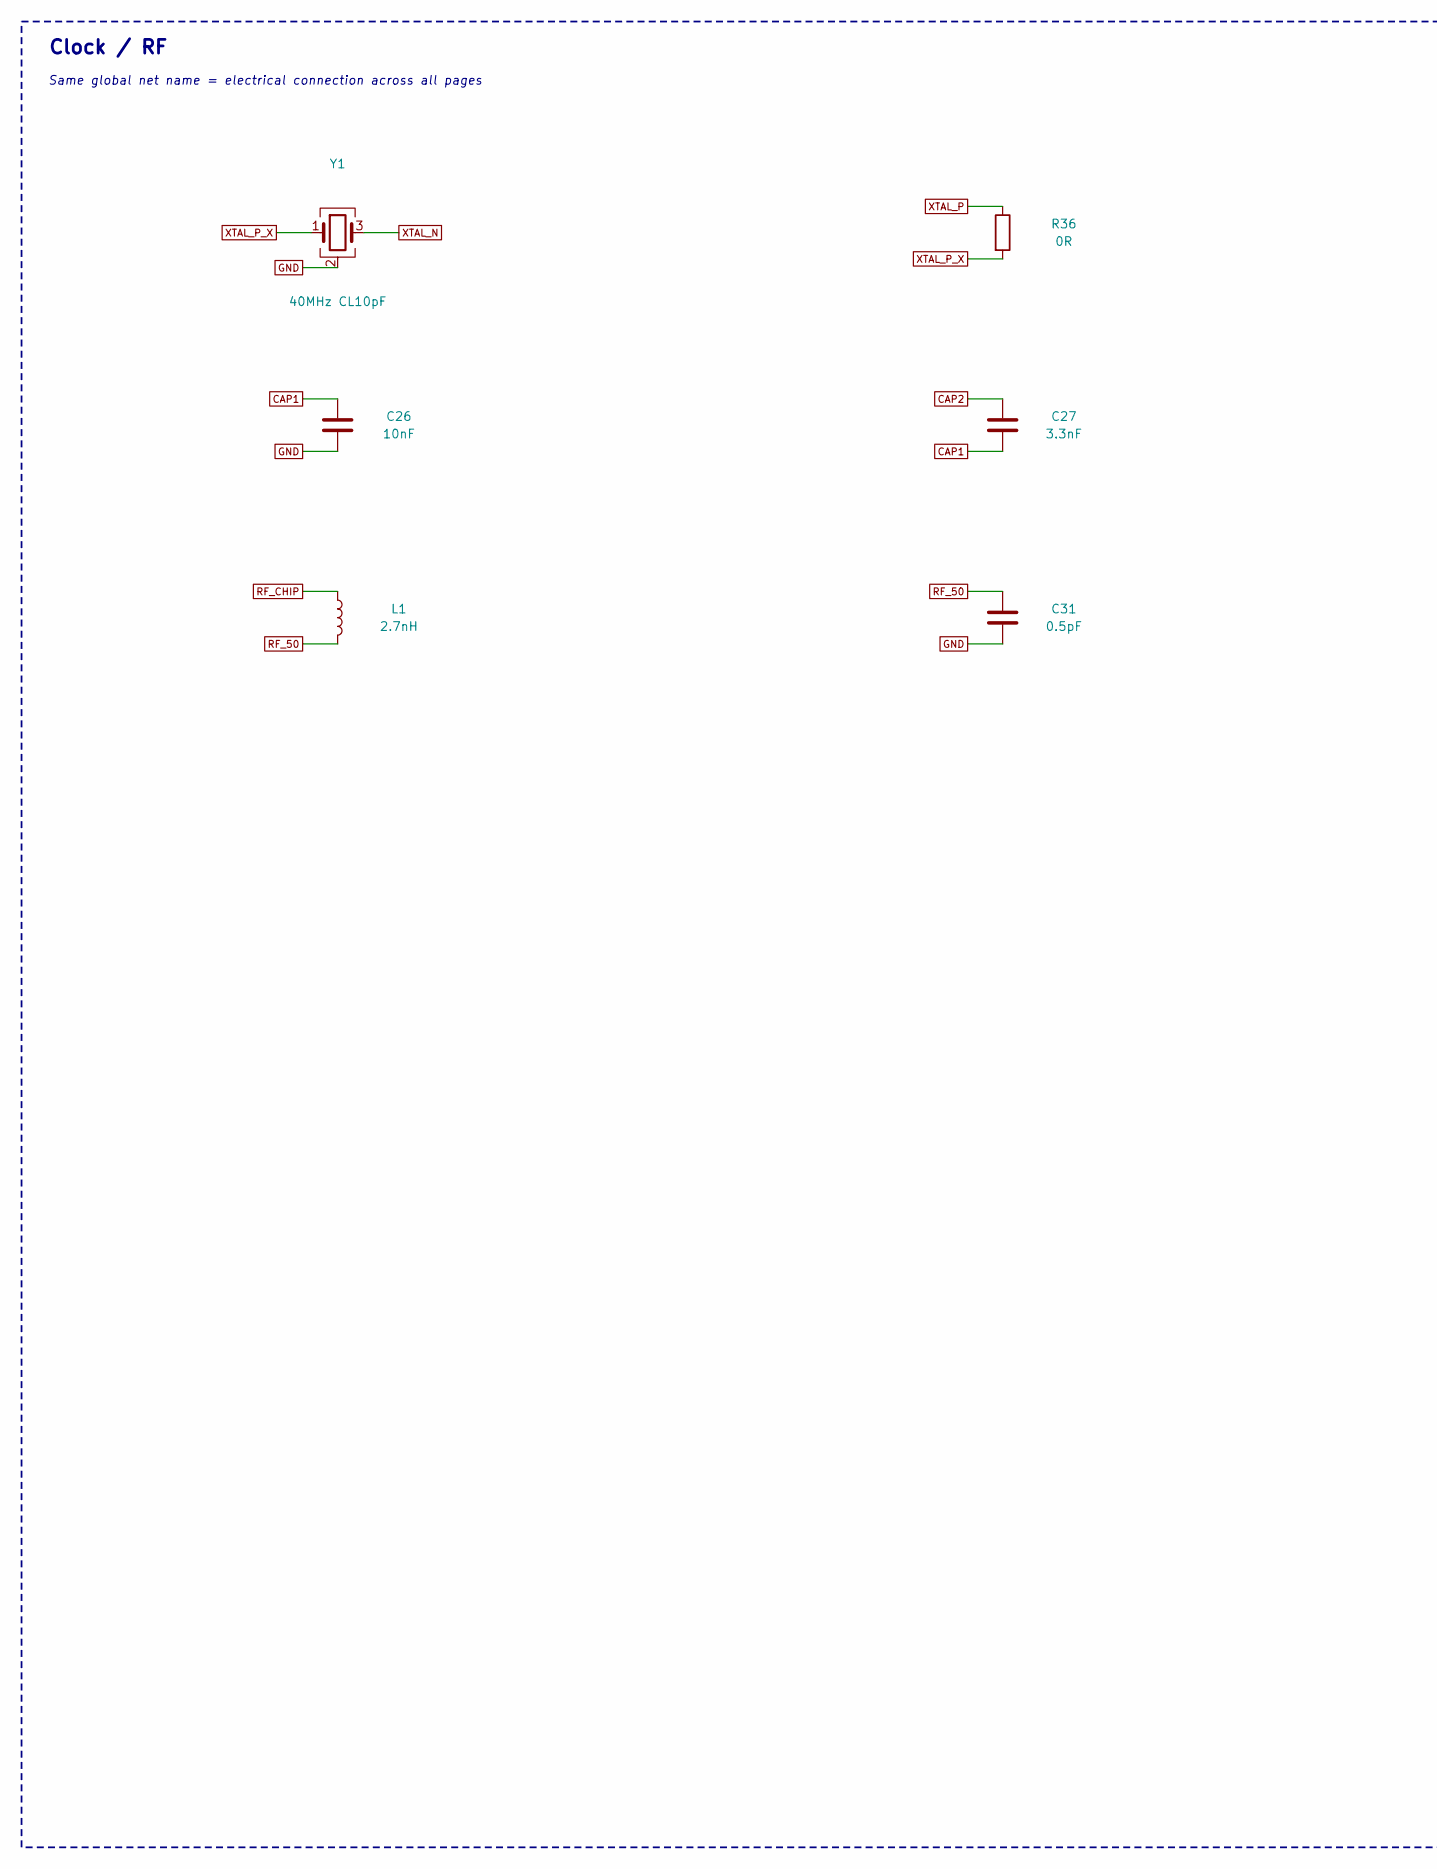
[picture p33: schematic FV-CTRL_RevB-03.kicad_sch, FV-CTRL RevB / Clock / RF, part in row 1, column 1]

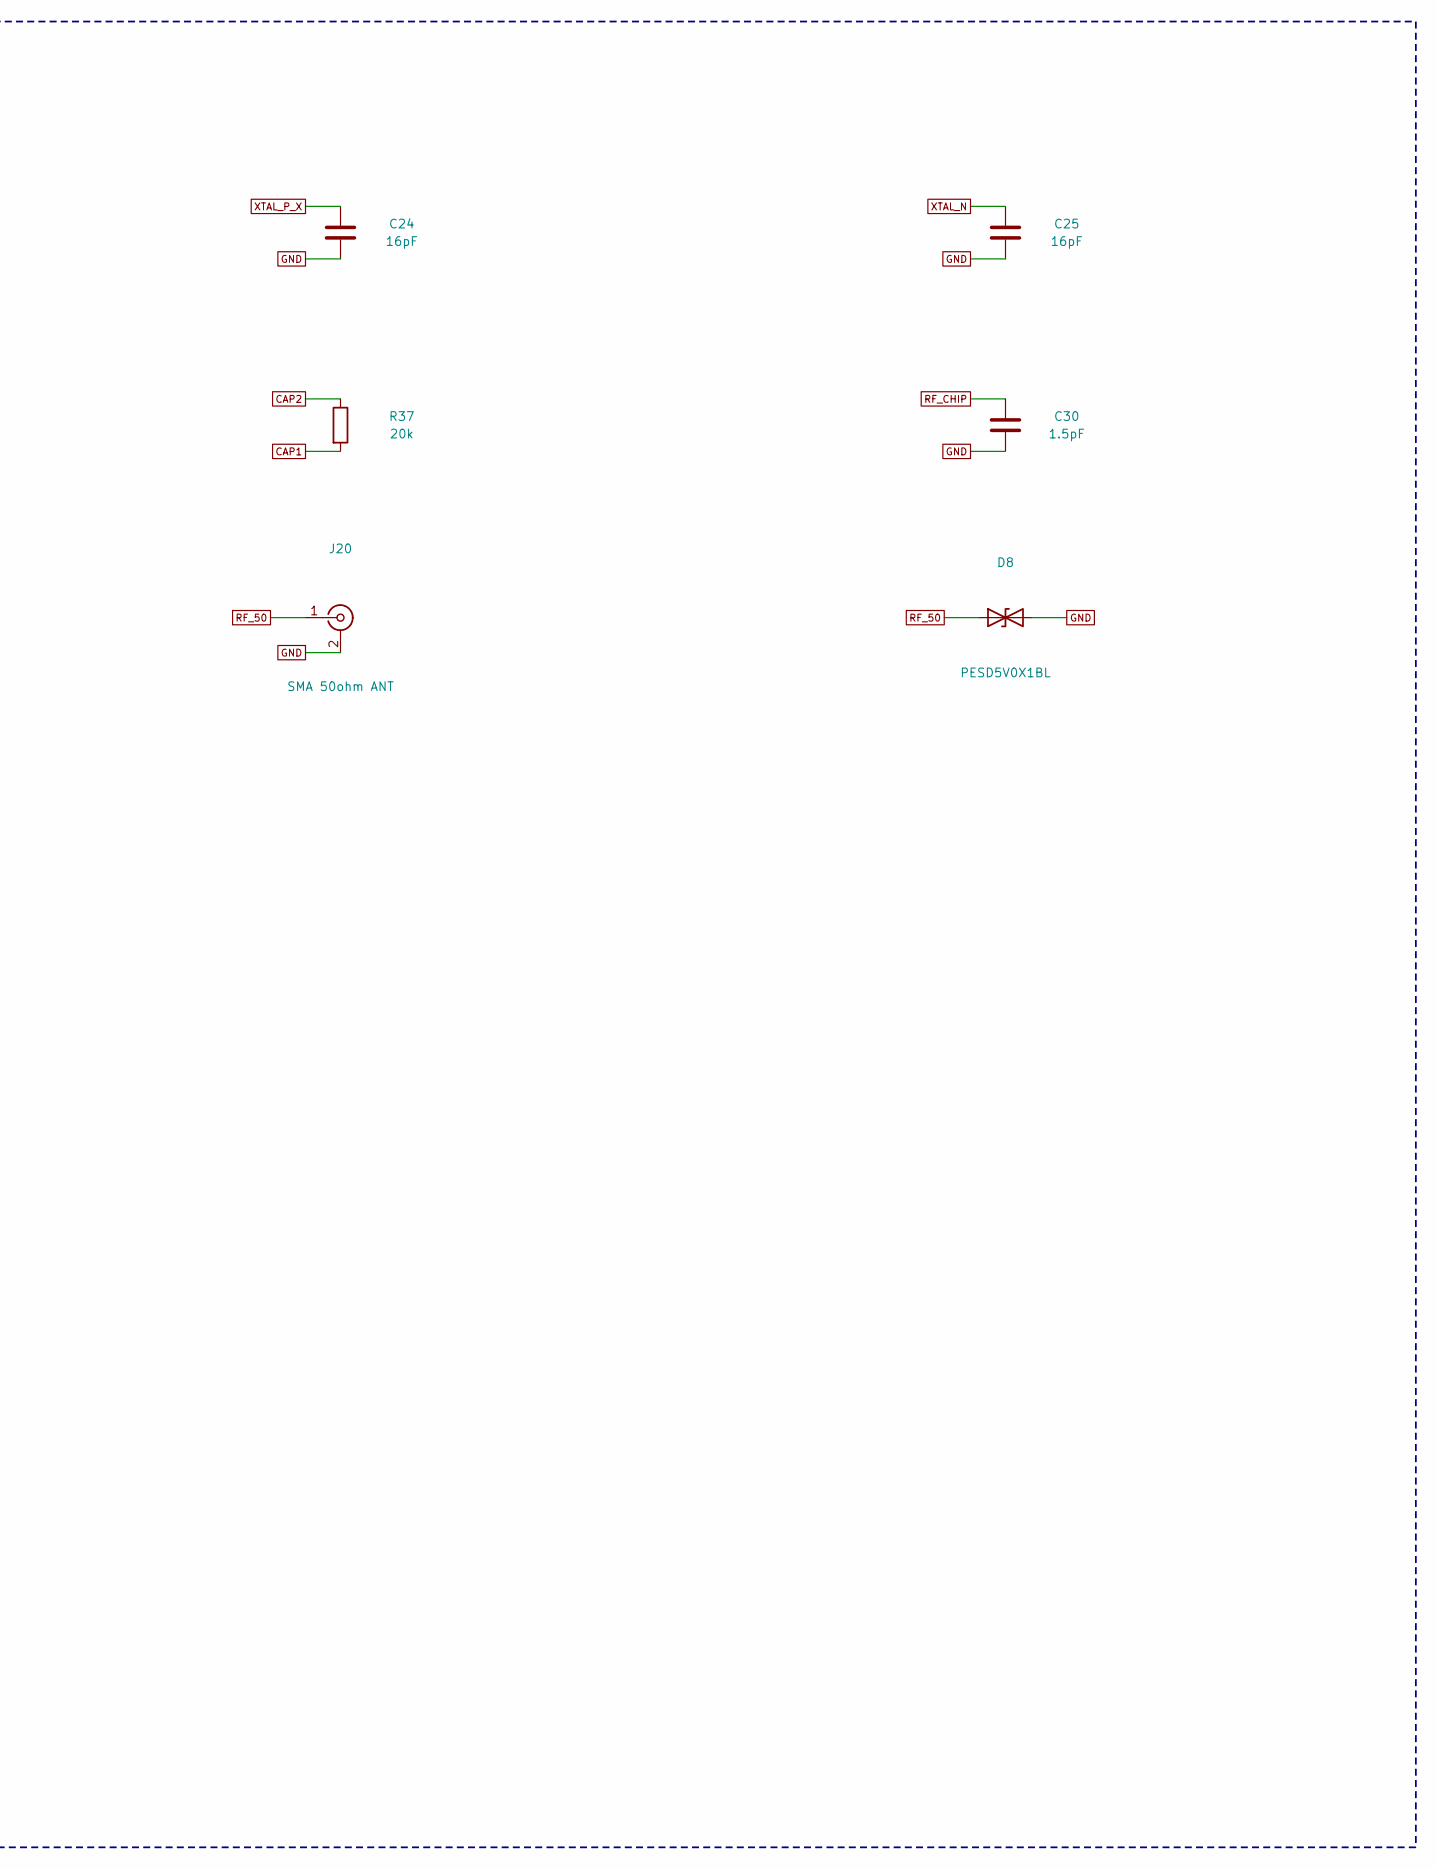
[picture p34: schematic FV-CTRL_RevB-03.kicad_sch, FV-CTRL RevB / Clock / RF, part in row 1, column 2]

Parts:
C24, C25: 16pF; C_0402_1005Metric
C26: 10nF; C_0402_1005Metric
C27: 3.3nF; C_0402_1005Metric
C30: 1.5pF; C_0201_0603Metric
C31: 0.5pF; C_0201_0603Metric
D8: PESD5V0X1BL; D_SOD-882
J20: SMA 50ohm ANT; SMA_Amphenol_132134_Vertical
L1: 2.7nH; L_0201_0603Metric
R36: 0R; R_0402_1005Metric
R37: 20k; R_0402_1005Metric
Y1: 40MHz CL10pF; Crystal_SMD_3225-4Pin_3.2x2.5mm

Connections:
CAP1: C26.1, C27.2, R37.2; also elsewhere on the board
CAP2: C27.1, R37.1; also elsewhere on the board
GND: C24.2, C25.2, C26.2, C30.2, C31.2, D8.2 (A2), J20.2 (Ext), Y1.2 (G), Y1.4 (G); also elsewhere on the board
RF_50: C31.1, D8.1 (A1), J20.1 (In), L1.2
RF_CHIP: C30.1, L1.1; also elsewhere on the board
XTAL_N: C25.1, Y1.3; also elsewhere on the board
XTAL_P: R36.1; also elsewhere on the board
XTAL_P_X: C24.1, R36.2, Y1.1

Notes on the sheet:
Clock / RF
Same global net name = electrical connection across all pages
