Masterltb/pcb/hardware/revb/FV-CTRL_RevB.kicad_pcb

## KiCad design hardware/revb/FV-CTRL_RevB.kicad_pcb (continued)

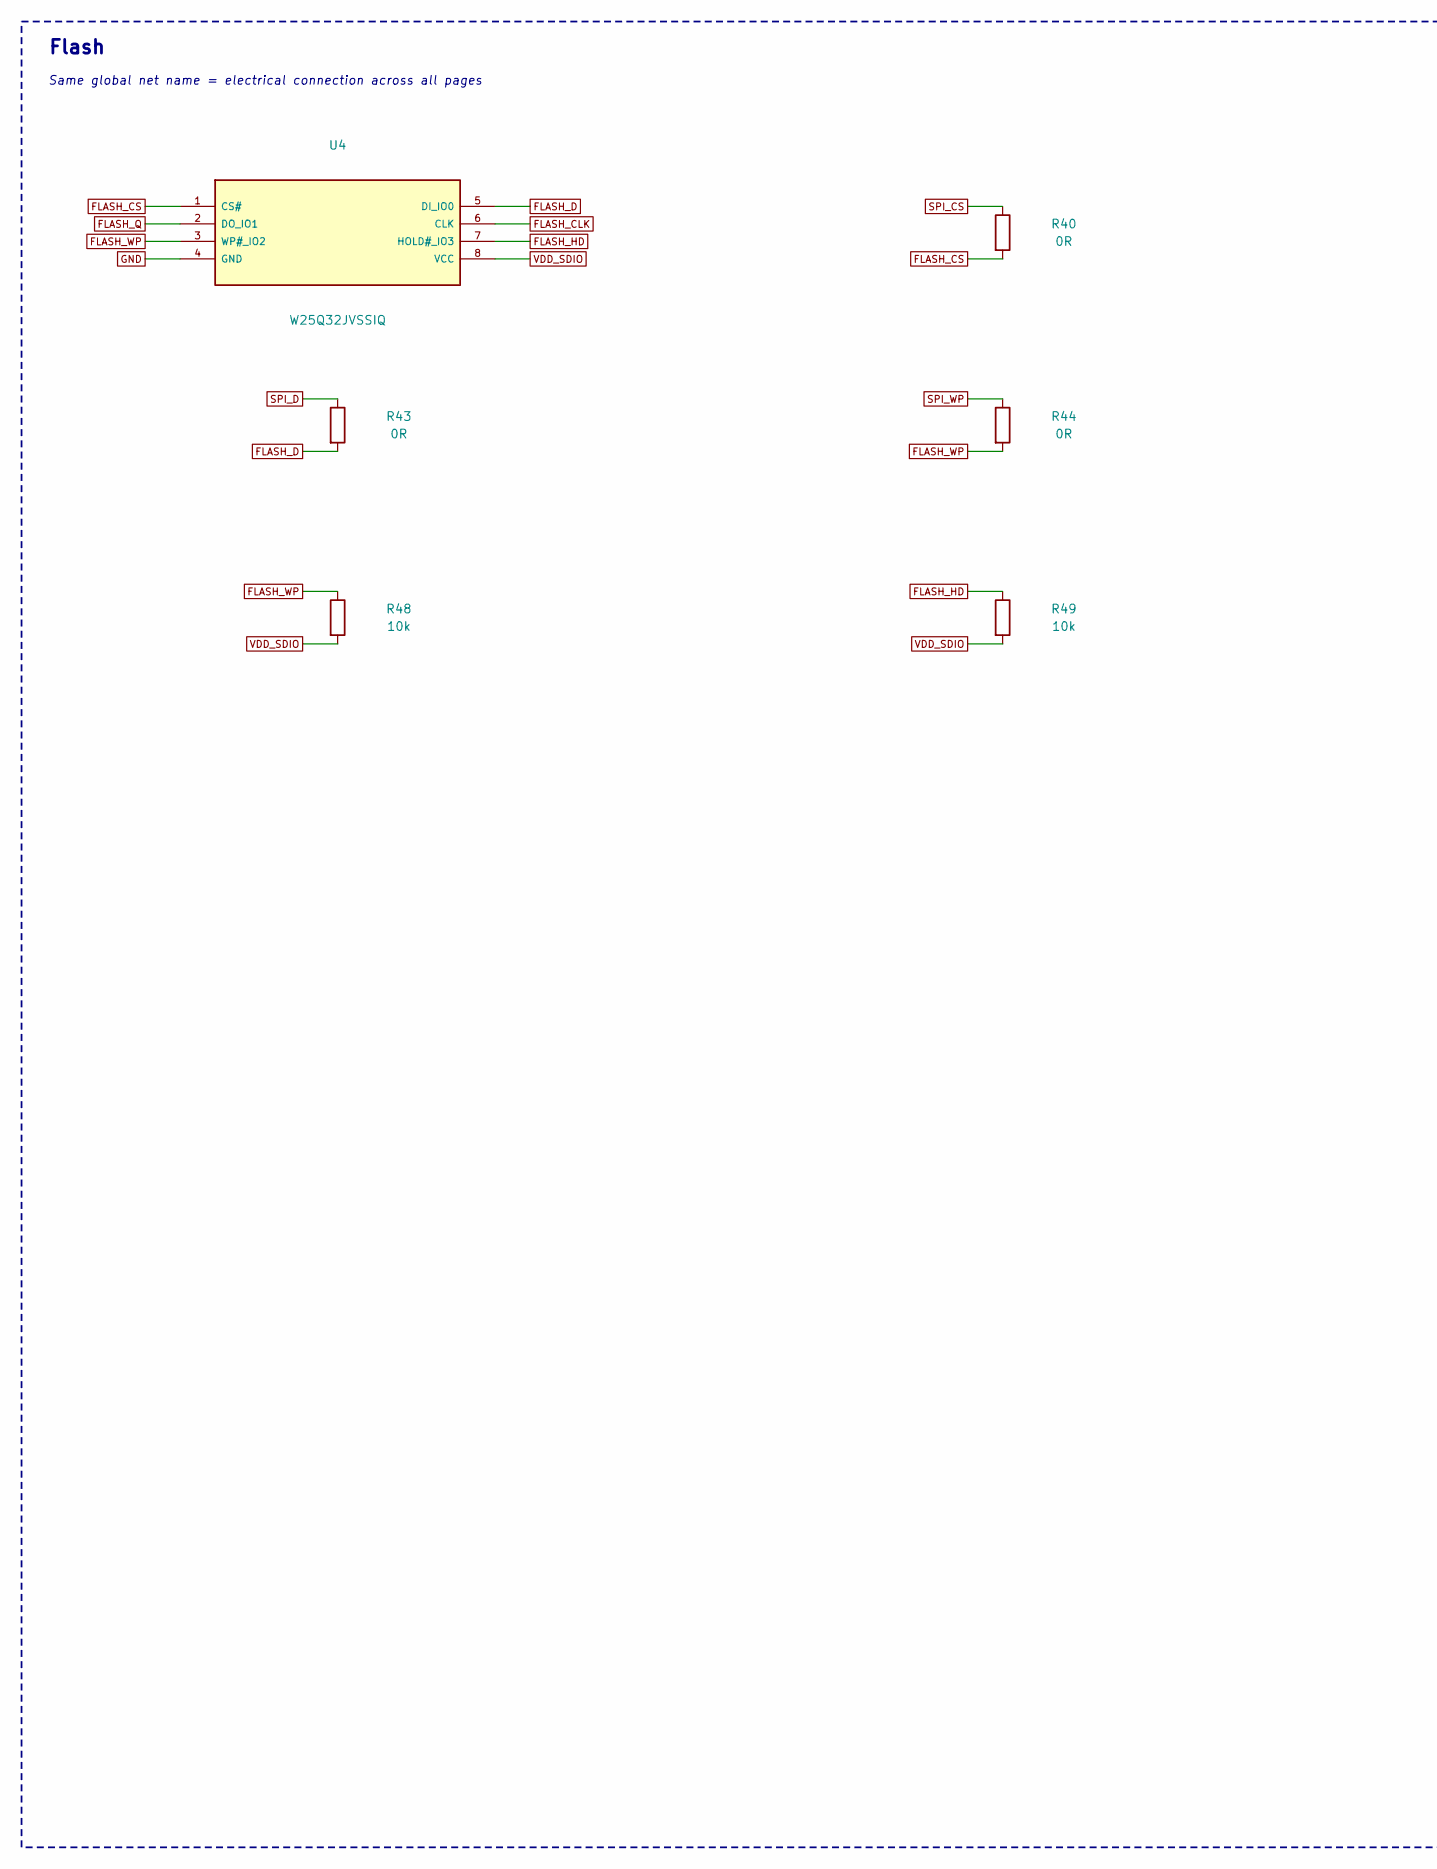
[picture p35: schematic FV-CTRL_RevB-04.kicad_sch, FV-CTRL RevB / Flash, part in row 1, column 1]

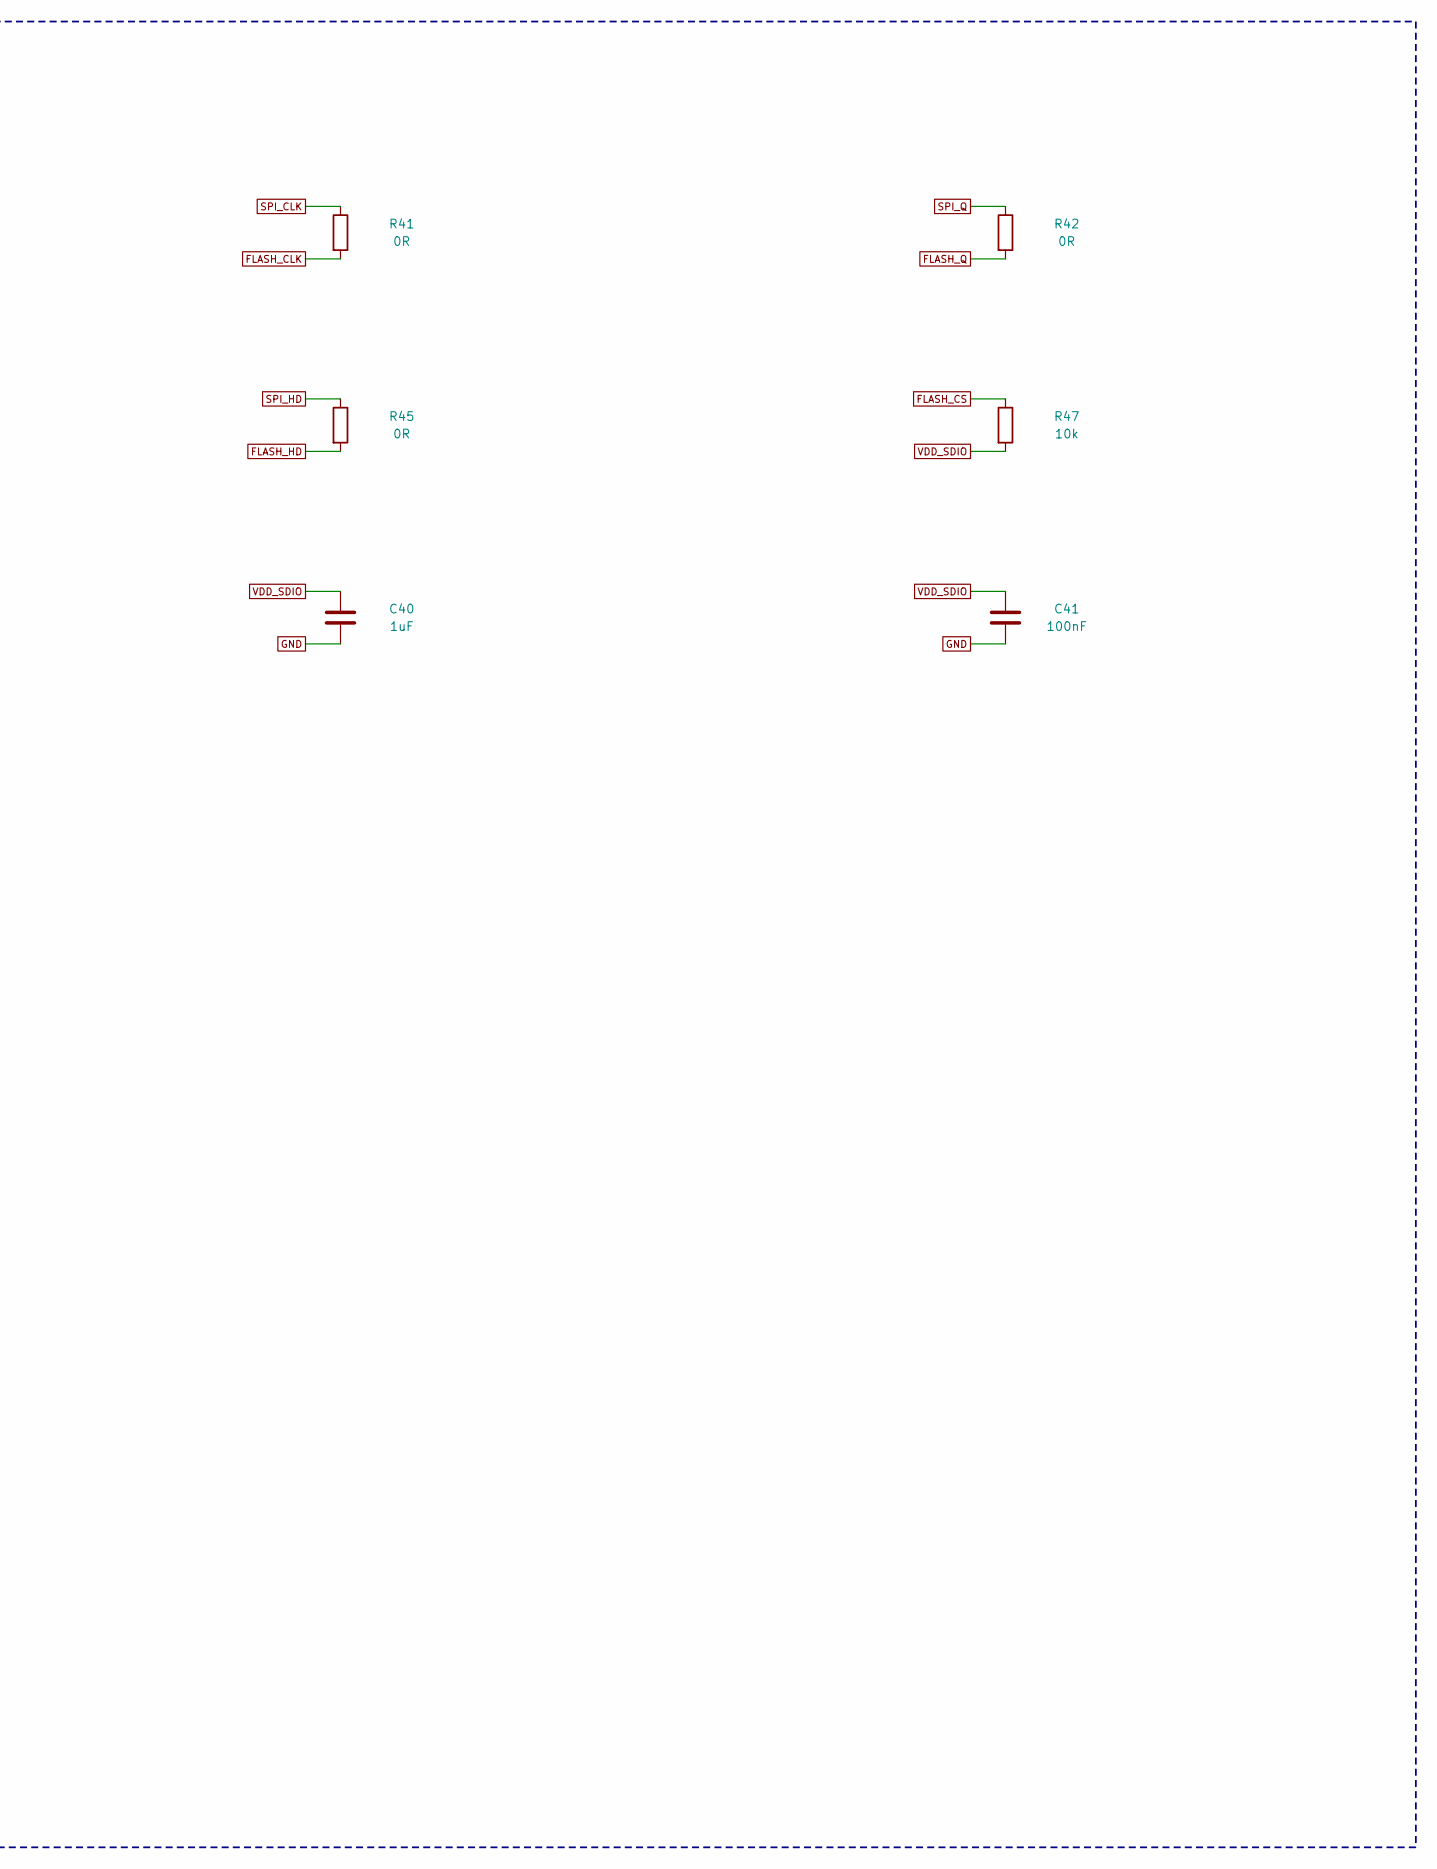
[picture p36: schematic FV-CTRL_RevB-04.kicad_sch, FV-CTRL RevB / Flash, part in row 1, column 2]

Parts:
C40: 1uF; C_0402_1005Metric
C41: 100nF; C_0402_1005Metric
R40, R41, R42, R43, R44, R45: 0R; R_0402_1005Metric
R47, R48, R49: 10k; R_0402_1005Metric
U4: W25Q32JVSSIQ; SOIC-8_5.3x5.3mm_P1.27mm

Connections:
FLASH_CLK: R41.2, U4.6 (CLK)
FLASH_CS: R40.2, R47.1, U4.1 (CS#)
FLASH_D: R43.2, U4.5 (DI_IO0)
FLASH_HD: R45.2, R49.1, U4.7 (HOLD#_IO3)
FLASH_Q: R42.2, U4.2 (DO_IO1)
FLASH_WP: R44.2, R48.1, U4.3 (WP#_IO2)
GND: C40.2, C41.2, U4.4 (GND); also elsewhere on the board
SPI_CLK: R41.1; also elsewhere on the board
SPI_CS: R40.1; also elsewhere on the board
SPI_D: R43.1; also elsewhere on the board
SPI_HD: R45.1; also elsewhere on the board
SPI_Q: R42.1; also elsewhere on the board
SPI_WP: R44.1; also elsewhere on the board
VDD_SDIO: C40.1, C41.1, R47.2, R48.2, R49.2, U4.8 (VCC); also elsewhere on the board

Notes on the sheet:
Flash
Same global net name = electrical connection across all pages

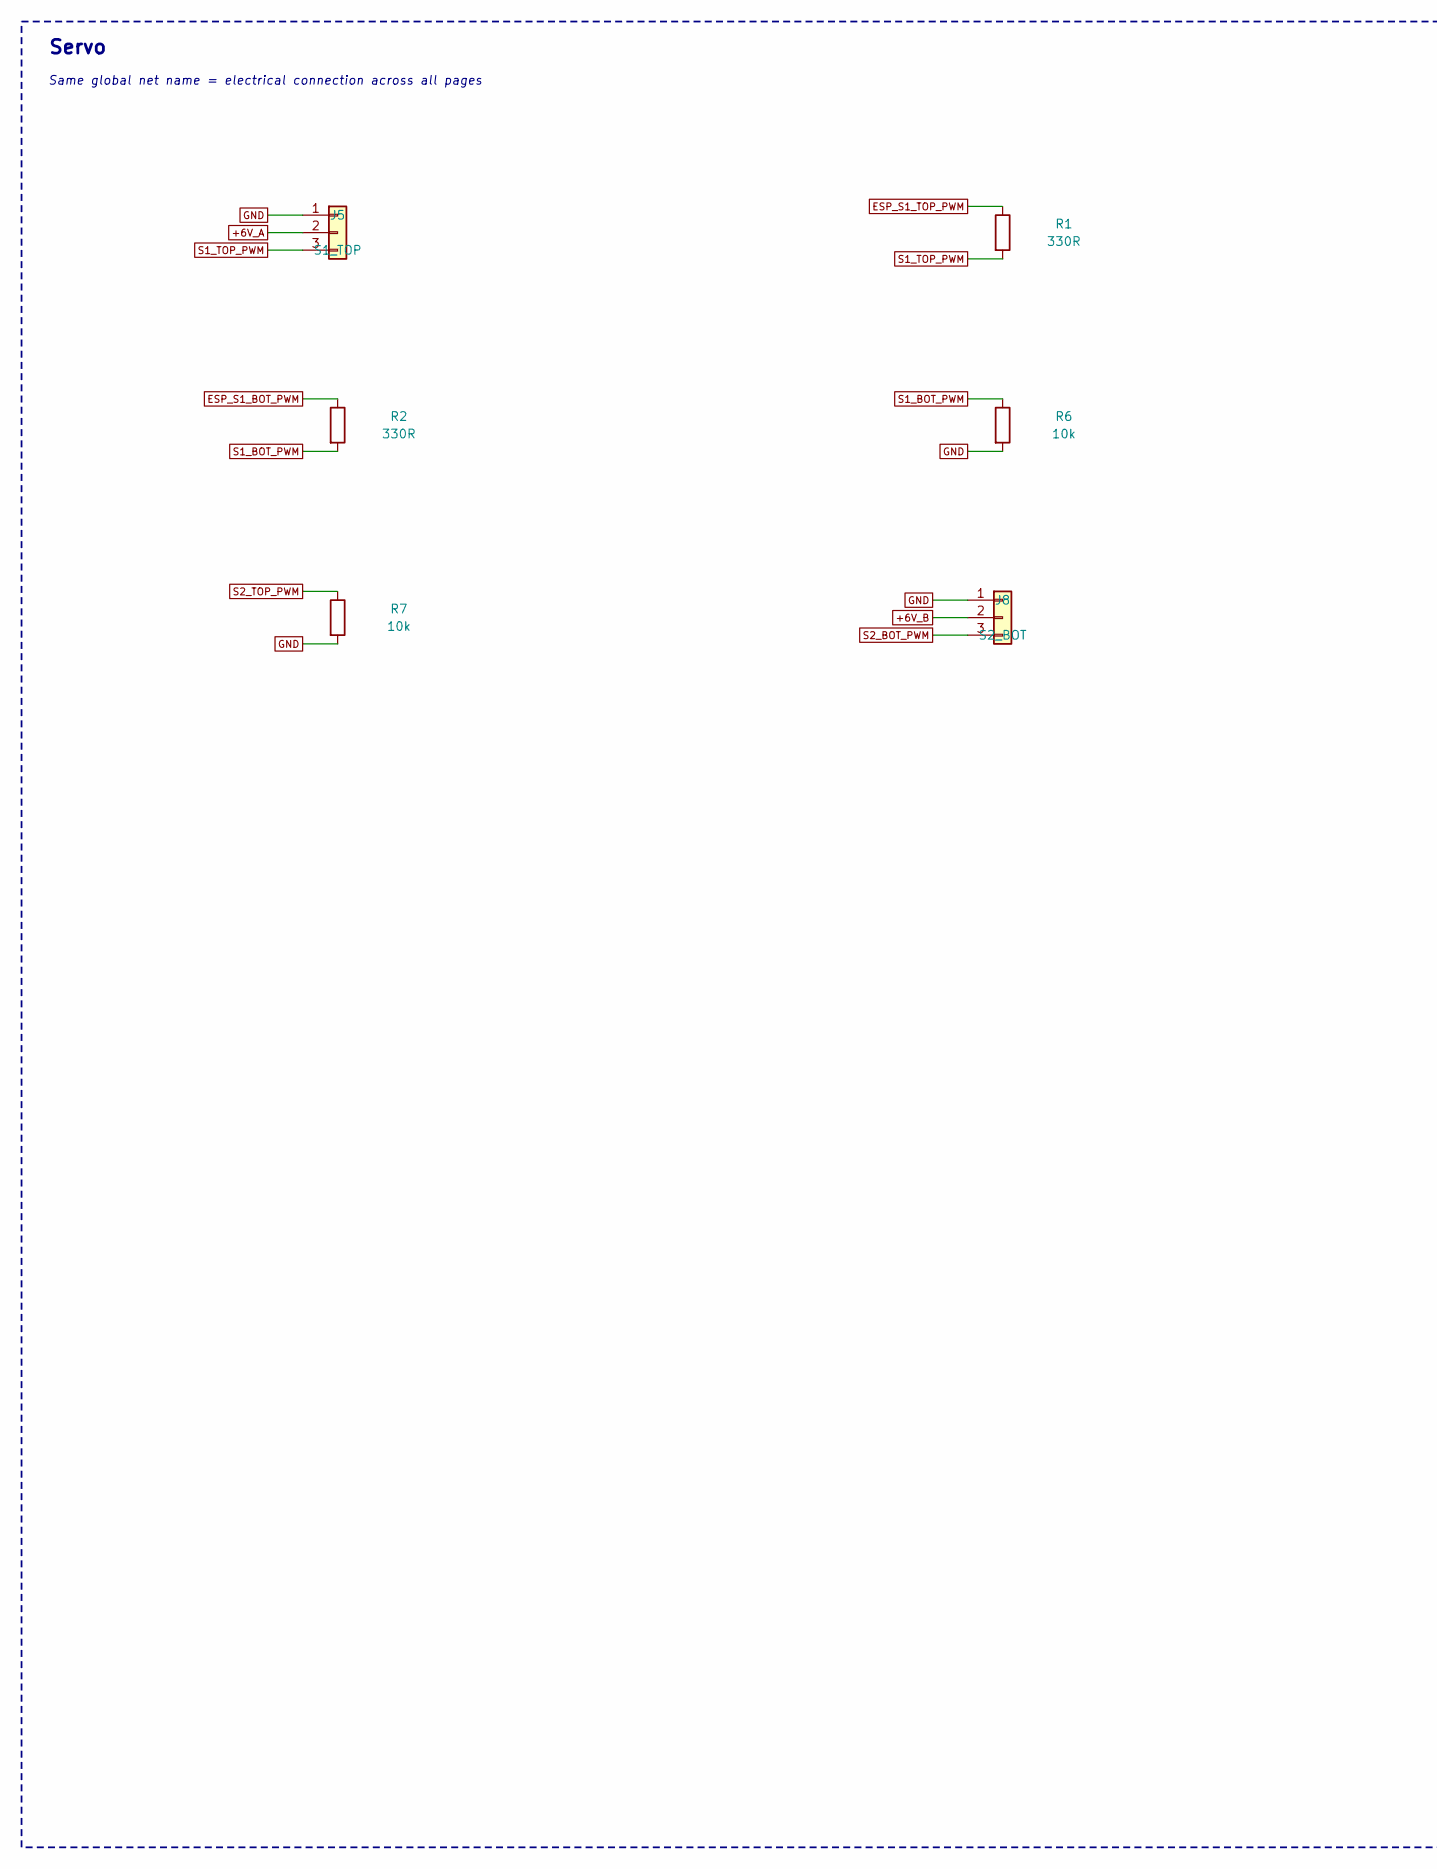
[picture p37: schematic FV-CTRL_RevB-05.kicad_sch, FV-CTRL RevB / Servo, part in row 1, column 1]

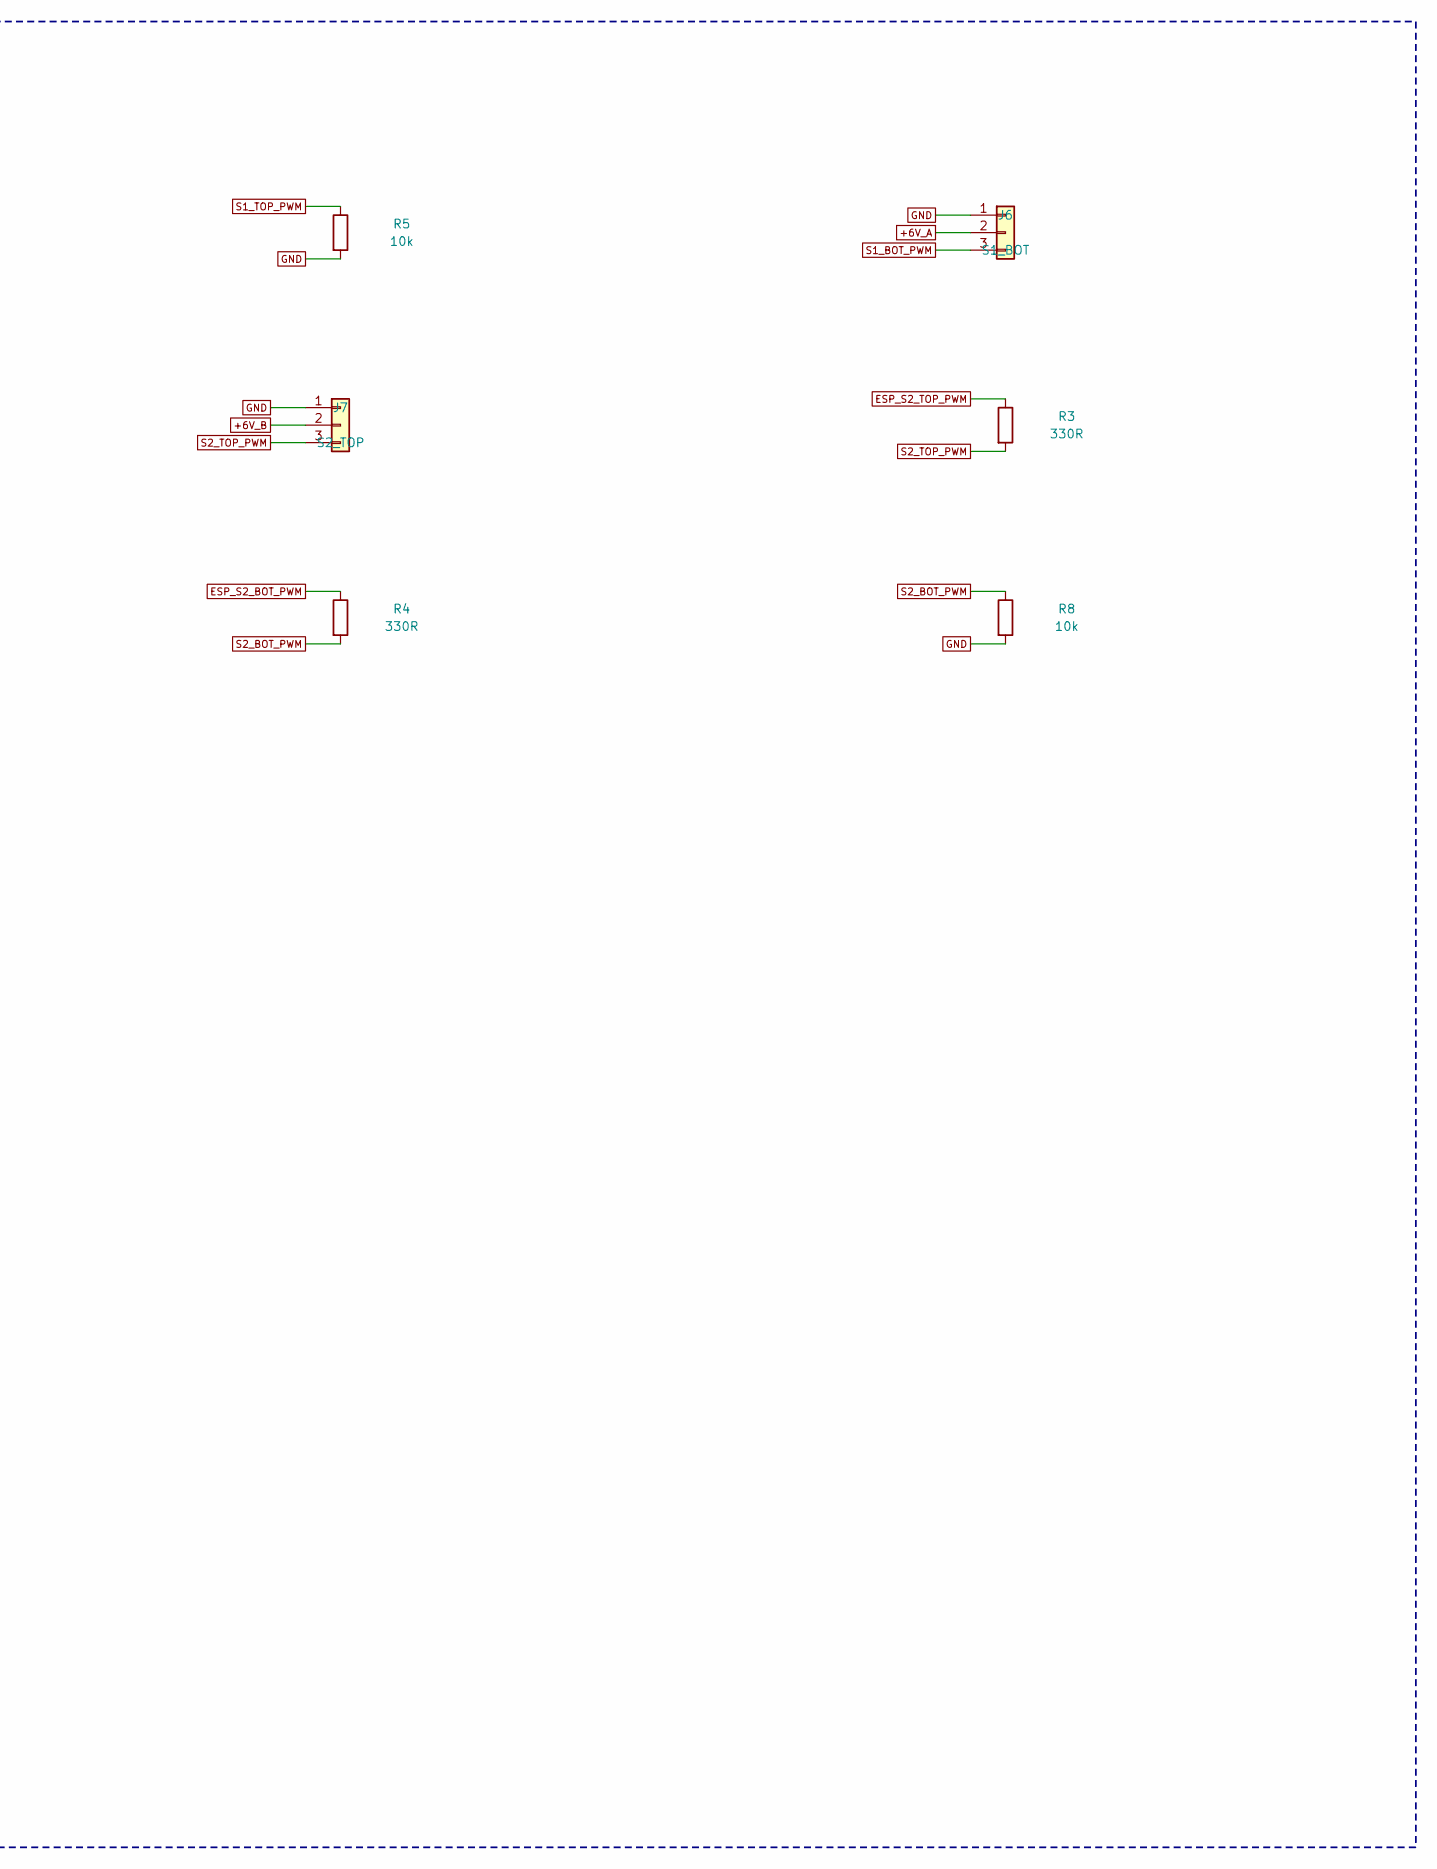
[picture p38: schematic FV-CTRL_RevB-05.kicad_sch, FV-CTRL RevB / Servo, part in row 1, column 2]

Parts:
J5: S1_TOP; PinHeader_1x03_P2.54mm_Vertical
J6: S1_BOT; PinHeader_1x03_P2.54mm_Vertical
J7: S2_TOP; PinHeader_1x03_P2.54mm_Vertical
J8: S2_BOT; PinHeader_1x03_P2.54mm_Vertical
R1, R2, R3, R4: 330R; R_Axial_DIN0207_L6.3mm_D2.5mm_P7.62mm_Horizontal
R5, R6, R7, R8: 10k; R_Axial_DIN0207_L6.3mm_D2.5mm_P7.62mm_Horizontal

Connections:
+6V_A: J5.2, J6.2; also elsewhere on the board
+6V_B: J7.2, J8.2; also elsewhere on the board
ESP_S1_BOT_PWM: R2.1; also elsewhere on the board
ESP_S1_TOP_PWM: R1.1; also elsewhere on the board
ESP_S2_BOT_PWM: R4.1; also elsewhere on the board
ESP_S2_TOP_PWM: R3.1; also elsewhere on the board
GND: J5.1, J6.1, J7.1, J8.1, R5.2, R6.2, R7.2, R8.2; also elsewhere on the board
S1_BOT_PWM: J6.3, R2.2, R6.1
S1_TOP_PWM: J5.3, R1.2, R5.1
S2_BOT_PWM: J8.3, R4.2, R8.1
S2_TOP_PWM: J7.3, R3.2, R7.1

Notes on the sheet:
Servo
Same global net name = electrical connection across all pages

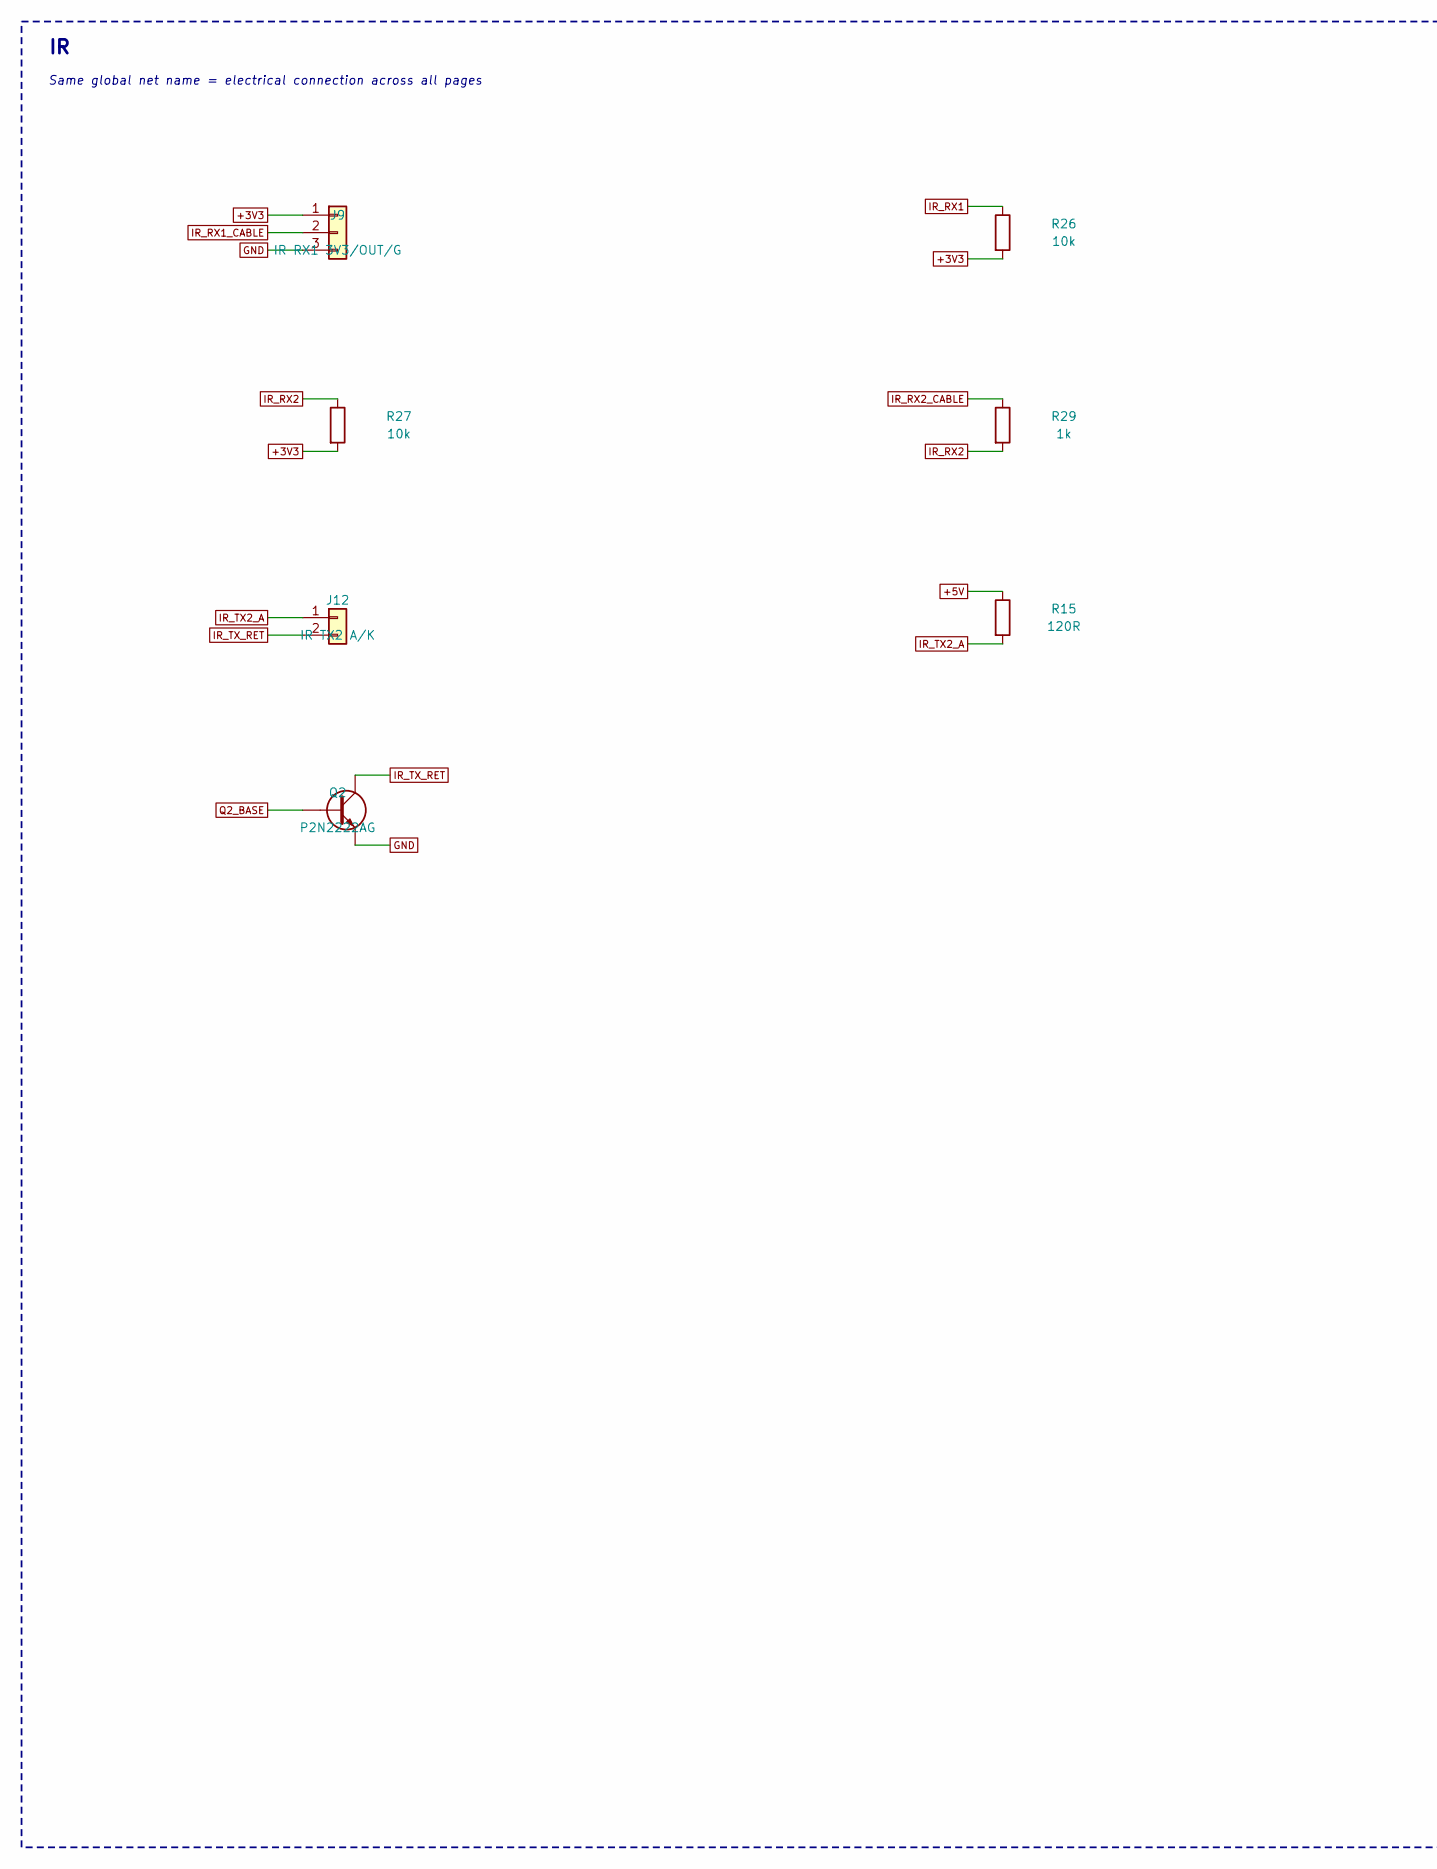
[picture p39: schematic FV-CTRL_RevB-06.kicad_sch, FV-CTRL RevB / IR, part in row 1, column 1]

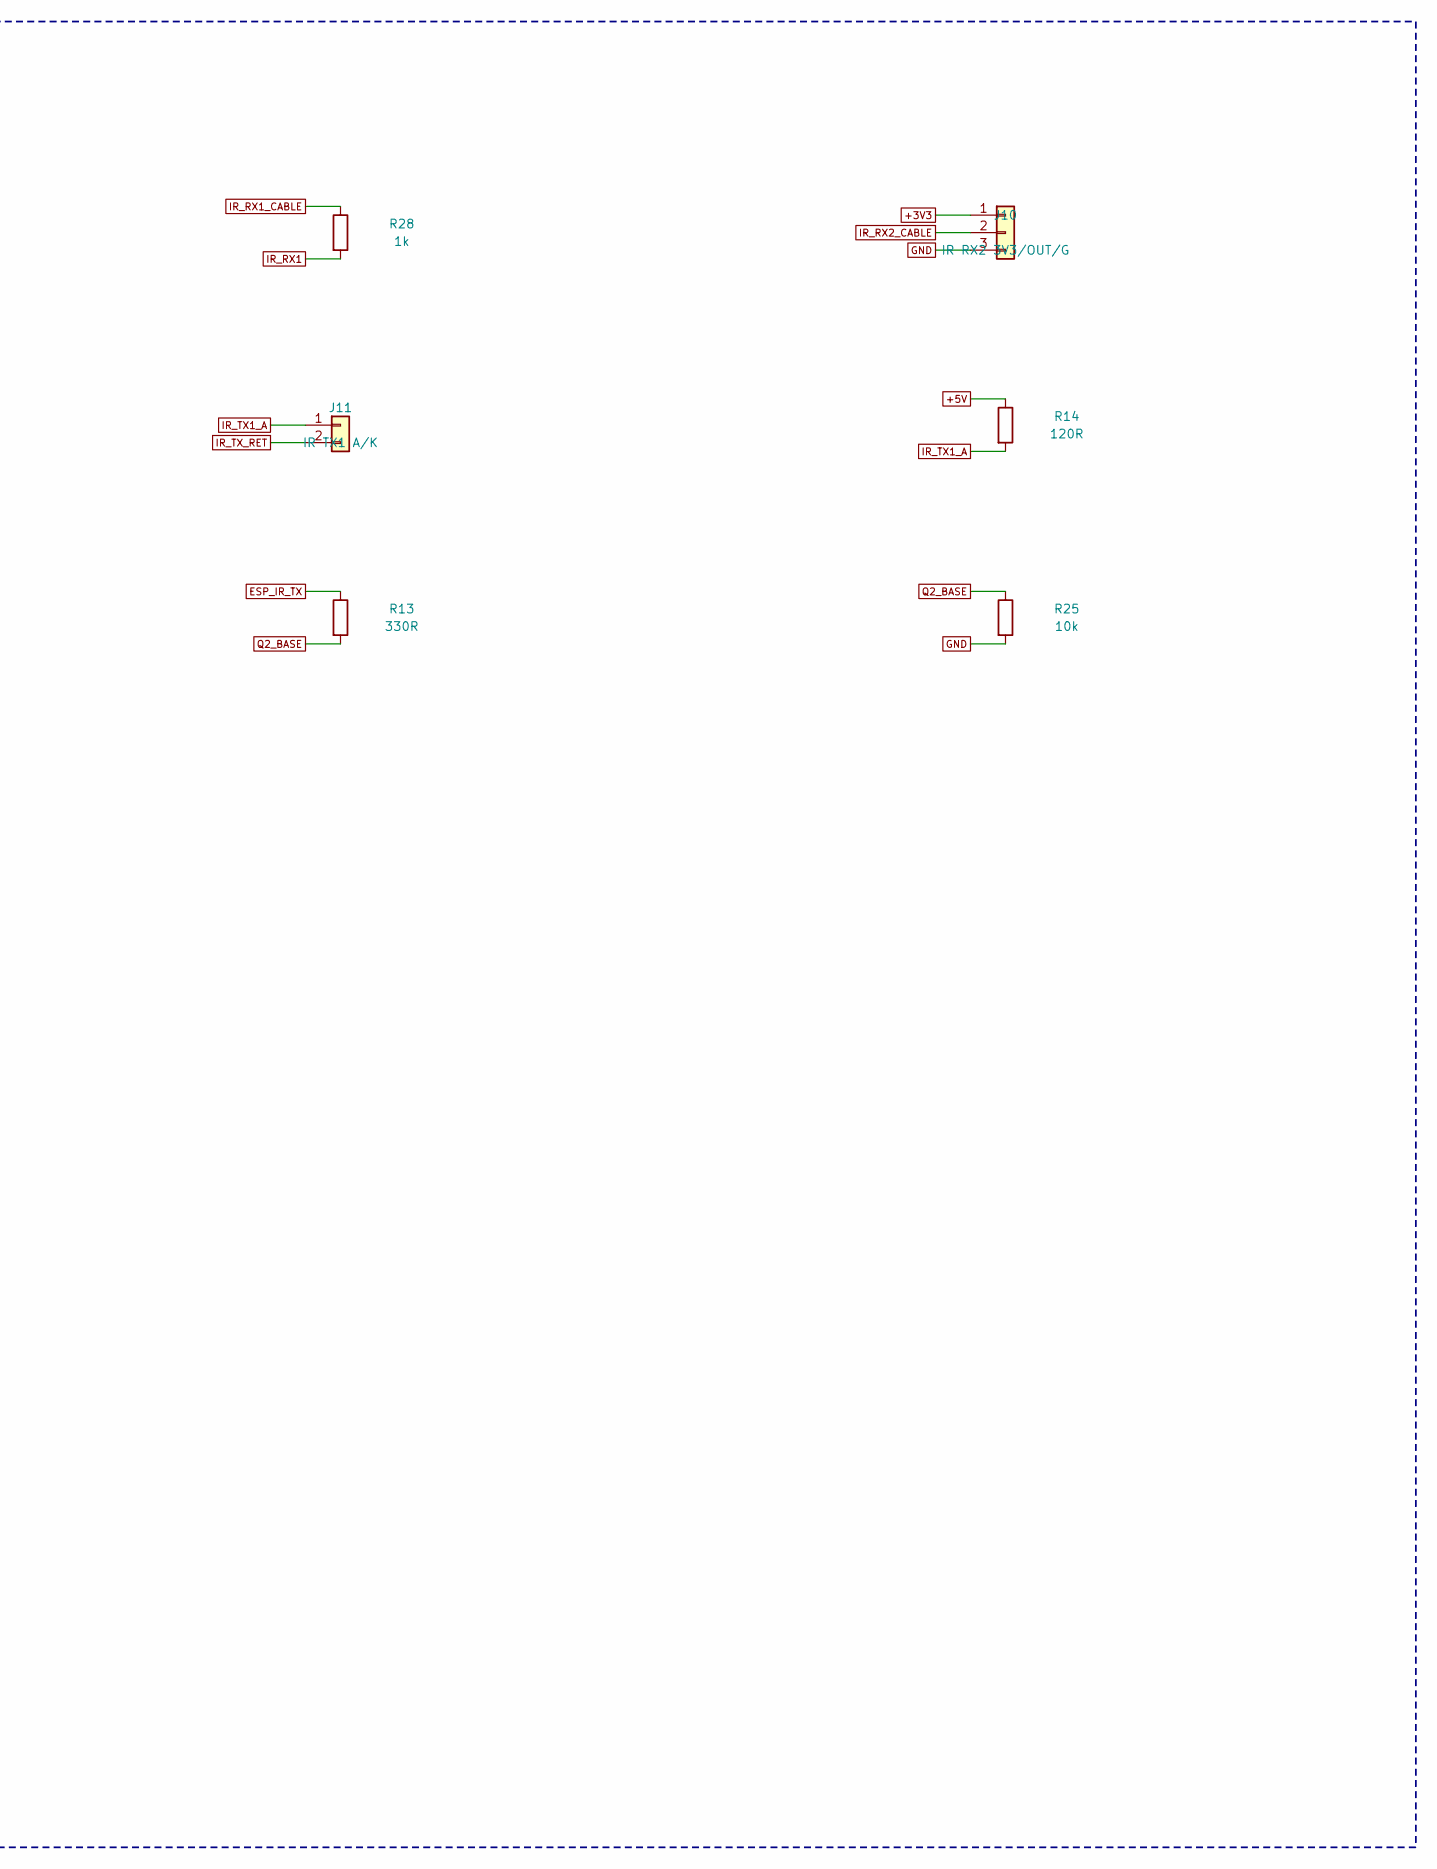
[picture p40: schematic FV-CTRL_RevB-06.kicad_sch, FV-CTRL RevB / IR, part in row 1, column 2]

Parts:
J9: IR RX1 3V3/OUT/G; JST_XH_B3B-XH-A_1x03_P2.50mm_Vertical
J10: IR RX2 3V3/OUT/G; JST_XH_B3B-XH-A_1x03_P2.50mm_Vertical
J11: IR TX1 A/K; JST_XH_B2B-XH-A_1x02_P2.50mm_Vertical
J12: IR TX2 A/K; JST_XH_B2B-XH-A_1x02_P2.50mm_Vertical
Q2: P2N2222AG; NPN_CBE
R13: 330R; R_Axial_DIN0207_L6.3mm_D2.5mm_P7.62mm_Horizontal
R14, R15: 120R; R_Axial_DIN0207_L6.3mm_D2.5mm_P7.62mm_Horizontal
R25, R26, R27: 10k; R_Axial_DIN0207_L6.3mm_D2.5mm_P7.62mm_Horizontal
R28, R29: 1k; R_Axial_DIN0207_L6.3mm_D2.5mm_P7.62mm_Horizontal

Connections:
+3V3: J9.1, J10.1, R26.2, R27.2; also elsewhere on the board
+5V: R14.1, R15.1; also elsewhere on the board
ESP_IR_TX: R13.1; also elsewhere on the board
GND: J9.3, J10.3, Q2.E, R25.2; also elsewhere on the board
IR_RX1: R26.1, R28.2; also elsewhere on the board
IR_RX1_CABLE: J9.2, R28.1
IR_RX2: R27.1, R29.2; also elsewhere on the board
IR_RX2_CABLE: J10.2, R29.1
IR_TX1_A: J11.1, R14.2
IR_TX2_A: J12.1, R15.2
IR_TX_RET: J11.2, J12.2, Q2.C
Q2_BASE: Q2.B, R13.2, R25.1

Notes on the sheet:
Same global net name = electrical connection across all pages
