Masterltb/pcb/hardware/revb/FV-CTRL_RevB.kicad_pcb

## KiCad design hardware/revb/FV-CTRL_RevB.kicad_pcb (continued)

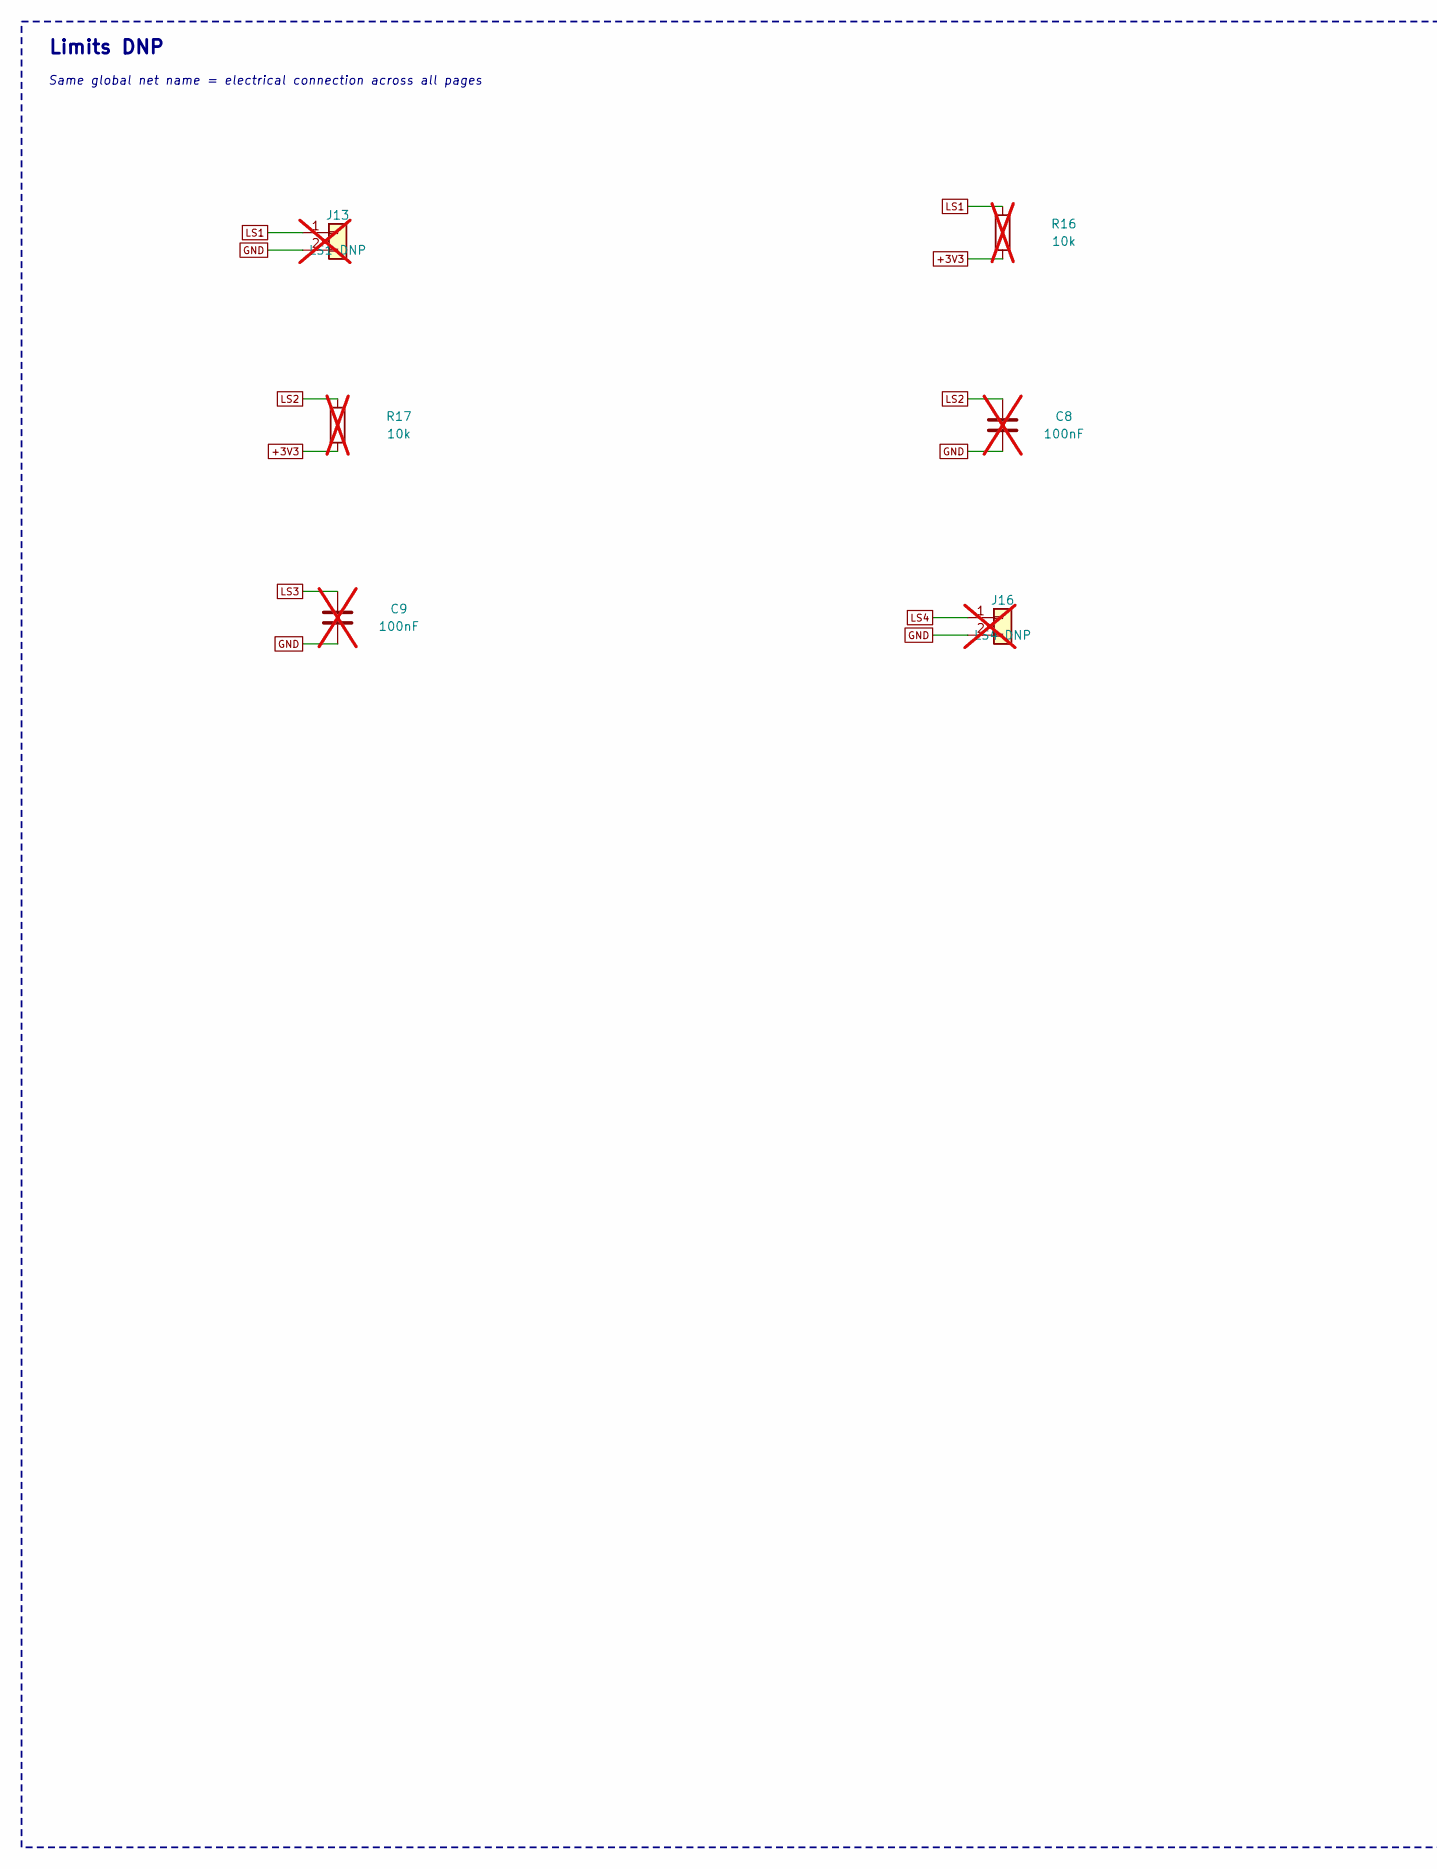
[picture p41: schematic FV-CTRL_RevB-07.kicad_sch, FV-CTRL RevB / Limits DNP, part in row 1, column 1]

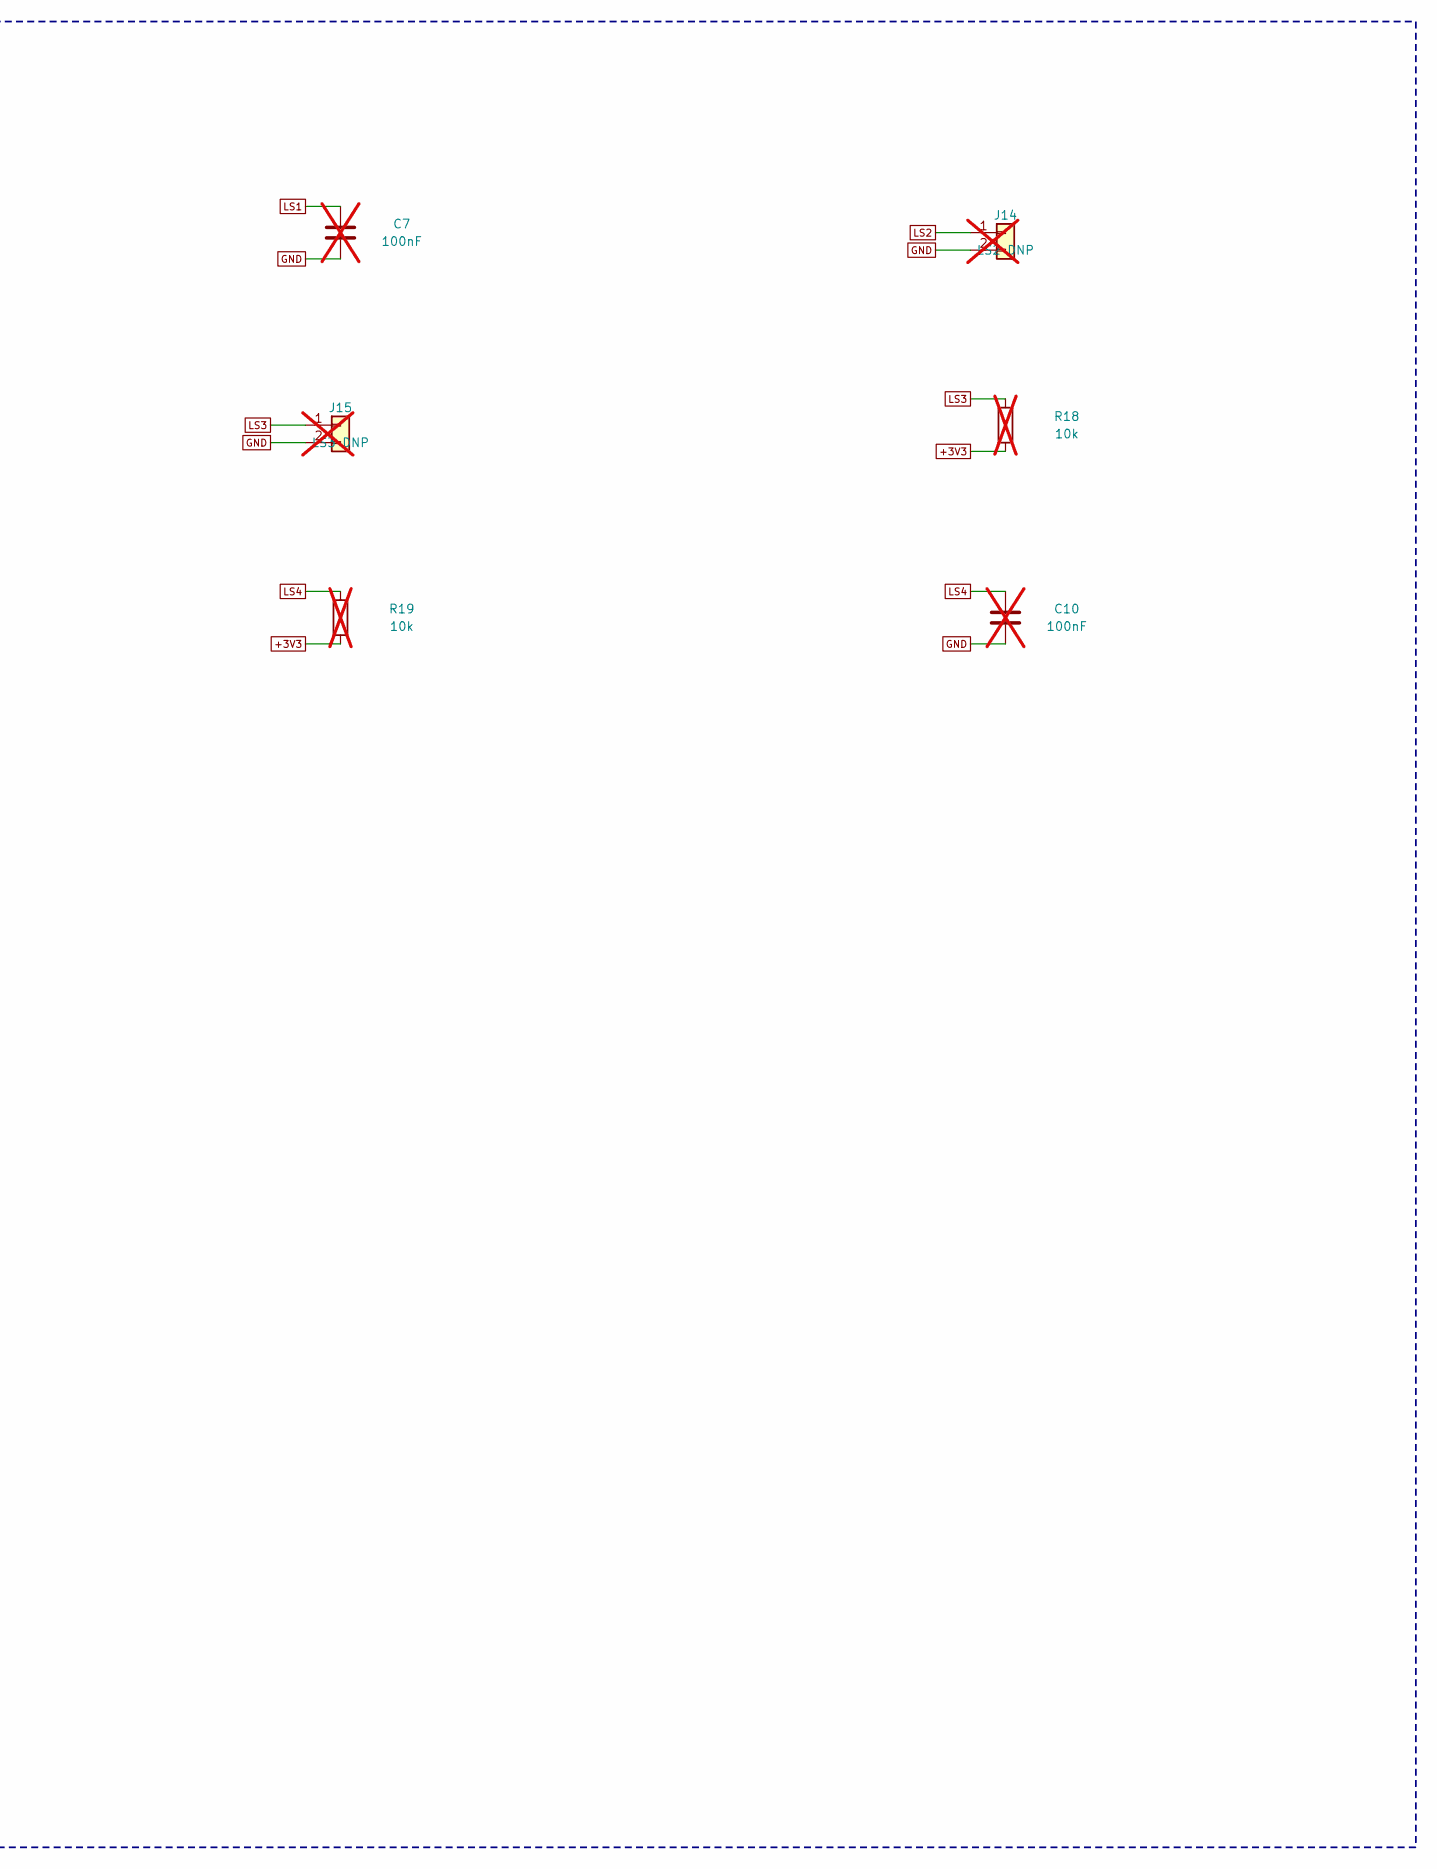
[picture p42: schematic FV-CTRL_RevB-07.kicad_sch, FV-CTRL RevB / Limits DNP, part in row 1, column 2]

Parts:
C7, C8, C9, C10: 100nF; C_Disc_D5.0mm_W2.5mm_P5.00mm; not fitted
J13: LS1 DNP; JST_XH_B2B-XH-A_1x02_P2.50mm_Vertical; not fitted
J14: LS2 DNP; JST_XH_B2B-XH-A_1x02_P2.50mm_Vertical; not fitted
J15: LS3 DNP; JST_XH_B2B-XH-A_1x02_P2.50mm_Vertical; not fitted
J16: LS4 DNP; JST_XH_B2B-XH-A_1x02_P2.50mm_Vertical; not fitted
R16, R17, R18, R19: 10k; R_Axial_DIN0207_L6.3mm_D2.5mm_P7.62mm_Horizontal; not fitted

Connections:
+3V3: R16.2, R17.2, R18.2, R19.2; also elsewhere on the board
GND: C7.2, C8.2, C9.2, C10.2, J13.2, J14.2, J15.2, J16.2; also elsewhere on the board
LS1: C7.1, J13.1, R16.1; also elsewhere on the board
LS2: C8.1, J14.1, R17.1; also elsewhere on the board
LS3: C9.1, J15.1, R18.1; also elsewhere on the board
LS4: C10.1, J16.1, R19.1; also elsewhere on the board

Notes on the sheet:
Limits DNP
Same global net name = electrical connection across all pages

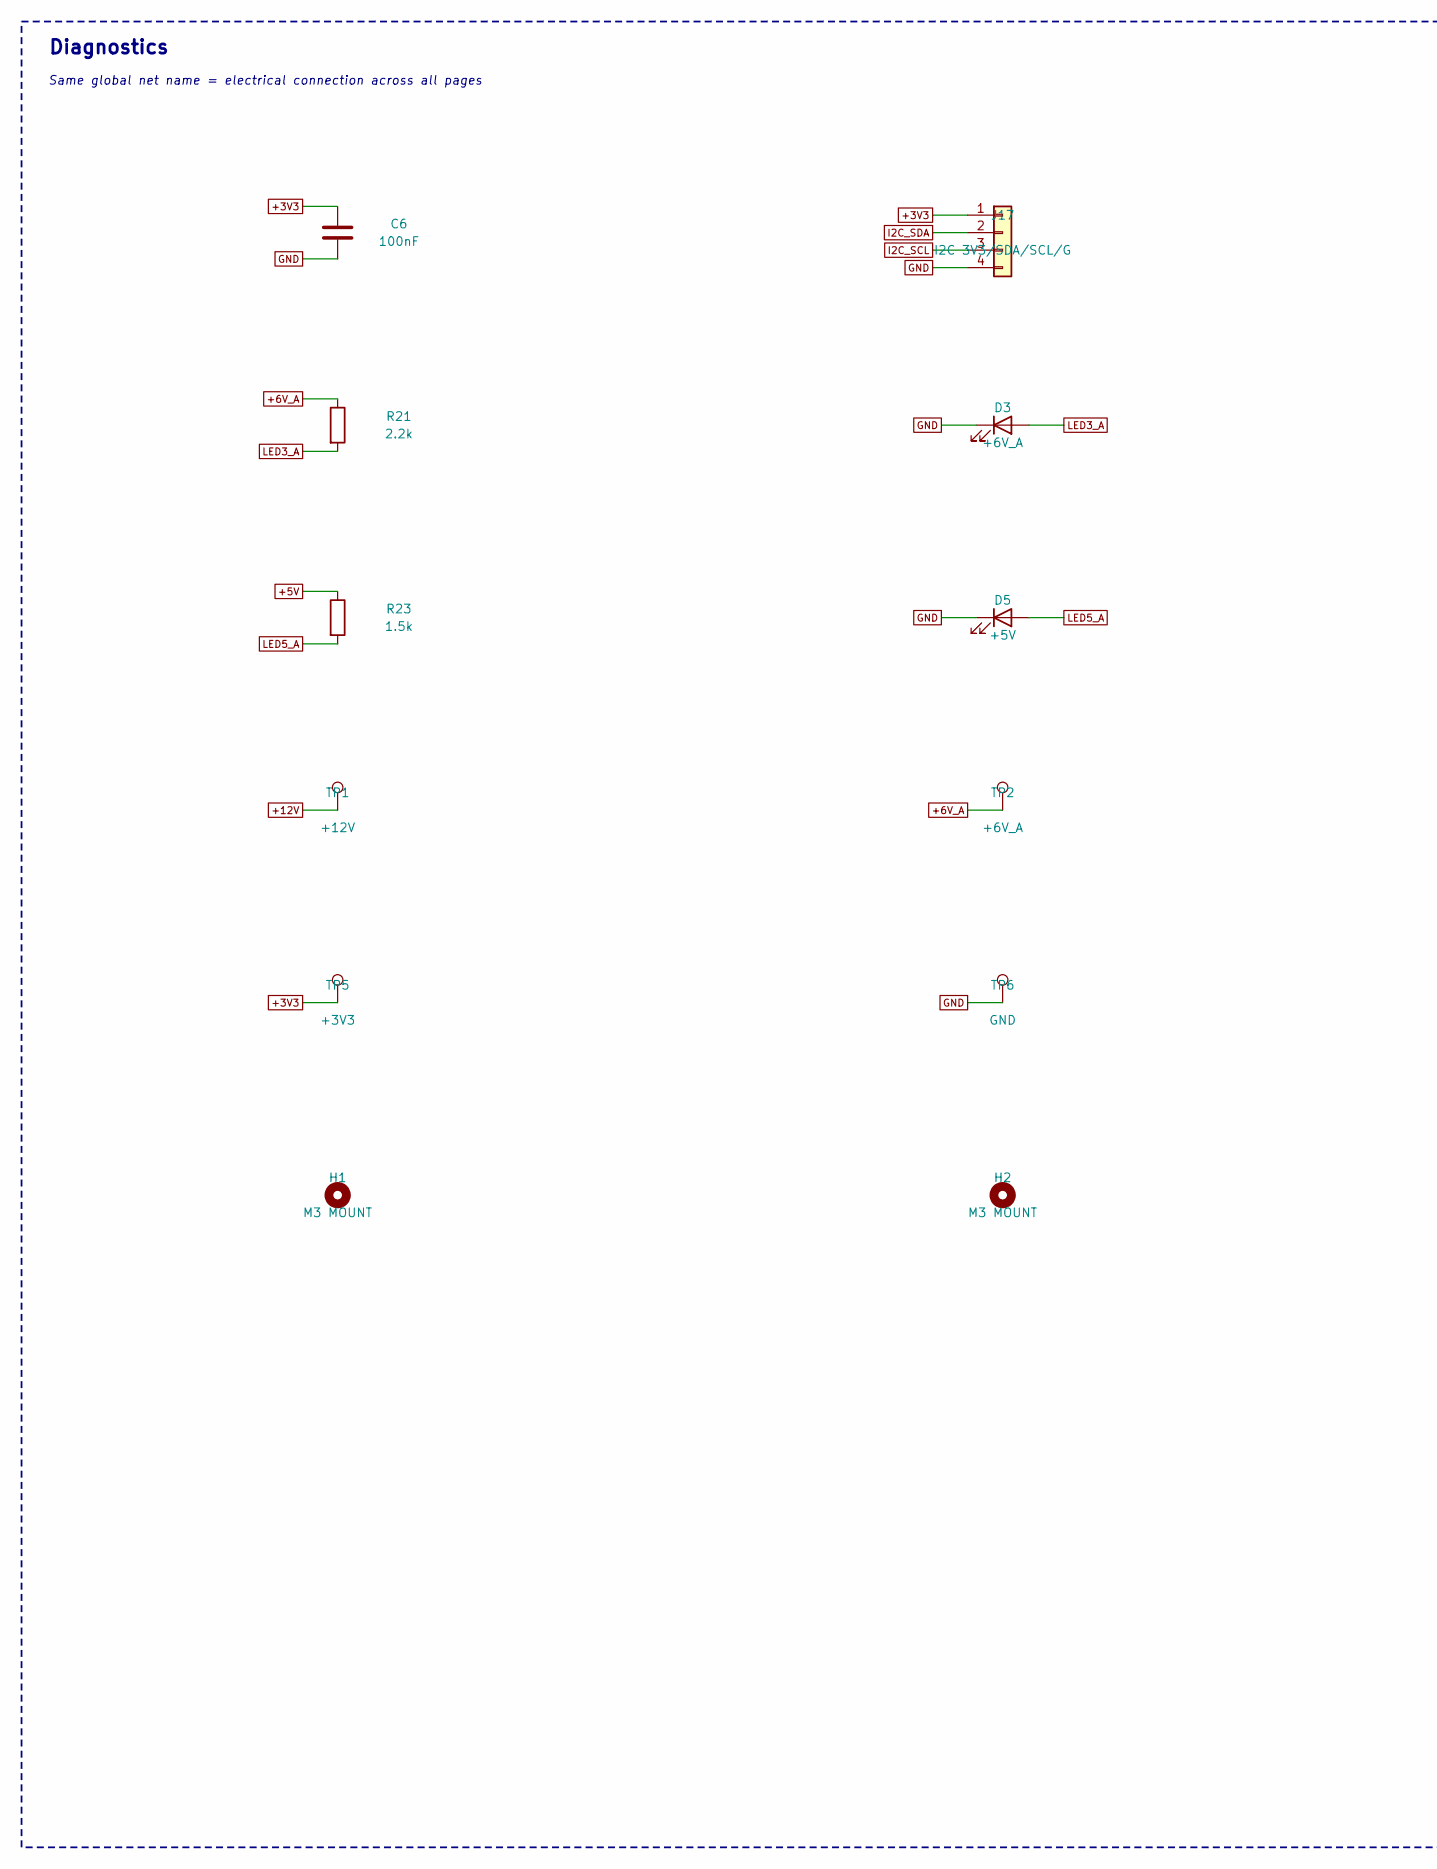
[picture p43: schematic FV-CTRL_RevB-08.kicad_sch, FV-CTRL RevB / Diagnostics, part in row 1, column 1]

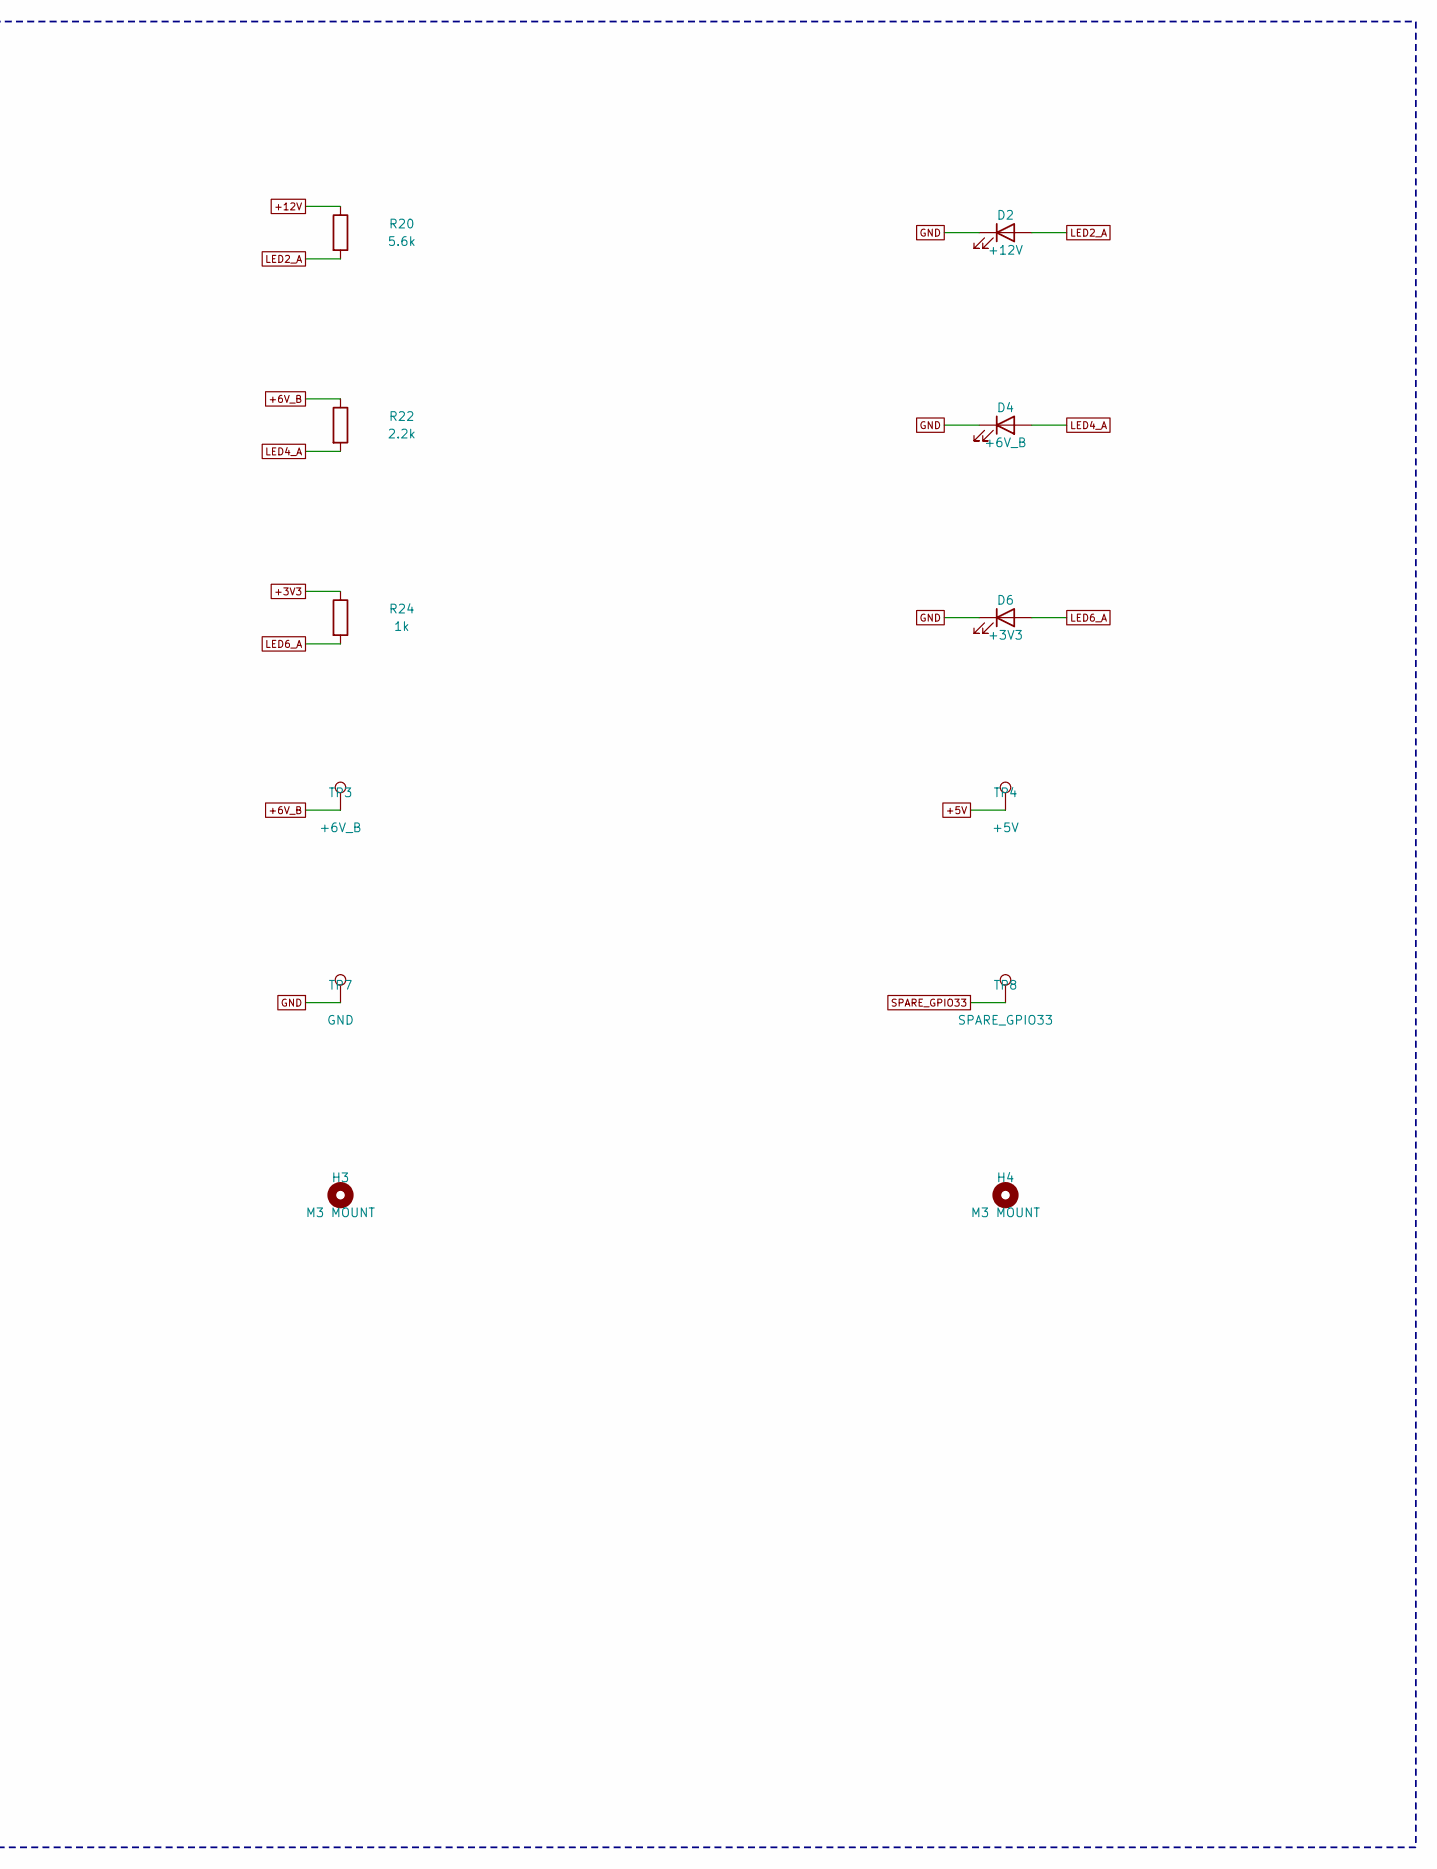
[picture p44: schematic FV-CTRL_RevB-08.kicad_sch, FV-CTRL RevB / Diagnostics, part in row 1, column 2]

Parts:
C6: 100nF; C_Disc_D5.0mm_W2.5mm_P5.00mm
D2: +12V; LED_D3.0mm
D3: +6V_A; LED_D3.0mm
D4: +6V_B; LED_D3.0mm
D5: +5V; LED_D3.0mm
D6: +3V3; LED_D3.0mm
H1, H2, H3, H4: M3 MOUNT; MountingHole_3.2mm_M3
J17: I2C 3V3/SDA/SCL/G; PinHeader_1x04_P2.54mm_Vertical
R20: 5.6k; R_Axial_DIN0207_L6.3mm_D2.5mm_P7.62mm_Horizontal
R21, R22: 2.2k; R_Axial_DIN0207_L6.3mm_D2.5mm_P7.62mm_Horizontal
R23: 1.5k; R_Axial_DIN0207_L6.3mm_D2.5mm_P7.62mm_Horizontal
R24: 1k; R_Axial_DIN0207_L6.3mm_D2.5mm_P7.62mm_Horizontal
TP1: +12V; Keystone_5000_Carrier_D3
TP2: +6V_A; Keystone_5000_Carrier_D3
TP3: +6V_B; Keystone_5000_Carrier_D3
TP4: +5V; Keystone_5000_Carrier_D3
TP5: +3V3; Keystone_5000_Carrier_D3
TP6, TP7: GND; Keystone_5000_Carrier_D3
TP8: SPARE_GPIO33; Keystone_5000_Carrier_D3

Connections:
+3V3: C6.1, J17.1, R24.1, TP5.1; also elsewhere on the board
+5V: R23.1, TP4.1; also elsewhere on the board
+6V_A: R21.1, TP2.1; also elsewhere on the board
+6V_B: R22.1, TP3.1; also elsewhere on the board
+12V: R20.1, TP1.1; also elsewhere on the board
GND: C6.2, D2.1 (K), D3.1 (K), D4.1 (K), D5.1 (K), D6.1 (K), J17.4, TP6.1, TP7.1; also elsewhere on the board
I2C_SCL: J17.3; also elsewhere on the board
I2C_SDA: J17.2; also elsewhere on the board
LED2_A: D2.2 (A), R20.2
LED3_A: D3.2 (A), R21.2
LED4_A: D4.2 (A), R22.2
LED5_A: D5.2 (A), R23.2
LED6_A: D6.2 (A), R24.2
SPARE_GPIO33: TP8.1; also elsewhere on the board

Notes on the sheet:
Diagnostics
Same global net name = electrical connection across all pages

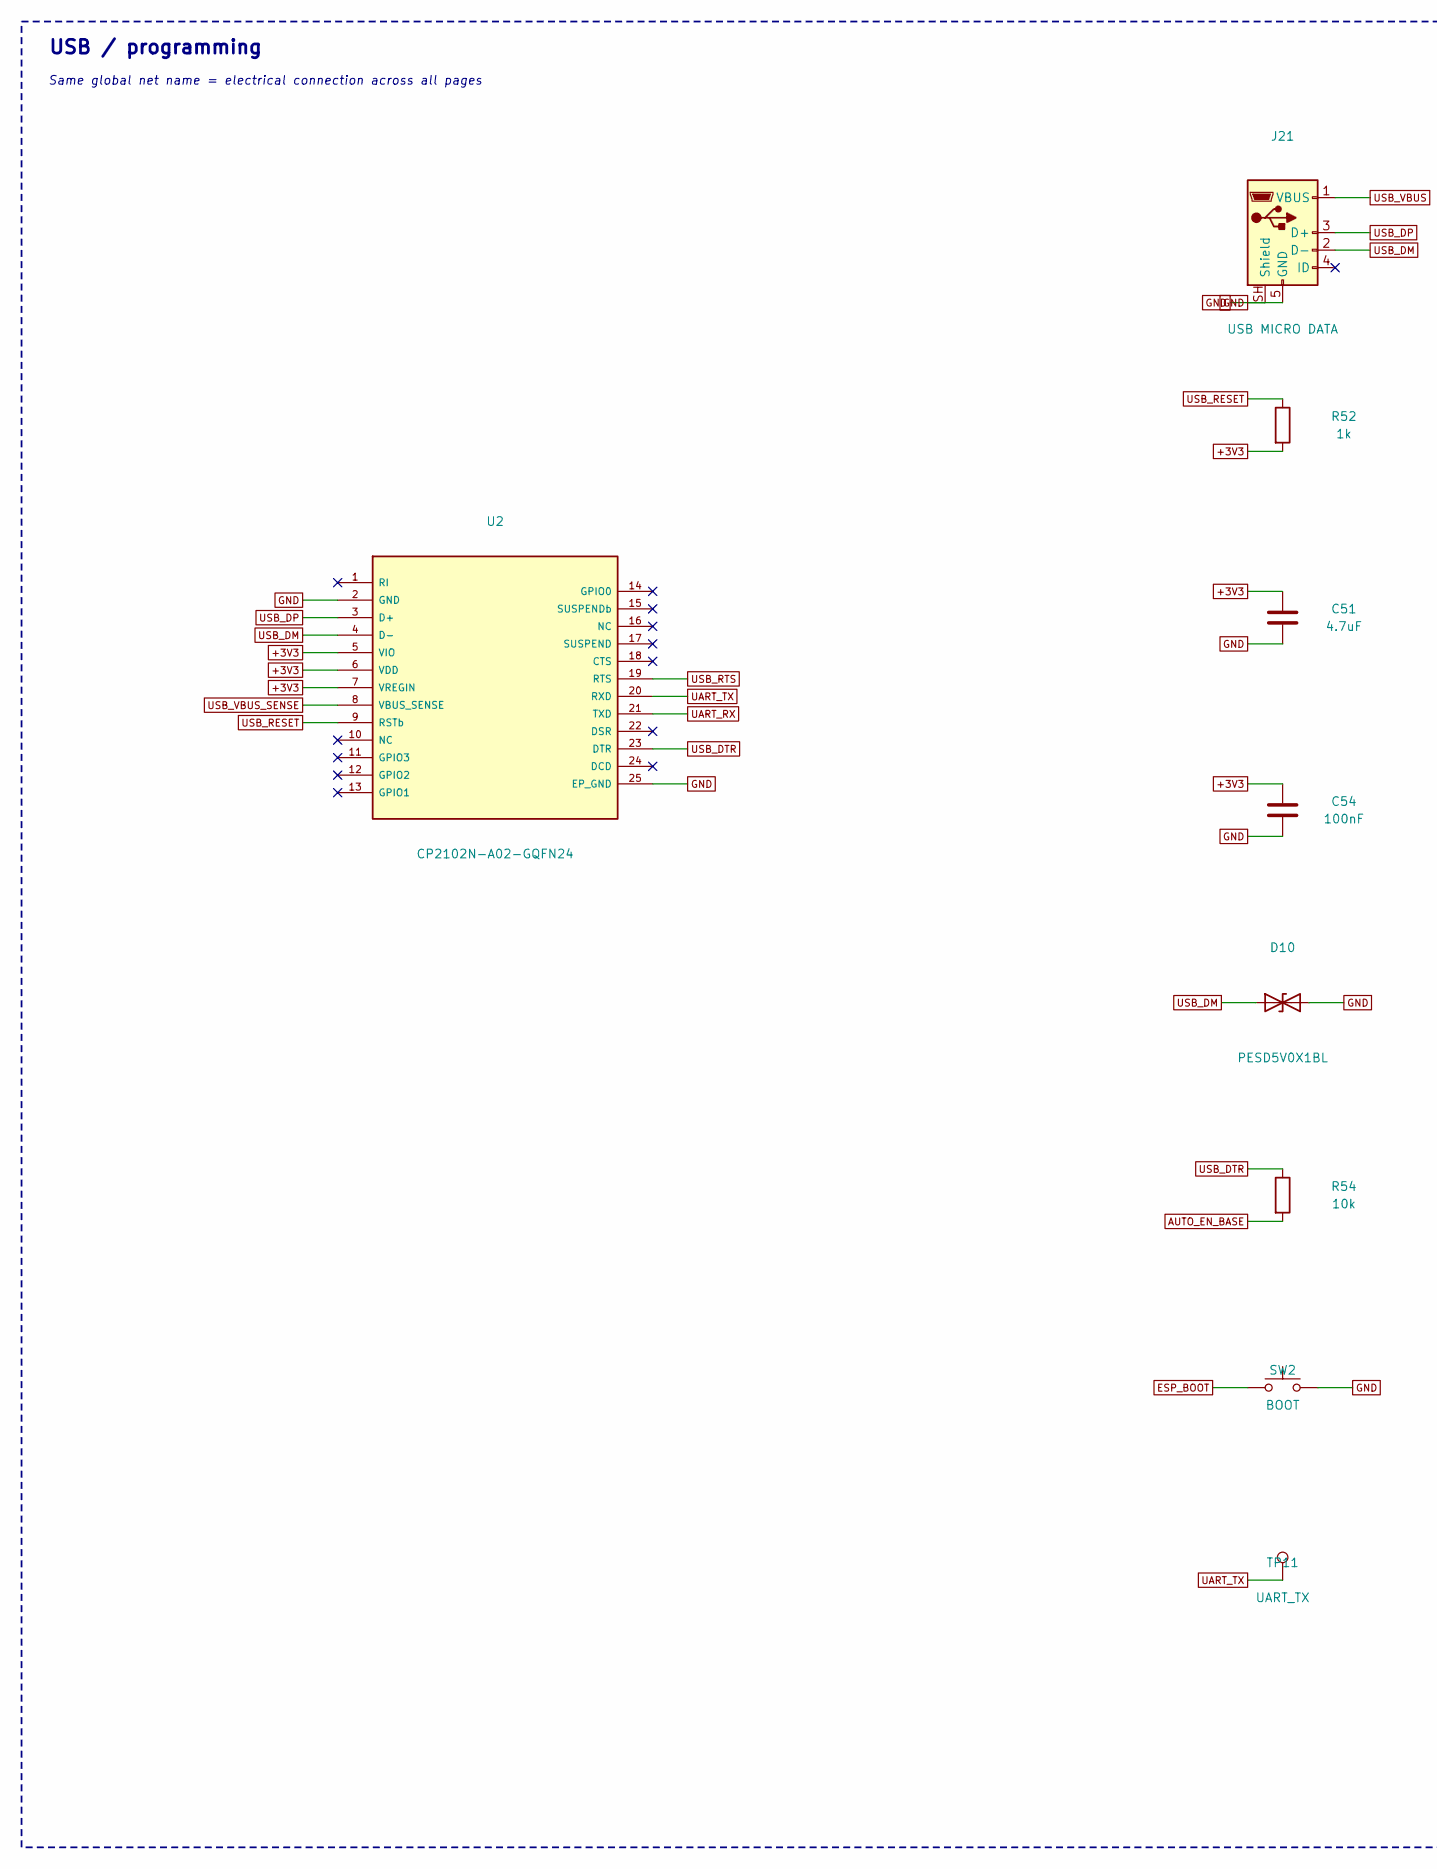
[picture p45: schematic FV-CTRL_RevB-09.kicad_sch, FV-CTRL RevB / USB / programming, part in row 1, column 1]

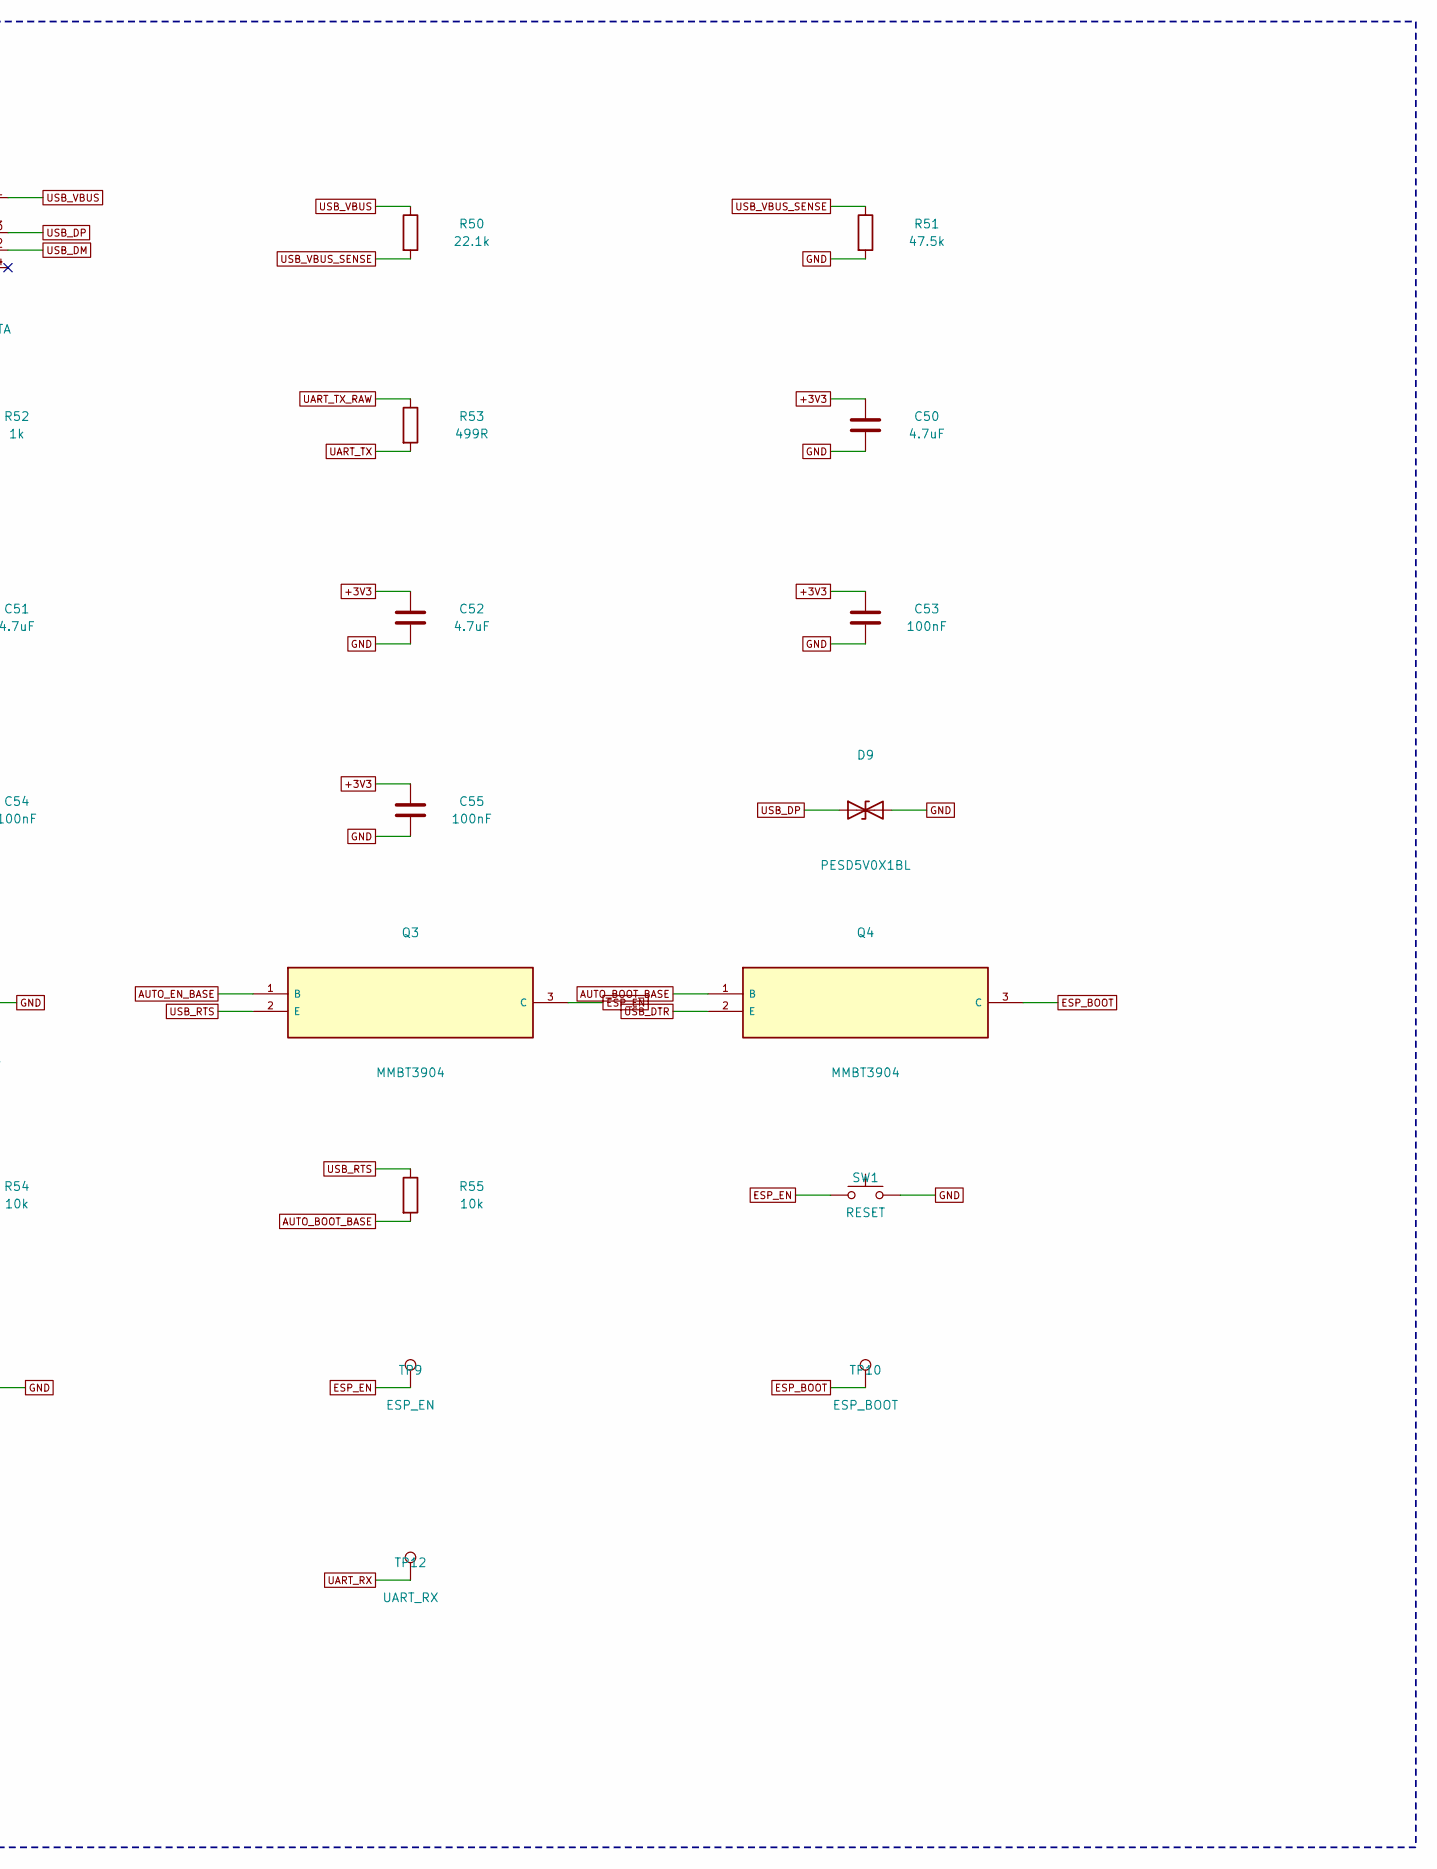
[picture p46: schematic FV-CTRL_RevB-09.kicad_sch, FV-CTRL RevB / USB / programming, part in row 1, column 2]

Parts:
C50, C51, C52: 4.7uF; C_0402_1005Metric
C53, C54, C55: 100nF; C_0402_1005Metric
D9, D10: PESD5V0X1BL; D_SOD-882
J21: USB MICRO DATA; USB_Micro-B_Molex-105017-0001
Q3, Q4: MMBT3904; SOT-23
R50: 22.1k; R_0402_1005Metric
R51: 47.5k; R_0402_1005Metric
R52: 1k; R_0402_1005Metric
R53: 499R; R_0402_1005Metric
R54, R55: 10k; R_0402_1005Metric
SW1: RESET; SW_PUSH_6mm
SW2: BOOT; SW_PUSH_6mm
TP9: ESP_EN; Keystone_5000_Carrier_D3
TP10: ESP_BOOT; Keystone_5000_Carrier_D3
TP11: UART_TX; Keystone_5000_Carrier_D3
TP12: UART_RX; Keystone_5000_Carrier_D3
U2: CP2102N-A02-GQFN24; QFN-24-1EP_4x4mm_P0.5mm_EP2.6x2.6mm_ThermalVias

Connections:
+3V3: C50.1, C51.1, C52.1, C53.1, C54.1, C55.1, R52.2, U2.5 (VIO), U2.6 (VDD), U2.7 (VREGIN); also elsewhere on the board
AUTO_BOOT_BASE: Q4.1 (B), R55.2
AUTO_EN_BASE: Q3.1 (B), R54.2
ESP_BOOT: Q4.3 (C), SW2.1, TP10.1; also elsewhere on the board
ESP_EN: Q3.3 (C), SW1.1, TP9.1; also elsewhere on the board
GND: C50.2, C51.2, C52.2, C53.2, C54.2, C55.2, D9.2 (A2), D10.2 (A2), J21.5 (GND), J21.SH (Shield), R51.2, SW1.2, SW2.2, U2.2 (GND), U2.25 (EP_GND); also elsewhere on the board
UART_RX: TP12.1, U2.21 (TXD); also elsewhere on the board
UART_TX: R53.2, TP11.1, U2.20 (RXD)
UART_TX_RAW: R53.1; also elsewhere on the board
USB_DM: D10.1 (A1), J21.2 (D-), U2.4 (D-)
USB_DP: D9.1 (A1), J21.3 (D+), U2.3 (D+)
USB_DTR: Q4.2 (E), R54.1, U2.23 (DTR)
USB_RESET: R52.1, U2.9 (RSTb)
USB_RTS: Q3.2 (E), R55.1, U2.19 (RTS)
USB_VBUS: J21.1 (VBUS), R50.1
USB_VBUS_SENSE: R50.2, R51.1, U2.8 (VBUS_SENSE)

Notes on the sheet:
USB / programming
Same global net name = electrical connection across all pages

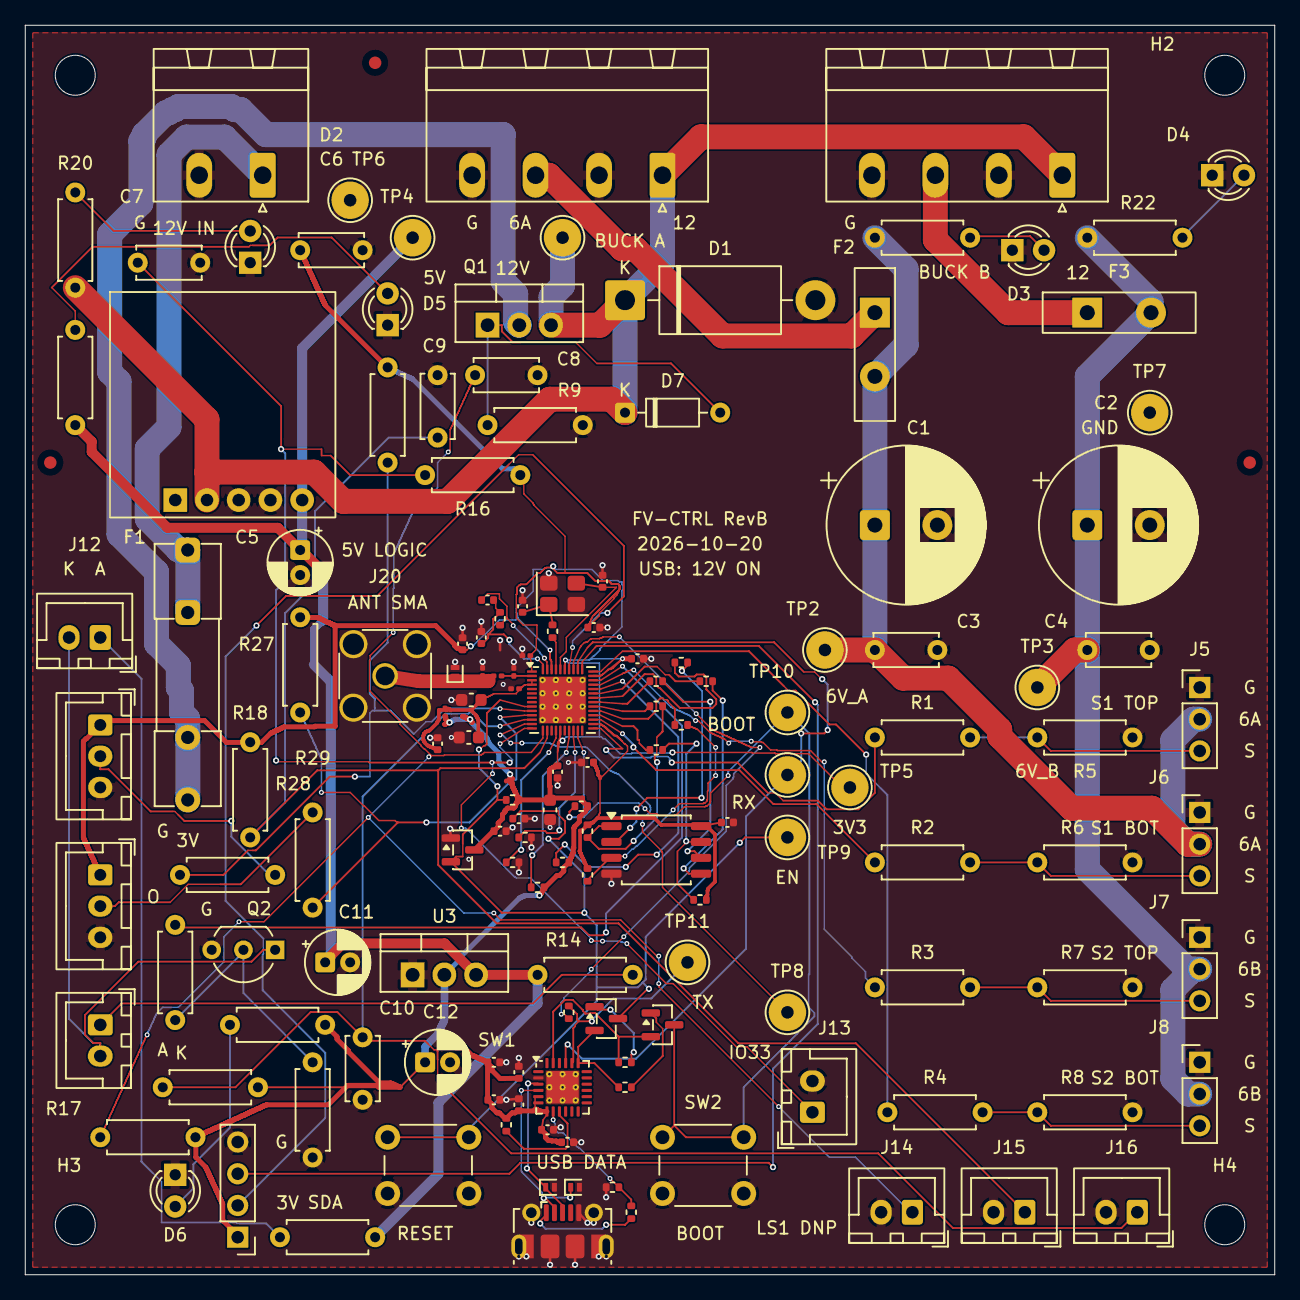
[picture p47: board FV-CTRL_RevB.kicad_pcb from above]

Board: 2 copper layers, 100.0 x 100.0 mm, 152 parts (0 on the bottom side), 79 nets.

Other parts of the board:
FID1, FID2, FID3: Fiducial_1mm_Mask2mm
