Masterltb/pcb/hardware/reva2/FV-IR-RX_RevA2.kicad_pcb

## KiCad design hardware/reva2/FV-IR-RX_RevA2.kicad_pcb (2026-10-20)

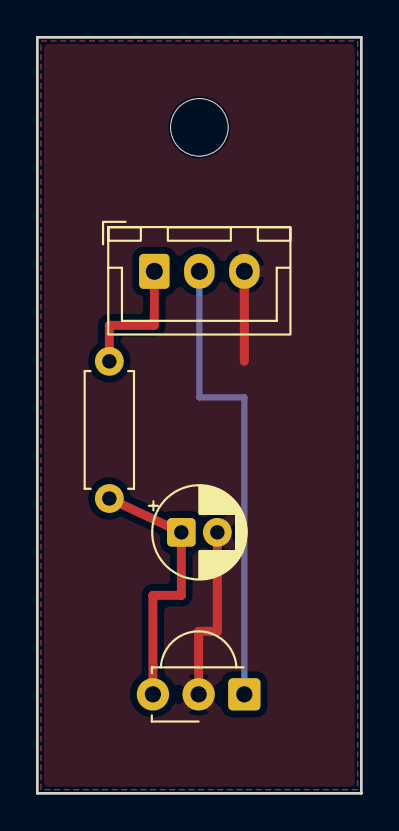
[picture p48: board FV-IR-RX_RevA2.kicad_pcb from above]

Board: 2 copper layers, 18.0 x 42.0 mm, 5 parts (0 on the bottom side), 4 nets.

Parts:
C1: 4.7uF; CP_Radial_D5.0mm_P2.00mm
H1: MountingHole_3.2mm_M3
J1: JST_XH_3P; JST_XH_B3B-XH-A_1x03_P2.50mm_Vertical
R1: 100R; R_Axial_DIN0207_L6.3mm_D2.5mm_P7.62mm_Horizontal
U1: TSOP38238; Vishay_MINICAST-3Pin

Connections:
+3V3: J1.1, R1.1
/+3V3_FILT: C1.1, R1.2, U1.3
/IR_RX_OUT: J1.2, U1.1
GND: C1.2, J1.3, U1.2
