Masterltb/pcb/FV-CTRL_RevA_Handover/03_KiCad_Source_Design/FV-CTRL_RevA.kicad_pcb

## KiCad design FV-CTRL_RevA_Handover/03_KiCad_Source_Design/FV-CTRL_RevA.kicad_pcb (2026-10-18)

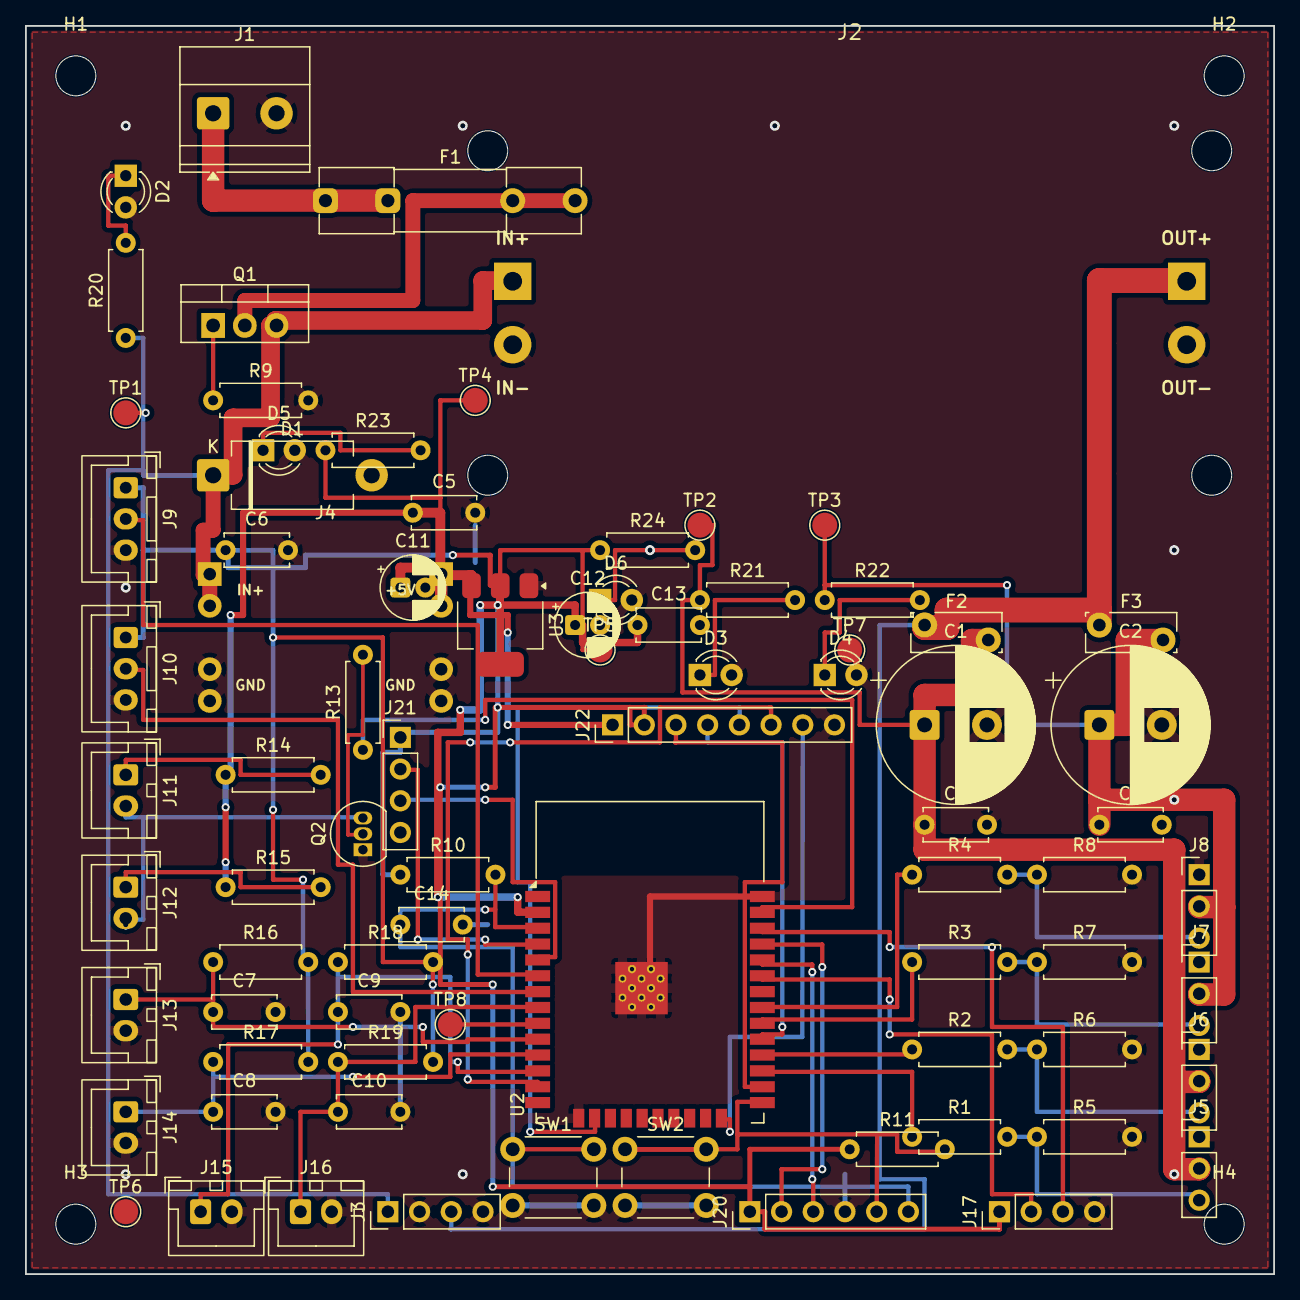
[picture p49: board FV-CTRL_RevA.kicad_pcb from above]

Board: 2 copper layers, 100.0 x 100.0 mm, 84 parts (0 on the bottom side), 48 nets.

Parts:
C1, C2: 1000-2200uF 16V; CP_Radial_D12.5mm_P5.00mm
C3, C4, C6, C13, C14: 100nF; C_Disc_D5.0mm_W2.5mm_P5.00mm
C5: 10uF 16V; C_Disc_D5.0mm_W2.5mm_P5.00mm
C7, C8, C9, C10: 100nF (DNP); C_Disc_D5.0mm_W2.5mm_P5.00mm
C11: 10uF 16V; CP_Radial_D5.0mm_P2.00mm
C12: 22uF 16V; CP_Radial_D5.0mm_P2.00mm
D1: 1.5KE15CA; D_DO-201_P12.70mm_Horizontal
D2: LED_+12V; LED_D3.0mm
D3: LED_+6V_A; LED_D3.0mm
D4: LED_+6V_B; LED_D3.0mm
D5: LED_+5V; LED_D3.0mm
D6: LED_+3V3; LED_D3.0mm
F1: 5A 250V; Fuseholder_Clip-5x20mm_Littelfuse_111_Inline_P20.00x5.00mm_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
F2, F3: PTC 3A; Fuse_Bourns_MF-RG300
H1, H2, H3, H4: MountingHole_3.2mm_M3
J1: 12V_IN; TerminalBlock_Phoenix_MKDS-1,5-2-5.08_1x02_P5.08mm_Horizont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
J2: XH-M401 (6.0V 8A); Converter_DCDC_XH-M401_8A
J3: AUX_BUCK (DNP); PinHeader_1x04_P2.54mm_Vertical
J4: MP1584EN (5V Logic); Converter_DCDC_MP1584EN
J5: S1_TOP; PinHeader_1x03_P2.54mm_Vertical
J6: S1_BOT; PinHeader_1x03_P2.54mm_Vertical
J7: S2_TOP; PinHeader_1x03_P2.54mm_Vertical
J8: S2_BOT; PinHeader_1x03_P2.54mm_Vertical
J9: IR_RX1; JST_XH_B3B-XH-A_1x03_P2.50mm_Vertical
J10: IR_RX2; JST_XH_B3B-XH-A_1x03_P2.50mm_Vertical
J11: IR_TX1 (Col 1); JST_XH_B2B-XH-A_1x02_P2.50mm_Vertical
J12: IR_TX2 (Col 2); JST_XH_B2B-XH-A_1x02_P2.50mm_Vertical
J13: LS1 (DNP); JST_XH_B2B-XH-A_1x02_P2.50mm_Vertical
J14: LS2 (DNP); JST_XH_B2B-XH-A_1x02_P2.50mm_Vertical
J15: LS3 (DNP); JST_XH_B2B-XH-A_1x02_P2.50mm_Vertical
J16: LS4 (DNP); JST_XH_B2B-XH-A_1x02_P2.50mm_Vertical
J17: I2C_RESERVED; PinHeader_1x04_P2.54mm_Vertical
J20: PROG_UART0; PinHeader_1x06_P2.54mm_Vertical
J21: SENSOR_ADC; PinHeader_1x04_P2.54mm_Vertical
J22: SENSOR_DIGITAL; PinHeader_1x08_P2.54mm_Vertical
Q1: IRF9540N; TO-220-3_Vertical
Q2: S8050; TO-92_Inline
R1, R2, R3, R4: 330R; R_Axial_DIN0207_L6.3mm_D2.5mm_P7.62mm_Horizontal
R5, R6, R7, R8, R9, R10, R11: 10k; R_Axial_DIN0207_L6.3mm_D2.5mm_P7.62mm_Horizontal
R13: 1k; R_Axial_DIN0207_L6.3mm_D2.5mm_P7.62mm_Horizontal
R14, R15: 120R; R_Axial_DIN0207_L6.3mm_D2.5mm_P7.62mm_Horizontal
R16, R17, R18, R19: 10k (DNP); R_Axial_DIN0207_L6.3mm_D2.5mm_P7.62mm_Horizontal
R20: 5.6k; R_Axial_DIN0207_L6.3mm_D2.5mm_P7.62mm_Horizontal
R21, R22: 2.2k; R_Axial_DIN0207_L6.3mm_D2.5mm_P7.62mm_Horizontal
R23: 1.5k; R_Axial_DIN0207_L6.3mm_D2.5mm_P7.62mm_Horizontal
R24: 1.0k; R_Axial_DIN0207_L6.3mm_D2.5mm_P7.62mm_Horizontal
SW1: SW_EN; SW_PUSH_6mm_H5mm
SW2: SW_BOOT; SW_PUSH_6mm_H5mm
TP1: TP_+12V; TestPoint_Pad_D2.0mm
TP2: TP_+6V_A; TestPoint_Pad_D2.0mm
TP3: TP_+6V_B; TestPoint_Pad_D2.0mm
TP4: TP_+5V; TestPoint_Pad_D2.0mm
TP5: TP_+3V3; TestPoint_Pad_D2.0mm
TP6, TP7: TP_GND; TestPoint_Pad_D2.0mm
TP8: TP_SPARE_GPIO33; TestPoint_Pad_D2.0mm
U2: ESP32-WROOM-32; ESP32-WROOM-32_HandSolder
U3: AMS1117-3.3; SOT-223-3_TabPin2

Connections:
+3V3: C6.1, C12.1, C13.1, J9.1, J10.1, J17.1, J20.1, J21.1, J22.2, R10.1, R11.1, R16.2, R17.2, R18.2, R19.2, R24.1, TP5.1, U2.2, U3.2
+5V: C5.1, C11.1, J4.3, J22.1, R14.1, R15.1, R23.1, TP4.1, U3.3
+6V_A: C1.1, C3.1, F2.2, J5.2, J6.2, R21.1, TP2.1
+6V_B: C2.1, C4.1, F3.2, J7.2, J8.2, R22.1, TP3.1
+6V_SERVO: F2.1, F3.1, J2.3, J3.3
+12V: D1.1, J2.1, J3.1, J4.1, Q1.3, R20.1, TP1.1
+12V_FUSED: F1.2, Q1.2
+12V_IN: F1.1, J1.1
ADC_VN: J21.3, U2.5
ADC_VP: J21.2, U2.4
ESP_EN: C14.1, J20.6, R10.2, SW1.1, U2.3
ESP_IO0: J20.5, R11.2, SW2.1, U2.25
ESP_IR_TX: R13.1, U2.37
ESP_RXD0: J20.3, U2.34
ESP_S1_BOT_PWM: R2.1, U2.28
ESP_S1_TOP_PWM: R1.1, U2.27
ESP_S2_BOT_PWM: R4.1, U2.31
ESP_S2_TOP_PWM: R3.1, U2.30
ESP_TXD0: J20.2, U2.35
EXP_IO2: J22.7, U2.24
EXP_IO4: J22.3, U2.26
EXP_IO5: J22.4, U2.29
EXP_IO13: J22.5, U2.16
EXP_IO14: J22.6, U2.13
GND: C1.2, C2.2, C3.2, C4.2, C5.2, C6.2, C7.2, C8.2, C9.2, C10.2, C11.2, C12.2, C13.2, C14.2, D1.2, D2.2, D3.2, D4.2, D5.2, D6.2, J1.2, J2.2, J2.4, J3.2, J3.4, J4.2, J4.4, J5.1, J6.1, J7.1, J8.1, J9.3, J10.3, J13.2, J14.2, J15.2, J16.2, J17.4, J20.4, J21.4, J22.8, Q2.1, R5.2, R6.2, R7.2, R8.2, R9.2, SW1.2, SW2.2, TP6.1, TP7.1, U2.1, U2.15, U2.38, U2.39, U3.1
I2C_SCL: J17.3, U2.36
I2C_SDA: J17.2, U2.33
IR_RX1: J9.2, U2.6
IR_RX2: J10.2, U2.7
IR_TX_RET: J11.2, J12.2, Q2.3
LS1: C7.1, J13.1, R16.1, U2.10
LS2: C8.1, J14.1, R17.1, U2.11
LS3: C9.1, J15.1, R18.1, U2.12
LS4: C10.1, J16.1, R19.1, U2.8
NET_D2_ANODE: D2.1, R20.2
NET_D3_ANODE: D3.1, R21.2
NET_D4_ANODE: D4.1, R22.2
NET_D5_ANODE: D5.1, R23.2
NET_D6_ANODE: D6.1, R24.2
NET_IR_TX1_ANODE: J11.1, R14.2
NET_IR_TX2_ANODE: J12.1, R15.2
NET_Q1_GATE: Q1.1, R9.1
NET_Q2_BASE: Q2.2, R13.2
S1_BOT_PWM: J6.3, R2.2, R6.1
S1_TOP_PWM: J5.3, R1.2, R5.1
S2_BOT_PWM: J8.3, R4.2, R8.1
S2_TOP_PWM: J7.3, R3.2, R7.1
SPARE_GPIO33: TP8.1, U2.9
