Masterltb/pcb/docs/revb/FV-CTRL_RevB-pins.h

#pragma once
// FV-CTRL RevB; fixed PROJECT.md mapping. Pin map only, not control firmware.
constexpr int SERVO_1_TOP = 16;
constexpr int SERVO_1_BOTTOM = 17;
constexpr int SERVO_2_TOP = 18;
constexpr int SERVO_2_BOTTOM = 19;
constexpr int IR_TX = 23;
constexpr int IR_RX_1 = 34;
constexpr int IR_RX_2 = 35;
constexpr int LIMIT_1_TOP = 25;
constexpr int LIMIT_1_BOTTOM = 26;
constexpr int LIMIT_2_TOP = 27;
constexpr int LIMIT_2_BOTTOM = 32;
constexpr int I2C_SDA = 21;
constexpr int I2C_SCL = 22;
constexpr int SPARE = 33;
