Masterltb/pcb/(commit log)

2026-10-15 chore: init project foundation
    - Add .gitignore for Python, KiCad, OS, IDE artifacts
    - Add CLAUDE.md: project rules and architecture constraints
    - Add PROJECT.md: FV-CTRL Rev A project brief and pin assignments
2026-10-15 feat(tools): add project audit and pipeline scripts
    - audit_fv_project.py: gate checks for KiCad env, symbols, ERC status
    - fv_pipeline.py: orchestrates audit -> schematic -> erc stages
    - validate_fv_design.py: validates net/component manifest structure
2026-10-15 feat(tools): add KiCad 10 schematic generator
    generate_fv_schematic.py:
    - Self-contained deterministic Python generator for FV-CTRL RevA
    - Produces valid KiCad 10 S-expression .kicad_sch
    - Built-in pin coordinate database for all library symbols
    - Embeds lib_symbols cache (Device, Connector_Generic, power)
    - Places 50 components across 27 nets
    - Adds PWR_FLAG on all power rails to suppress ERC warnings
    - Verified: kicad-cli ERC -> 0 errors, 0 warnings
    [generate_fv_schematic.py]
2026-10-15 feat(hardware): add FV-CTRL RevA schematic and manifests
    - FV-CTRL_RevA.sch: legacy conceptual schematic (reference only)
    - FV-CTRL_RevA.kicad_sch: native KiCad 10 schematic (machine-generated)
    * 50 components, 27 nets, full pin-level wire connections
    * ERC clean: 0 errors, 0 warnings
    - FV-CTRL_RevA.net.json: backward-compatible netlist (27 nets)
    - FV-CTRL_RevA.manifest.json: machine-readable BOM + net manifest
    [FV-CTRL_RevA.kicad_sch, FV-CTRL_RevA.sch]
2026-10-15 test: add automated test suite for schematic pipeline
    tests/test_code_generation.py:
    - test_pipeline_stages: verifies pipeline stage list
    - test_schematic_structure: validates .kicad_sch S-expression structure
    - test_manifest_content: checks 50 components and 27 nets in manifest
    - test_kicad_cli_erc: runs kicad-cli ERC and asserts 0 violations
    All 4 tests passing.
2026-10-15 docs: add project documentation and ERC reports
    - docs/audit-revA.md: gate status DRAFT READY, all checks passing
    - docs/requirements-and-blockers.md: architecture decisions, 5 production
    blockers (footprints, ESP32 row pitch, BOM confirmation, Gerber export,
    IR RX satellite board)
    - docs/FV-CTRL_RevA-bom-draft.md: full draft BOM (50 line items)
    - reports/erc.rpt + reports/erc.json: KiCad ERC results
    (0 Errors, 0 Warnings, exit code 0)
2026-10-15 feat(docs): add exported schematic visuals
    - FV-CTRL_RevA-schematic.pdf: printable A3 schematic export (kicad-cli)
    - FV-CTRL_RevA_schematic.svg: SVG flat export
    - FV-CTRL_RevA-schematic.svg/: SVG directory export from KiCad CLI
2026-10-15 docs: add comprehensive README for agents and humans
    - Full system architecture diagram (power tree + GPIO map)
    - Complete directory map with file descriptions
    - Gate status table (DRAFT READY vs BLOCKED stages)
    - 5 open design blockers listed with resolution actions
    - Component table, ESP32 pin assignments
    - Toolchain setup + PowerShell command reference
    - Next-step workflow (schematic -> footprint -> layout -> Gerber)
    - Critical agent rules (read PROJECT.md/CLAUDE.md, no fake footprints,
    burst mode IR TX, no pin reassignment without user approval)
2026-10-16 fix(sch): standardize ESP32 header references to J18/J19 and update audit status
    - Rename J_ESP32_L / J_ESP32_R to standard KiCad annotations J18 / J19
    - Regenerate KiCad schematic, manifest, netlist JSON, draft BOM, and ERC reports
    - Eliminate netlist export annotation warnings
    - Update automated tests in test_code_generation.py for J18 and J19
    - Resolve contradiction in audit_fv_project.py and audit-revA.md regarding schematic existence
    - Track AGENTS.md rules
    [FV-CTRL_RevA.kicad_sch]
2026-10-16 feat(sch): add native KiCad 10 schematics and ERC verification for IR RX satellite boards
    - Generate FV-IR-RX_RevA.kicad_sch (universal), FV-IR-RX1, and FV-IR-RX2
    - Complete RC supply filter (100R + 4.7uF) and JST-XH 3-pin cable interface
    - Integrate into fv_pipeline.py and test_code_generation.py with 0 ERC violations
    - Update audit-revA.md status
    [FV-CTRL_RevA.kicad_sch, FV-IR-RX1_RevA.kicad_sch, FV-IR-RX2_RevA.kicad_sch, FV-IR-RX_RevA.kicad_sch]
2026-10-16 feat(footprint): add verified native KiCad footprints for XH-M401 and MP1584EN modules
2026-10-16 feat(sch): synchronize schematics, manifests, and zero-violation ERC reports
    [FV-CTRL_RevA.kicad_sch, FV-IR-RX1_RevA.kicad_sch, FV-IR-RX2_RevA.kicad_sch, FV-IR-RX_RevA.kicad_sch]
2026-10-16 feat(pcb): implement native layout, A* maze router, and zero-DRC board generation
    [FV-CTRL_RevA.kicad_pcb, FV-IR-RX1_RevA.kicad_pcb, FV-IR-RX2_RevA.kicad_pcb, FV-IR-RX_RevA.kicad_pcb]
2026-10-16 ci(pipeline): add board generation, DRC checks, and full automated test suite
2026-10-16 release: generate fabrication gerbers, 3D STEP models, BOM, and complete handover package
    [FV-CTRL_RevA-B_Courtyard.gbr, FV-CTRL_RevA-B_Cu.gbl, FV-CTRL_RevA-B_Fab.gbr, FV-CTRL_RevA-B_Mask.gbs, FV-CTRL_RevA-B_Paste.gbp, FV-CTRL_RevA-B_Silkscreen.gbo, FV-CTRL_RevA-Edge_Cuts.gm1, FV-CTRL_RevA-F_Courtyard.gbr]
2026-10-18 feat(cad): add 3D machine assembly, dual-tier iris kinematics simulation, and engineering report
    [FreshVend_Machine_3D.FCStd, FreshVend_Machine_Assembly.step, Fruit_Bowl_170mm.stl, Iris_Blades_x6_Closed.stl, Iris_Drive_Rotor_Ring.stl, Iris_Retaining_Cover.stl, Iris_Stator_Base.stl, Servo_MG996R_Bracket.stl]
2026-10-18 feat(footprint): add ESP32-WROOM-32 hand-solder footprint with extended pads and DFM courtyard
2026-10-18 feat(sch): migrate ESP32 to SMD module, add AMS1117-3.3 LDO subsystem, and expansion sensor headers
    [FV-CTRL_RevA.kicad_sch]
2026-10-18 feat(pcb): implement zero-DRC layout with vector segment obstacles, via clearance grid, and 100% net routing
    [FV-CTRL_RevA.kicad_pcb, FV-IR-RX1_RevA.kicad_pcb, FV-IR-RX1_RevA.kicad_sch, FV-IR-RX2_RevA.kicad_pcb, FV-IR-RX2_RevA.kicad_sch, FV-IR-RX_RevA.kicad_pcb, FV-IR-RX_RevA.kicad_sch]
2026-10-18 release(v1.1.0): export updated Gerbers, Excellon drill files, 3D STEP models, and complete handover package
    [FV-CTRL_RevA-B_Courtyard.gbr, FV-CTRL_RevA-B_Cu.gbl, FV-CTRL_RevA-B_Fab.gbr, FV-CTRL_RevA-B_Mask.gbs, FV-CTRL_RevA-B_Paste.gbp, FV-CTRL_RevA-B_Silkscreen.gbo, FV-CTRL_RevA-Edge_Cuts.gm1, FV-CTRL_RevA-F_Courtyard.gbr]
2026-10-20 docs: record confirmed dispenser load and two-buck requirements
2026-10-20 docs: review external dual-buck revision before PCB changes
2026-10-20 feat(hardware): add reviewed external dual-buck RevA2 schematic
    [FV-CTRL_RevA2-bom.csv, FV-CTRL_RevA2.kicad_sch]
2026-10-20 feat(pcb): route RevA2 with 2mm power paths and clean parity DRC
    [FV-CTRL_RevA2-bom.csv, FV-CTRL_RevA2.kicad_pcb, FV-CTRL_RevA2.kicad_sch]
2026-10-20 Add external IR pullups and qualify RevA2 component sourcing
    [FV-CTRL_RevA2-bom.csv, FV-CTRL_RevA2.kicad_pcb, FV-CTRL_RevA2.kicad_sch]
2026-10-20 Synchronize TSOP38238 RX RevA2 schematic and routed board
    [FV-IR-RX_RevA2-bom.csv, FV-IR-RX_RevA2.kicad_pcb, FV-IR-RX_RevA2.kicad_sch]
2026-10-20 Document RevA2 review, assembly and physical qualification gates
2026-10-20 chore(kicad): track RX RevA2 project configuration
2026-10-20 docs: review bare ESP32 QFN and SMA architecture before RevB redesign
2026-10-20 feat(hardware): add bare ESP32 RevB functional schematic and independent pin checks
    [FV-CTRL_RevB-01.kicad_sch, FV-CTRL_RevB-02.kicad_sch, FV-CTRL_RevB-03.kicad_sch, FV-CTRL_RevB-04.kicad_sch, FV-CTRL_RevB-05.kicad_sch, FV-CTRL_RevB-06.kicad_sch, FV-CTRL_RevB-07.kicad_sch, FV-CTRL_RevB-08.kicad_sch]
2026-10-20 feat(hardware): add reset supervisor and thermal EP to bare ESP32 core
    [FV-CTRL_RevB-01.kicad_sch, FV-CTRL_RevB-02.kicad_sch, FV-CTRL_RevB-03.kicad_sch, FV-CTRL_RevB-04.kicad_sch, FV-CTRL_RevB-05.kicad_sch, FV-CTRL_RevB-06.kicad_sch, FV-CTRL_RevB-07.kicad_sch, FV-CTRL_RevB-08.kicad_sch]
2026-10-20 fix(hardware): increase flash brownout margin and account for RF ESD capacitance
    [FV-CTRL_RevB-02.kicad_sch, FV-CTRL_RevB-03.kicad_sch, FV-CTRL_RevB-bom-draft.csv]
2026-10-20 feat(pcb): place bare ESP32 core and route power, clock and SMA before signals
    [FV-CTRL_RevB.kicad_pcb]
2026-10-20 feat(pcb): order QFN escapes and reconnect local supplies before signal routing
    Keep two servo rails and GPIO unchanged. Use 0.4/0.2mm escape vias, move C23 to 0201 and preserve ground beneath clock/RF. ERC has zero violations; native DRC has no physical errors or parity differences, with 100 opens and 33 dangling warnings at this intermediate checkpoint. Not a fabrication release.
    [FV-CTRL_RevB-02.kicad_sch, FV-CTRL_RevB-03.kicad_sch, FV-CTRL_RevB-09.kicad_sch, FV-CTRL_RevB.kicad_pcb]
2026-10-20 feat(pcb): complete RevB routing, ground returns and service markings
    Finish signal and supply connections, repair USB escape and C40 ground, and remove 24 redundant copper items. Apply 1mm/0.15mm silk rules, 0.025mm mask expansion and 0.10mm minimum mask web. Native KiCad ERC/DRC, opens and schematic parity are all zero. RF, thermal and hardware qualification remain pending; no Gerber release.
    [FV-CTRL_RevB.kicad_pcb]
2026-10-20 fix(pcb): keep ordinary ground drills outside SMT mask openings
    Move USB shield/pin-5 and supervisor ground vias outside reflow openings. Use 0.4/0.2mm ground vias at C13/C15. Supplement native ERC/DRC with a conservative drill-to-mask check: minimum 0.05mm geometric guard, excluding thermal EP holes that require factory review. All software checks pass.
    [FV-CTRL_RevB.kicad_pcb]
2026-10-20 docs(pcb): package RevB native review, assembly BOM and bring-up checks
    Include ten schematic pages, front/back assembly views, 62-part SMT BOM/CPL, thermal EP drill map, source hashes and checked native hierarchy. Record RF, stencil, stock, thermal, servo and mechanical qualification gates. Engineering review only; no Gerber or factory upload.
    [FV-CTRL_RevB-EP-vias.csv, FV-CTRL_RevB-SMT-position-review.csv, FV-CTRL_RevB-SMT-quote.csv, FV-CTRL_RevB-THT-assembly.csv, FV-CTRL_RevB-bom-draft.csv, FV-CTRL_RevB-bom-review.csv]
2026-10-20 refactor(repo): separate current RevB sources from legacy hardware and exports
    Group hardware, documents, verification reports and release packages by revision. Preserve pre-existing RevA edits as unstaged changes at their new archive paths. Update KiCad library tables and add entry-point documentation. No PCB copper, GPIO or net changes; RevB/RevA2 ERC and DRC remain clean.
    [FV-CTRL_RevA-B_Courtyard.gbr, FV-CTRL_RevA-B_Cu.gbl, FV-CTRL_RevA-B_Fab.gbr, FV-CTRL_RevA-B_Mask.gbs, FV-CTRL_RevA-B_Paste.gbp, FV-CTRL_RevA-B_Silkscreen.gbo, FV-CTRL_RevA-Edge_Cuts.gm1, FV-CTRL_RevA-F_Courtyard.gbr]
2026-10-20 refactor(tools): follow revision directories and isolate routing scratch outputs
    Update native checks, routing helpers, BOM/package tools and legacy generator paths. Keep per-project relative library paths and create ignored work directories when required. Legacy generator tests are not run against pre-existing local edits; all Python sources compile, while actual RevB and RevA2 ERC/DRC checks pass.
2026-10-20 docs(release): refresh portable RevB review package for organized repository
    Refresh relocated verification reports and ZIP with per-revision source/library paths. Verify archived dirty files byte-for-byte, unchanged RevB PCB data, package CRC/SHA256, and clean ERC/DRC after extraction. Keep old Gerber archives and local edits separate; no fabrication release.
2026-10-22 docs: add reusable PCB agent harness
    [interfaces.csv, requirements.csv, risk-register.csv]
